gniliac1/COSIMA-Laserstar/README.md

COSIMA-Laserstar
================

Laserharfe

Hier entsteht das Repository für den COSIMA-Wettbewerb.

Weitere Infos folgen in Kürze ...
