gniliac1/COSIMA-Laserstar/Dokumentation/Abschlussbericht/Abschlussbericht.tex

\documentclass[a4paper,titlepage,12pt]{scrreprt}

\usepackage{ucs}
\usepackage[utf8x]{inputenc}
\usepackage[T1]{fontenc}
\usepackage[ngerman]{babel}
\usepackage{datetime}
\usepackage{amssymb}
\usepackage[hidelinks]{hyperref}
\usepackage{amsmath}
\usepackage{graphicx}
\usepackage{color}
\usepackage{titling}
\usepackage[figure]{hypcap}
\usepackage{subcaption}
\usepackage[official]{eurosym} % for €
\usepackage{units} % for correct spacing when using units
\usepackage{siunitx} % for tabular option S
\sisetup{unit-mode = text} % for using euro symbol
\usepackage{float}

% --------------Dokumenteinstellungen------------- %

% Schriftart ----------------------------------------------------------------
% - https://en.wikibooks.org/wiki/LaTeX/Fonts#Font_styles
% - https://de.overleaf.com/learn/latex/Font_typefaces#Reference_guide
\usepackage{tgadventor}

% Zeilenabstand ----------------------------------------------------------------
\usepackage{setspace}
\onehalfspacing  % 1,5 Zeilen (entspricht ang. dem doppelten Zelenabstand in Word)
\frenchspacing   % Kein doppeltes Leerzeichen nach '.' etc.

% Schusterjungen und Hurenkinder -----------------------------------------------
% Hiermit werden Schusterjungen und Hurenkinder verhindert
% Zur Info:
% http://de.wikipedia.org/wiki/Hurenkind_und_Schusterjunge
\clubpenalty = 10000
\widowpenalty = 10000
\displaywidowpenalty = 10000

% Seitenlayout --------------------------------------------------------------------
\usepackage{geometry}
\usepackage{vmargin}
% \setmarginsrb{leftmargin}{topmargin}{rightmargin}{bottommargin}%
%          {headheight}{headsep}{footheight}{footskip}
\setmarginsrb{35mm}{20mm}{25mm}{20mm} % 
			 {0mm}{10mm}{0mm}{10mm}
			 
% Tabellen --------------------------------------------------------------------
\usepackage{tabularx}
\newcolumntype{L}[1]{>{\raggedright\arraybackslash}p{#1}} % linksbündig mit Breitenangabe
\newcolumntype{C}[1]{>{\centering\arraybackslash}p{#1}} % zentriert mit Breitenangabe
\newcolumntype{R}[1]{>{\raggedleft\arraybackslash}p{#1}} % rechtsbündig mit Breitenangabe
			 
% Datum ------------------------------------------------------------------------
%	Diese Definition wird benötigt um auf der Titelseite nur Monat und Jahr aus-
%	zugeben.
\usepackage{datetime}
\newdateformat{titledate}{\monthname[\THEMONTH] \THEYEAR}
			 
\allowdisplaybreaks

% ------------Definitionsbereich------------ %

% zum Referenzieren
\newcommand{\refchapter}[1]{Kapitel~\ref{#1}}
\newcommand{\refsec}[1]{Abschnitt~\ref{#1}}
\newcommand{\reffig}[1]{Abbildung~\ref{#1}}
\newcommand{\reftab}[1]{Tabelle~\ref{#1}}

% für Quellen bei Bildern etc.
\newcommand{\source}[1]{{\scriptsize Quelle:~#1}}

% --------------Dokumentanfang------------- %

\begin{document}

% Titel
\include{raw/0_Titelblatt}

% Inhaltsverzeichnis
\tableofcontents
\newpage

% Einführung
\include{raw/1_Einleitung}
\include{raw/2_StandDerTechnik}
\include{raw/3_Aufbau}
\include{raw/4_Kosten}

\appendix

\include{raw/5_Ausblick}

\end{document}
