gniliac1/COSIMA-Laserstar/Dokumentation/Abschlussbericht/raw/5_Ausblick.tex

\chapter{Ausblick}
\label{ch:Ausblick}

An dieser Stelle möchten wir einen Ausblick geben, wie der von uns entwickelte Gestikulaser  weiterentwickelt wird. \\
Hier wäre zunächst einmal eine Verfeinerung der aktuell durchführbaren Gestenerkennung denkbar, die nicht nur die Stellung der Hand, sondern auch die Krümmung der einzelnen Finger berücksichtigt. Zu diesem Zweck wurde bereits ein Prototyp für einen Sensorhandschuh entwickelt, der in \reffig{fig:Sensorhandschuh} dargestellt ist.
\begin{figure}[H]
	\centering
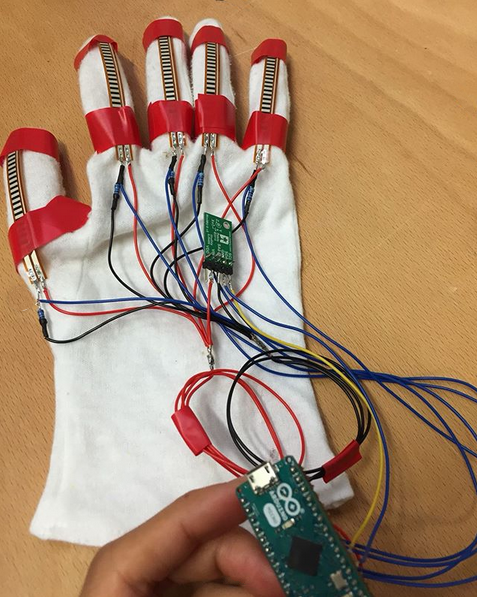
[picture p14: Dokumentation/figures/Sensorhandschuh.png]
	
	\caption{Aktueller Prototyp des Sensorhandschuhs. Es sind Biegesensoren für alle Finger, ein Gyroskop und ein Beschleunigungssensor im Einsatz. Bei der  
	Verarbeitung der Sensordaten kommt ein Arduino Micro zum Einsatz.}
	\label{fig:Sensorhandschuh}
\end{figure}
\noindent
Dieser könnte während der Trainingsphase vom Nutzer dazu verwendet werden, feinere Gesten aufzunehmen, wobei neben den von den Detektormodulen detektierten Photoströmen zusätzlich die Daten der auf dem Sensorhandschuh befindlichen Module gespeichert werden. Aktuell kommen hier Biegesensoren für jeden Finger, sowie ein Gyroskop und ein Beschleunigungssensor zum Einsatz. Diese verfeinerten Gestendaten stellen nun natürlich neue Herausforderungen an das Modell, das zur Auswertung der Photoströme im Live-Betrieb eingesetzt wird: Statt wie vorher den eingehenden Photoströmen nur das Klassenlabel einer Geste zuzuordnen, muss es nun in der Lage sein, auf Basis der gemessenen Photoströme die wahrscheinliche Lage der Hand, sowie die Krümmung der Finger vorauszusagen. Dieses Problem ist mathematisch deutlich schwieriger zu lösen, was nicht zuletzt an der deutlich höheren Anzahl an Parametern liegt, die bestimmt werden müssen, um eine ausreichende Aussagekraft des Modells zu gewährleisten. Aufgrund der höheren Anzahl an Parametern werden zudem auch mehr Daten benötigt, um das Modell zu trainieren. \\
Ebenfalls denkbar wäre eine Erweiterung auf dynamische Gesten, bei denen der Nutzer die Hand bewegt. In diesem Fall müssen die Daten der Photodioden im Live-Betrieb in Form einer Zeitreihe aufgenommen werden und das neuronale Netzmodell muss diese Zeitreihe mit einer Geste verknüpfen. Auch hier ergibt sich ein mathematisch deutlich komplexeres Problem, das ein aufwändigeres Training und viele Trainingsdaten erfordert. Die Erweiterung um dynamische Gesten könnte ebenfalls mit der Verwendung des Sensorhandschuhs kombiniert werden. \\
Auch die Wahl der Lichtquellen lässt noch Spielraum für künftige Änderungen. So könnte man z.B. statt den aktuell verbauten IR-LEDs Lichtquellen mit gepulsten Lichtstrahlen verwenden, um den Gestikulaser robuster gegenüber äußeren Einflüssen zu gestalten, da sich in diesem Fall die zu detektierenden Lichtsignale von möglichen Störsignalen durch eine deutlich höhere Intensität unterscheiden würden. Ebenfalls denkbar wäre der Einsatz einer Laserquelle, wodurch ein größerer Abstand zwischen der Hand des Nutzers und dem Gestikulaser realisiert werden könnte.
