gniliac1/COSIMA-Laserstar/Dokumentation/Abschlussbericht/raw/0_Titelblatt.tex

\newdateformat{mydate}{\monthname[\THEMONTH] \THEYEAR} 

\begin{titlepage}

	\newgeometry{left=30mm,right=-25mm,top=32mm,bottom=25mm}  
    
    % Kopfzeile
	\begin{table}[h!]
		\begin{tabular}{rp{5cm}l}
 		 & &  \\
		\end{tabular}
	\end{table}
    
    \small
	\parindent0pt
	
	\begin{center}
		\bfseries Projektmappe für den COSIMA-Wettbewerb 2018
	\end{center}
	
	\vspace*{15mm}
	\normalsize	
	
	\begin{center}
		%\huge
		%{\bfseries\sffamily Der Gestikulaser}
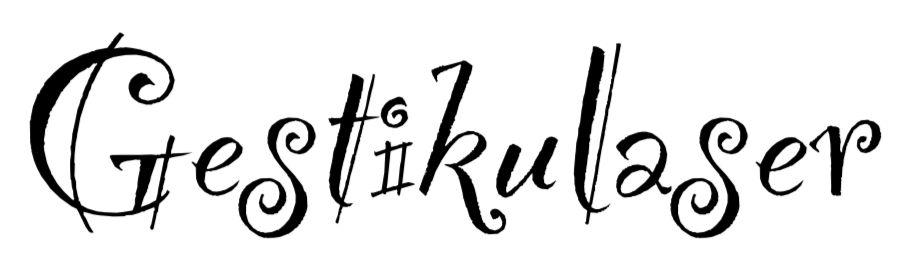
[picture p17: Dokumentation/Logos/GestikulaserSchriftzugOhneHut.PNG]
		
		\\ \vspace*{4mm}
		\large
		Die neue Möglichkeit der Gestenerkennung
	\end{center}
	
	\vfill
	
	\begin{center}
	\large \mydate{\today}
	\end{center}
	
	\centering
	
	\vfill
	
	\begin{center}
		Verfasst von \\[3ex]
		Christoph Behr \\
		Cailing Fu \\
		Nicole Grubert \\
		Anna Pryadun \\
		Daniel Wolff \\
	\end{center}
	
	\restoregeometry
	
\end{titlepage}
