gniliac1/COSIMA-Laserstar/Dokumentation/Abschlussbericht/alsWordFürChristoph.docx

\documentclass[fontsize=12pt]{scrreprt}

\usepackage{ucs}

\usepackage[utf8x]{inputenc}

\usepackage[T1]{fontenc}

\usepackage[ngerman]{babel}

\usepackage{datetime}

\usepackage{amsthm}

\usepackage{amssymb}

\usepackage[hidelinks]{hyperref}

\usepackage{enumitem}

\usepackage{amsmath}

\usepackage{graphicx}

\usepackage{color}

\usepackage{mdframed}

\usepackage{titling}

\usepackage[figure]{hypcap}

\usepackage{subcaption}

\usepackage{tabularx}

\usepackage{eso-pic} % for aligning the title page figures

\allowdisplaybreaks

% ------------Definitionsbereich------------ %

% zum Referenzieren

\newcommand{\refchapter}[1]{Kapitel~\ref{#1}}

\newcommand{\refsec}[1]{Abschnitt~\ref{#1}}

\newcommand{\reffig}[1]{Abbildung~\ref{#1}}

\newcommand{\reftab}[1]{Tabelle~\ref{#1}}

% --------------Dokumenteinstellungen------------- %

% Schriftart:

% - https://en.wikibooks.org/wiki/LaTeX/Fonts#Font_styles

% - https://de.overleaf.com/learn/latex/Font_typefaces#Reference_guide

\usepackage{helvet}

% --------------Dokumentanfang------------- %

\begin{document}

% Titel

\include{raw/0_Titelblatt}

% Inhaltsverzeichnis

\tableofcontents

\newpage

% Einführung

\include{raw/1_Einleitung}

\include{raw/2_StandDerTechnik}

\include{raw/3_Aufbau}

\include{raw/4_Kosten}

\appendix

\include{raw/5_Ausblick}

\end{document}

\chapter{Einleitung}

\label{ch:Einleitung}

\textcolor{red}{Was wurde gemacht? Was war die Motivation? Inwiefern besitzt das Projekt eine Alltagsrelevanz?}

Ziel unseres Projektes ist es, ein System zu entwickeln, welche Handgesten erkennt. Dabei sollen die Gesten individuell auf den Nutzer abgestimmt werden können, so dass eine möglichst genaue Gestenerkennung realisiert werden kann.

Bislang werden Gestenerkennungen meist mit Hilfe einer Kamera realisiert. Dabei wird ein Bild der Hand analysiert und dadurch eine Geste erkannt. Probleme: Bei Dunkelheit kann das System nicht eingesetzt werden. Gleiche Hintergrundfarbe wie die Hand ist nicht zu erkennen.

Modulares Stecksystem mit mehreren Komponenten, die sich für jede Anwendung in einem individuellen Muster bzw. einer individuellen Größe zusammenstecken lassen.

Praxisrelevanz:

1.) Berührungslose bedienung verschiedener Dinge wie ein ferngesteuertes Auto, Smart Home oder einer Drohne.

2.) Nutzung im Cave zur ganzkörper Gestensteuerung

Bisher basieren die meisten Gestenerkennungen auf der Bilderkennung einer Kamera.

\chapter{Stand der Technik}

\label{ch:StandDerTechnik}

\textcolor{red}{Wird vielleicht gelöscht. Außer irgendjemand hat Lust zu recherchieren.}

\chapter{Aufbau}

\label{ch:Funktionsweise und Aufbau}

Die Funktionsweise des Gestikulasers besteht aus der Detektion und Weiterverarbeitung von Lichtsignalen, welche mit einer Geste erzeugt werden. Dabei wird infrarotes Licht von einer LED Quelle durch die Hand reflektiert und mit Hilfe von verschiedenen Photodioden detektiert. Die durch die Photodioden erhaltenen Daten werden dann in einer Software weiterverarbeitet, welche mit Hilfe von Machine Learning die tatsächliche Handgeste erkennt. Von dort aus kann dann jedes beliebige Endgerät angesteuert werden.

\section{Transimpedanzverstärker}

\lable{Transimpedanzverstärker}

Die Verstärkerschaltung besteht aus zwei sogen. Transimpedanz Verstärkern.

Die Photodiode fungiert in ihm als Konstantstromquelle die einen kleinen Strom an das System abgibt mit Hilfe des Widerstandes R1 und des Kondensators C1 kann der Operationsverstärker (LM358) eine vom Microcontroller verarbeitbare hohe Spannung ausgeben.

Wichtig ist hier die möglichst genaue Wahl der Kapazität C1 ohne sie das System anfangen würde zu Schwingen

\math{C_1 = sqrt{{CI}over{R_1 * GBP}}}

Hierbei bedeutet GBP „Gain Bandwidth Product“ für den Operationsverstärker LM358 ist das GBP mit 1MHz im Datenblatt angegeben.

CI ist die Summe der beiden Sperrschichtkapazitäten der Photodiode und des Operationsverstärkers.

Typische Anwendungsgrößen für R1 liegen bei etwa 1MOhm

Daraus lässt sich die Bandbreite des Systems berechnen:

\math {f_3dB = sqrt{{GBP}over{2\pi * R1 * CI}}}

Für unser System liegt die Bandbreite bei etwa 73kHz.

\begin{figure}[h]

\centering

\includegraphics[scale=0.8]{figures/Transimpedanz.png}

\caption{\textcolor{black}{Schematische Darstellung des Transimpedanzverstärkersystems}}

\label{fig:Transimpedanz}

\end{figure}

\begin{figure}[h]

\centering

\includegraphics[scale=0.8]{figures/AblaufGestikulaser.png}

\caption{\textcolor{red}{Erklärung!}}

\label{fig:AblaufGestikulaser}

\end{figure}

Der Gestikulaser selbst besteht aus einer Platte, der Photoplatte, welche aus verschiedenen Steckmodulen zusammen gesteckt werden kann. Die Steckmodule bestehen aus einzelnen kleinen Boxen, in welche die Elektronik integriert ist. In der Mitte befindet sich der Oktokommander, welcher durch weitere Detektormodule erweitert werden kann. Auf jedes der Module befinden sich vier Photodioden um das reflektierte Licht zu messen.

\begin{figure}[h]

\centering

\includegraphics[scale=0.5]{figures/Photoplatte.png}

\caption{\textcolor{red}{Erklärung!}}

\label{fig:Fotoplatte}

\end{figure}

% ----------------------------------------------------------------------- %

\section{Oktokommander}

\label{sec:Oktokommander}

Der Oktokommander ist das Steuersystem der gesamten Photoplatte. In ihr befinden sich ein Arduino Micro, welcher die Signale aller Photodioden bearbeitet sowie einen i2c Expander. Durch den i2c Expander ist es möglich, jedes der Photodioden eine eigene Adresse zu zu weisen. Dies ist nötig, um die voneinander unabhängigen Signale der Photodioden richtig zuordnen zu können. Zusätzlich dazu befinden sich auf dem Oktokommander vier Infrarot LEDs sowie vier infrarot Photodioden. Um die vier infrarot Photodioden an zu steuern wird zusätzlich zum i2c Expander noch ein i2c Multiplexer sowie die dazu gehörende Verstärkerschaltung benötigt.

\textcolor{red}{Erklärung der Komponenten an Hand des Bildes}

\begin{figure}[h]

\centering

\includegraphics[scale=0.8]{figures/OktokommanderOffen.png}

\caption{\textcolor{red}{Erklärung!}}

\label{fig:OktokommanderOffen}

\end{figure}

Um den Oktokommander mit den Detektormodulen erweitern zu können wurden USB-2A Schnittstellen verwendet. Durch diese Schnittstellen können bis zu 7 Detektormodule, jeweils eines pro Seite eingekoppelt werden. Um eine größere Platte zu konstruieren können noch weitere Detektormodule an den bereits vorhandenen Detektormodule angeschlossen werden.

\textcolor{red}{Erklärung der Komponenten an Hand des Bildes}

\begin{figure}[h]

\centering

\includegraphics[scale=0.8]{figures/PrinzipskizzeOktokommander.png}

\caption{\textcolor{red}{Erklärung!}}

\label{fig:PrinzipskizzeOktokommander}

\end{figure}

% ----------------------------------------------------------------------- %

\section{Detektormodul}

\label{sec:Detektormodul}

Das Detektormodul besteht lediglich aus vier Photodioden und einem USB-2A Eingang. Dadurch kann das Detektormodul an den Oktokommander angeschlossen werden. Zur Ansteuerung der Photodioden wurde auch hier ein i2c Expander verwendet.

\textcolor{red}{Erklärung der Komponenten der Bilder}

\begin{figure}[h]

\centering

\includegraphics[scale=0.7]{figures/DetektormodulOffen.png}

\caption{\textcolor{red}{Erklärung!}}

\label{fig:DetektormodulOffen}

\end{figure}

\begin{figure}[h]

\centering

\includegraphics[scale=0.5]{figures/PrinzipskizzeDetektormodul.png}

\caption{\textcolor{red}{Erklärung!}}

\label{fig:PrinzipskizzeDetektormodul}

\end{figure}

% ----------------------------------------------------------------------- %

\section{Software}

\label{sec:Software}

Bei der für den Gestikulaser benötigten Software wurde komplett auf open-source verfügbare Programme und Bibliotheken gesetzt. Der Code auf den Microcontrollern wurde mit Hilfe der \href{https://www.arduino.cc/en/Main/Software}{Arduino IDE} entwickelt. Das Aufzeichnen der Daten, sowie das Aufstellen und Auswerten der Modelle erfolgt mit Hilfe von Python Skripten. Für die Erstellung der mathematischen Modelle, die bei der Erkennung der Gesten zum Einsatz kommen, wurde die \href{https://www.tensorflow.org/}{TensorFlow\texttrademark} Bibliothek verwendet.

\chapter{Marketing und Kosten}

\label{ch:Kosten}

Neben der Entwicklung unseres Produktes wurde im Laufe der Entwicklungszeit zusätzliche Öffentlichkeitsarbeiten geleistet. So wurde die Website \url{https://www.gestikulaser.de/} ins Leben gerufen sowie der Instagram Account \href{https://www.instagram.com/laserharptos/}{\texttt{laserharptos}} mit über 100 Abonnenten betreut.

Im Zuge dessen wurde auch Sponsoren angeworben, welche Interesse an der Unterstützung unseres Projektes hatten. \\

Folgende Sponsoren haben uns bei diesem Projekt unterstützt: \\

\begin{tabularx}{\textwidth}{r c}

Aconity GmbH & \noindent\parbox[c]{\hsize}{\includegraphics[scale=0.5]{figures/AconityLogo.png}} \\

& \\

Fraunhofer ILT & \noindent\parbox[c]{\hsize}{\includegraphics[scale=0.8]{figures/ILTLogo.png}} \\

& \\

TOS RWTH Aachen University & \noindent\parbox[c]{\hsize}{\includegraphics[scale=0.5]{figures/TOSLogo.png}} \\

& \\

Würth Electronik GmbH \& Co. KG & \noindent\parbox[c]{\hsize}{\includegraphics[scale=0.05]{figures/WuerthLogo.png}}

\end{tabularx} \\

%Durch diese Sponsoren war es uns möglich, die Kosten unserer

\chapter{Ausblick}

\label{ch:Ausblick}

\textcolor{red}{Erweiterung um Sensorhandschuh zur verbesserten Erkennung der Daten. Überarbeitung des Designs um die Module besser bzw. anders zusammen zu stecken.}

An dieser Stelle möchten wir einen Ausblick geben, wie der von uns entwickelte Gestikulaser weiterentwickelt werden könnte.

Hier wäre zunächst einmal eine Verfeinerung der aktuell durchführbaren Gestenerkennung denkbar, die nicht nur die Stellung der Hand, sondern auch die Krümmung der einzelnen Finger berücksichtigt. Zu diesem Zweck wurde bereits ein Prototyp für einen Sensorhandschuh entwickelt.

\begin{figure}[h]

\centering

\includegraphics[scale=0.75]{figures/Sensorhandschuh}

\caption{Aktueller Prototyp des Sensorhandschuhs. Es sind Biegesensoren für alle Finger, ein Gyroskop und ein Beschleunigungssensor im Einsatz. Bei der

Verarbeitung der Sensordaten kommt ein Arduino Micro zum Einsatz.}

\label{fig:Sensorhandschuh}

\end{figure}

Dieser könnte während der Trainingsphase vom Nutzer dazu verwendet werden, feinere Gesten aufzunehmen, wobei neben den von den Detektormodulen detektierten Photoströmen zusätzlich die Daten der auf dem Sensorhandschuh befindlichen Module gespeichert werden. Aktuell kommen hier Biegesensoren für jeden Finger, sowie ein Gyroskop und ein Beschleunigungssensor zum Einsatz. Diese verfeinerten Gestendaten stellen nun natürlich eine neue Herausforderung an das Modell, das zur Auswertung der Photoströme im Live-Betrieb eingesetzt wird: Statt wie vorher den eingehenden Photoströmen nur das Klassenlabel einer Geste zuzuordnen, muss es nun in der Lage sein, auf Basis der gemessenen Photoströme die wahrscheinliche Lage der Hand, sowie die Krümmung der Finger vorauszusagen. Dieses Problem ist mathematisch deutlich schwieriger zu lösen, was nicht zuletzt an der deutlich höheren Anzahl an Parametern liegt, die bestimmt werden müssen, um eine ausreichende Aussagekraft zu gewährleisten. Aufgrund der höheren Anzahl an Parametern werden zudem auch mehr Daten benötigt, um das Modell zu trainieren.

Ebenfalls denkbar wäre eine Erweiterung auf dynamische Gesten, bei denen der Nutzer die Hand bewegt. In diesem Fall müssen die Daten der Photodioden im Live-Betrieb in Form Zeitreihe aufgenommen werden und das neuronale Netzmodell muss diese Zeitreihe mit einer Geste verknüpfen. Auch hier ergibt sich ein mathematisch deutlich komplexeres Problem, das ein aufwändigeres Training und viele Trainingsdaten erfordert. Die Erweiterung um dynamische Gesten könnte ebenfalls mit der Verwendung des Sensorhandschuhs kombiniert werden.
