gniliac1/COSIMA-Laserstar/Dokumentation/Poster/Poster.pdf

# Gestikulaser

# Christoph Behr, Cailing Fu, Nicole Grubert, Anna Pryadun, Daniel Wolff

### 1. Unsere Vision

Da die Interaktion zwischen Mensch und Computer immer mehr in unseren Alltag integriert wird, wird zunehmend ver-
sucht, diese Kommunikation moglichst nat ¨ | urlich zu gestal- ¨
ten. Hierbei spielen Gestenerkennungssysteme eine wichtige Rolle.
Mit dem Gestikulaser haben wir ein neues Gestenerkennungssystem entwickelt, um statische Handgesten eines Menschen zu erkennen und diese zur Interaktion mit einem Endgerat zu nutzen. Dabei soll der Gestikulaser nicht mit ¨ einer Kamera arbeiten, wie die meisten heute verfugbaren ¨ Systeme, sondern stattdessen soll die Hand des Nutzers mit Infrarot-LEDs beleuchtet und die Gesten durch die erzeugten Reflektionsmuster erkannt werden. Eine auf diese Weise realisierte Gestenerkennung ist nicht nur robust gegenuber sichtbaren Licht, sondern kann auch in vollkom- ¨ mener Dunkelheit betrieben werden.

### 2. Der Gestikulaser

Hardware
- Photoplatte mit Photodioden und LEDs zur Beleuchtung der Hand und Detektion der reflektierten Strahlung
- Mikrocontroller zum Auslesen der Sensordaten Software
- Auslesen der Sensordaten uber den Mikrocontroller und ¨ Kommunikation mit dem externen Computer
- Aufbau und Training eines neuronalen Netzmodells zur Erkennung der Gesten

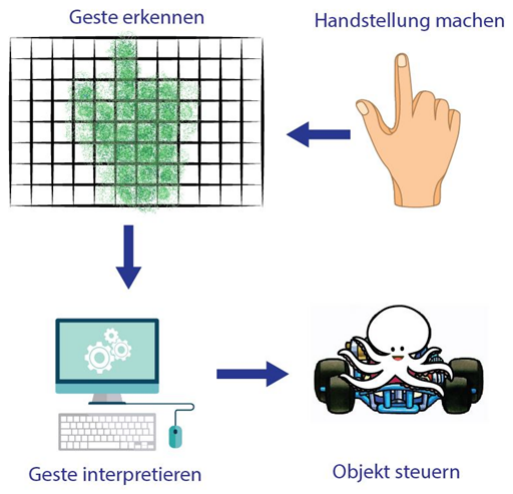
[picture p57: figure]

Abbildung 1: Schematischer Darstellung der Funktionsweise des Gestikulasers.

### 3. Die Beta-Version

- Anordnung der Photodioden in einem festgelegten Muster
- Arduino Uno zur Auswertung der Sensordaten
- Maximal 16 Photodioden anschließbar

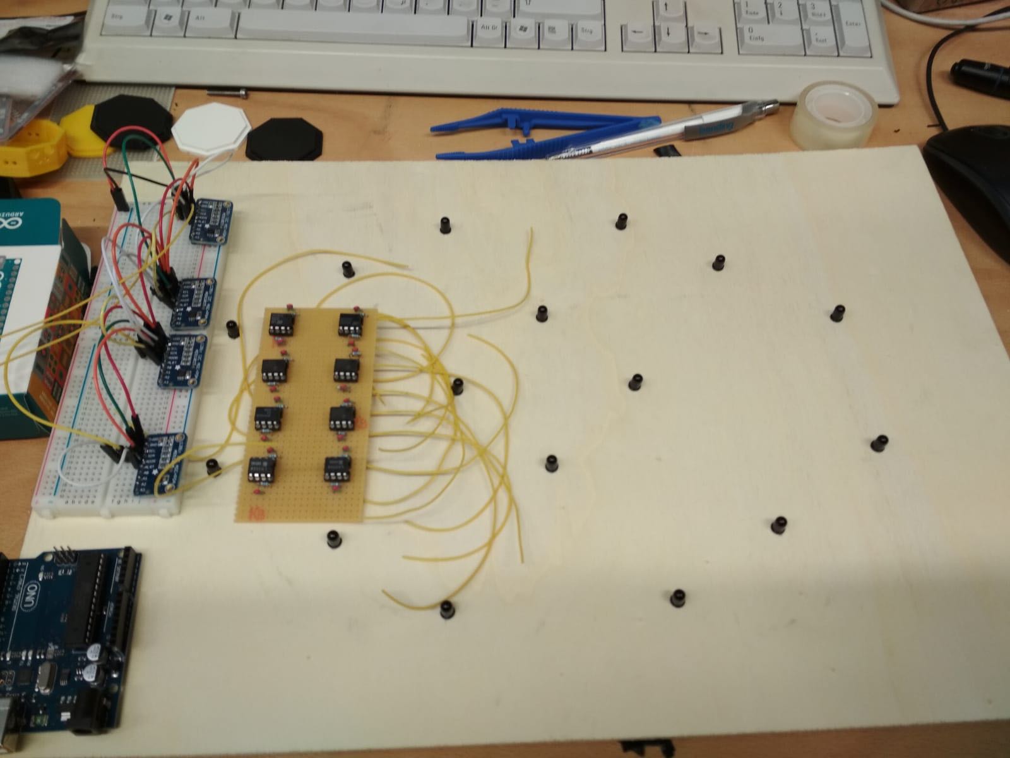
[picture p58: figure]

Abbildung 2: Die Beta-Version der Photoplatte: Die Elektronik ist auf einer Steckplatine untergebracht, die Photodioden sind fest in der Platte verbaut.

Nachdem unsere Idee funktionierte, wollten wir nun unseren Gestikulaser modularer zu gestalten. Eine aus verschiedenen Steckmodulen zusammensetzbare Photoplatte sollte nun helfen, dieses Ziel zu erreichen.

### 4. Photoplatte

- Modulares Stecksystem aus insgesamt acht Komponenten
- Zentral gelegene, fest verbaute Lichtquelle
- Variable Anordnung der Photodioden
- Erweiterbar auf bis zu 128 Photodioden

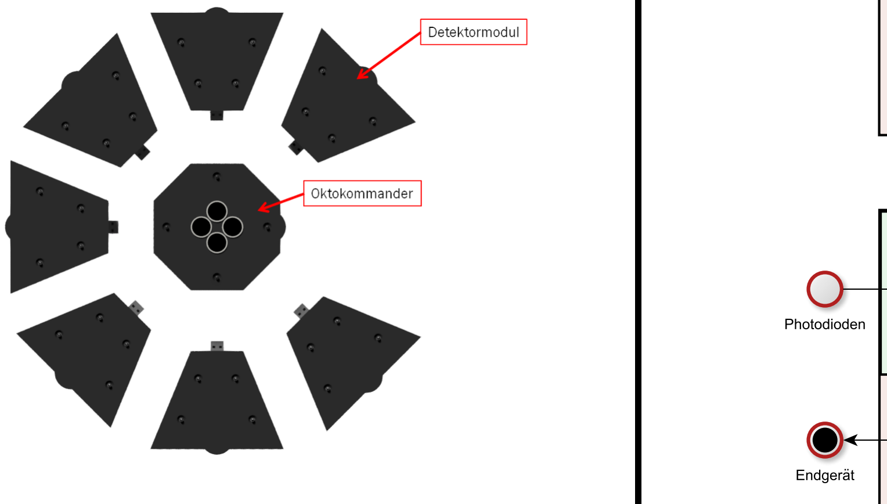
[picture p59: figure]

Abbildung 3: Die neue modulare Photoplatte setzt sich aus einem Oktokommander und bis zu sieben Detektormodulen zusammen.

### 5. Oktokommander

Der Oktokommander ist das Steuersystem der gesamten Photoplatte. Er enthalt: ¨
- Einen Arduino Micro
- Einen I2C Multiplexer
- Einen I2C AD-Wandler inklusive Verstarkerschaltung ¨
- Vier Photodioden
- Vier infrarot LED Quellen
- Sieben USB-Anschlusse f ¨ ur die Detektormodule ¨

Abbildung 4: Explosionsdarstellung des Oktokommanders.

### 6. Detektormodul

Die Detektormodule sollen die Lichtreflexionen der Hand detektieren. Sie enthalten jeweils:
- Vier Photodioden
- Einen I2C AD-Wandler inklusive Verstarkerschaltung ¨
- Einen USB-Stecker zum Anschluss an den Oktokommander

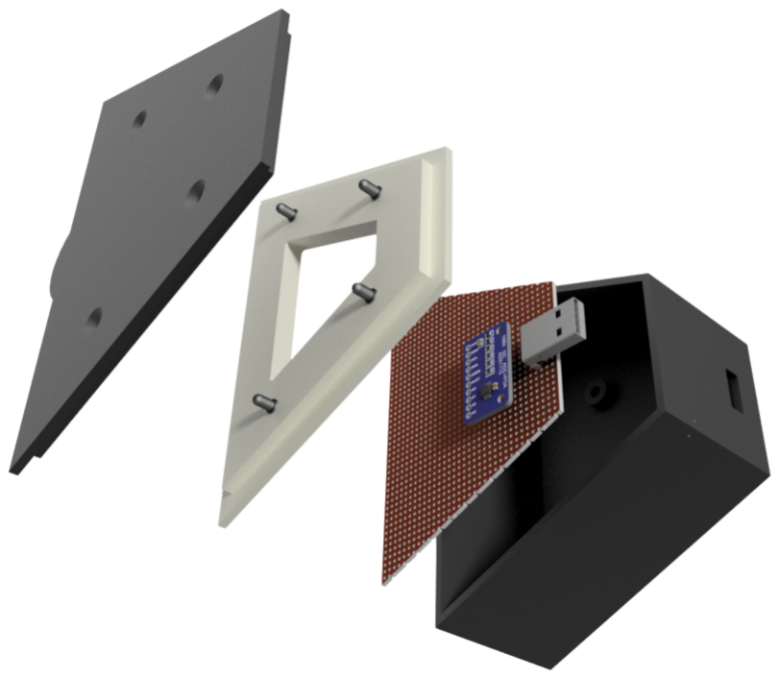
[picture p60: figure]

Abbildung 5: Explosionsdarstellung eines Detektormoduls.

### 7. Software

Die Kommunikation zwischen dem Mikrocontroller und dem Computer erfolgt uber ¨ Python Skripte, fur die Erstellung ¨ des neuronalen Netzes wurde TensorFlow

TMverwendet.
| Trainingsphase

Live-Betrieb

### 8. Ausblick

- Erkennung feinerer Gesten durch Berucksichtigung der ¨ Krummung der einzelnen Finger ¨
- Erweiterung auf dynamische Gesten
- Erhohung des Abstands durch mehr Lichtleistung ¨

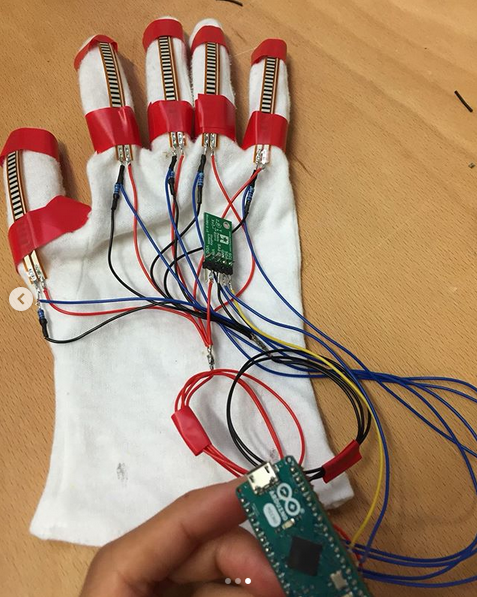
[picture p61: figure]

Abbildung 6: Aktueller Prototyp eines Sensorhandschuhs. Es sind Biegesensoren fur alle Finger, ein Gyroskop und ein ¨ Beschleunigungssensor im Einsatz. Die Sensordaten werden von einem Arduino Micro verarbeitet.

### 9. Sponsoren

Ein besonderen Dank gilt unseren Sponsoren:

Aconity3D GmbH

Fraunhofer ILT

Wurth Electronik ¨
GmbH Co. KG
