gniliac1/COSIMA-Laserstar/Dokumentation/Abschlusspräsi.pdf

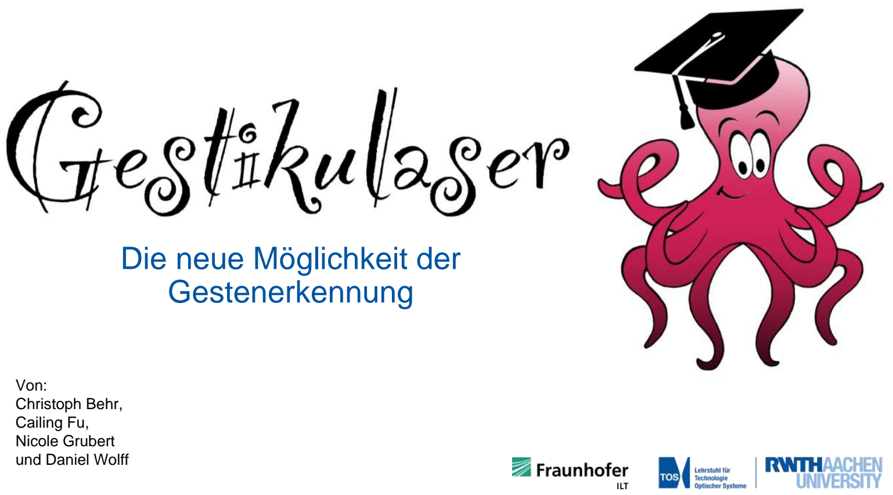
[picture p69: page 1]

# Die neue Möglichkeit der Gestenerkennung

# Von:

Christoph Behr,
Cailing Fu,

# Nicole Grubert und Daniel Wolff

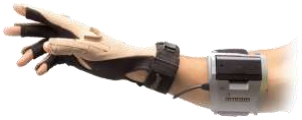
[picture p70: figure]
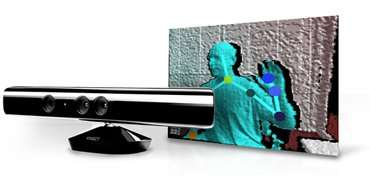
[picture p71: figure]

Gestikulaser – Die neue Möglichkeit der Gestenerkennung | Christoph Behr, Cailing Fu, Nicole Grubert, Daniel
Wolff | Institut für Technologie Optischer Systeme | 16.11.2018

# Motivation

# Stand der Technik:

## - Gerätebasierte Gestensteuerung - Sensorhandschuh

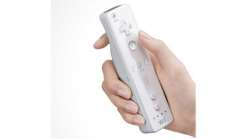
[picture p72: figure]

## - Wii Controller - Kamerabasierte Gestensteuerung - Kinect Erweiterung für die XBox

# Unser Ziel:

## - Eine neue Art der Gestenerkennung einführen!

# Der Gestikulaser

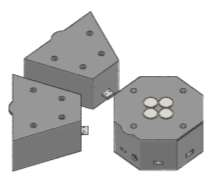
[picture p73: figure]
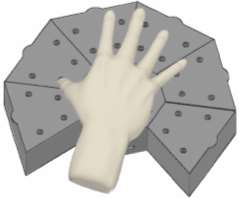
[picture p74: figure]

## Steckmodule für leichten Transport und Aufbau

## Erkennen von Mustern durch Lichtreflexionen der Hand

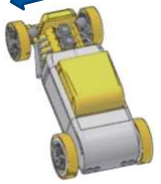
[picture p75: figure]
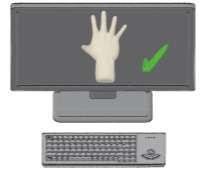
[picture p76: figure]

## Interpretation der Reflexionsmuster anhand eines Machine Learning Algorithmus

## Steuern eines beliebigen Endgerätes

# Photoplatte

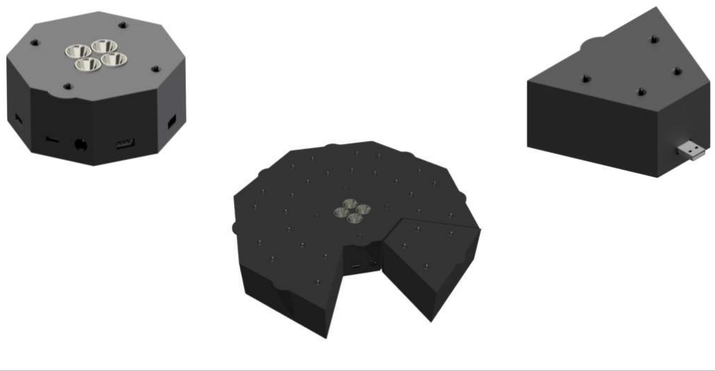
[picture p77: figure]

# Oktokommander

## IR-LEDs

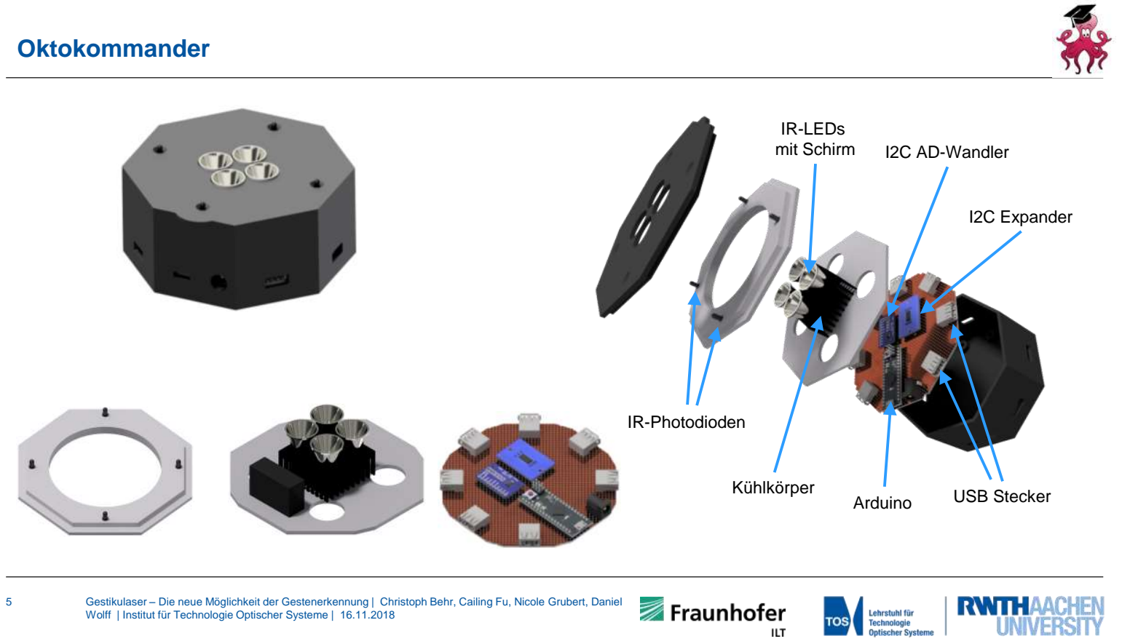
[picture p78: page 5]

## IR-Photodioden

## Kühlkörper

## mit Schirm

## Arduino

## I2C Expander

## I2C AD-Wandler

## USB Stecker

# Detektormodul

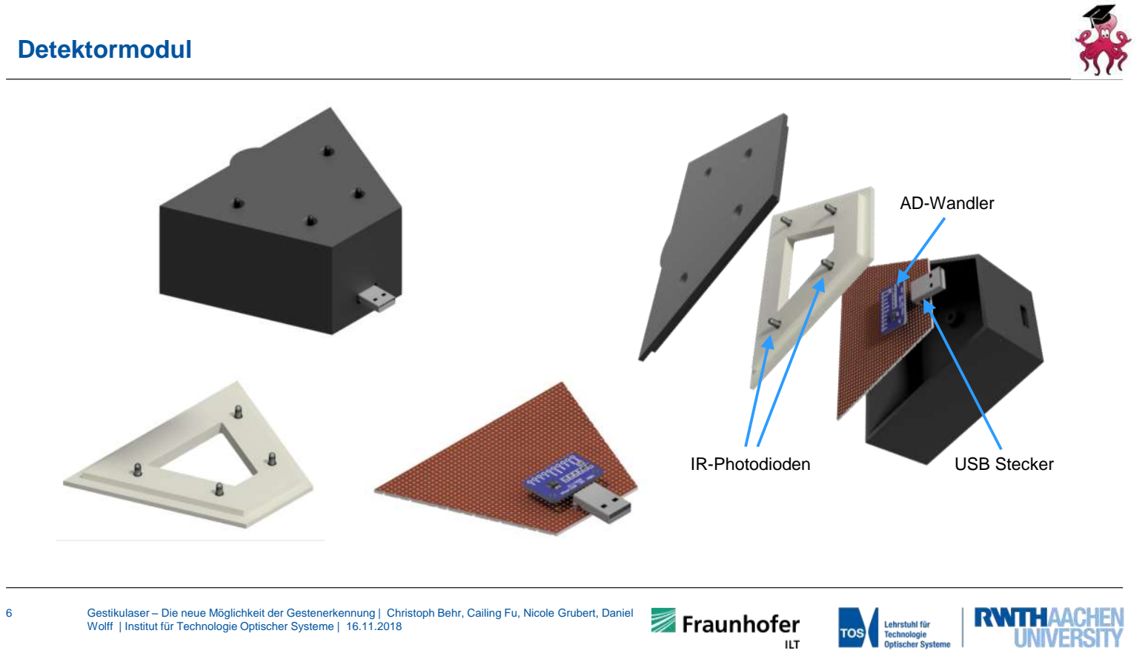
[picture p79: page 6]

## AD-Wandler

IR-Photodioden | USB Stecker

# Anlernphase

## Sensorhandschuh

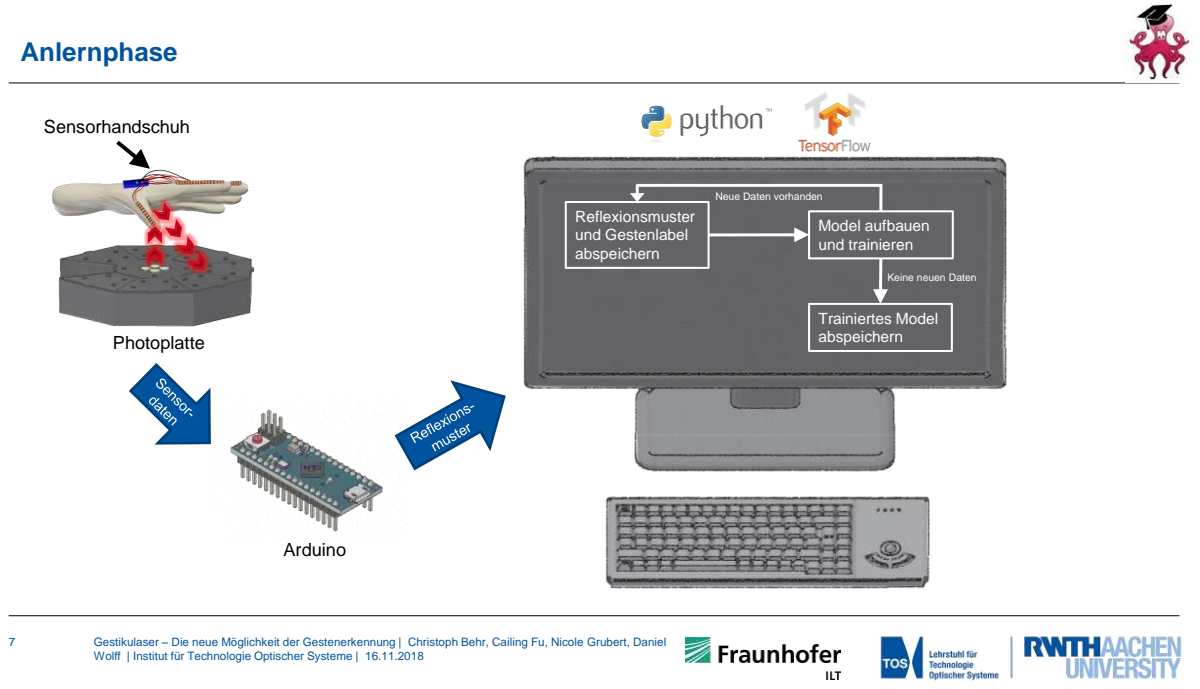
[picture p80: page 7]
Photoplatte; Reflexionsmuster und Gestenlabel abspeichern; Model aufbauen und trainieren; Trainiertes Model abspeichern; Arduino

Neue Daten vorhanden

Keine neuen Daten

# Live Betrieb

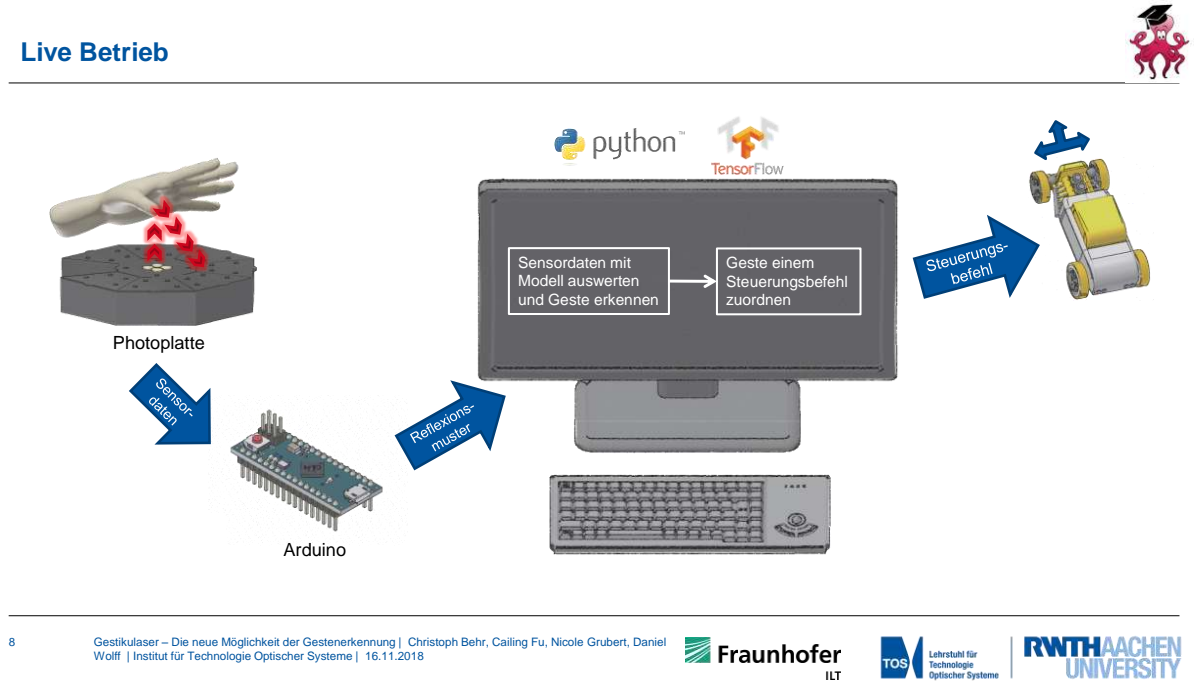
[picture p81: page 8]
Geste einem Steuerungsbefehl zuordnen; Photoplatte; Arduino

Sensordaten mit
Modell auswerten
und Geste erkennen

# Vorteile des Gestikulasers

# Bekannte

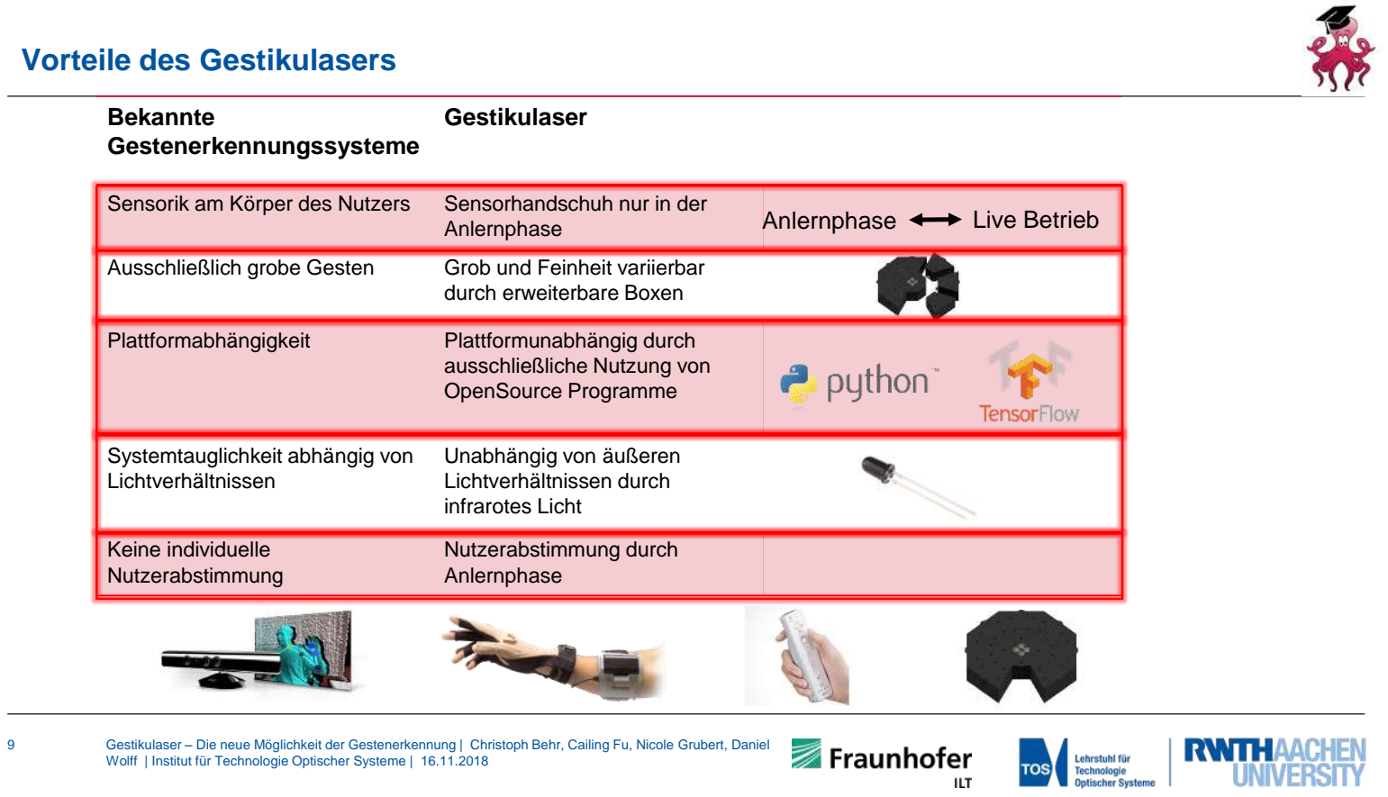
[picture p82: page 9]

# Gestenerkennungssysteme

# Gestikulaser

Sensorik am Körper des Nutzers | Sensorhandschuh nur in der Anlernphase
Ausschließlich grobe Gesten | Grob und Feinheit variierbar durch erweiterbare Boxen
Plattformabhängigkeit | Plattformunabhängig durch ausschließliche Nutzung von OpenSource Programme
Systemtauglichkeit abhängig von Lichtverhältnissen | Unabhängig von äußeren Lichtverhältnissen durch infrarotes Licht
Keine individuelle Nutzerabstimmung | Nutzerabstimmung durch Anlernphase
Anlernphase | Live Betrieb

# Anwendungsmöglichkeiten

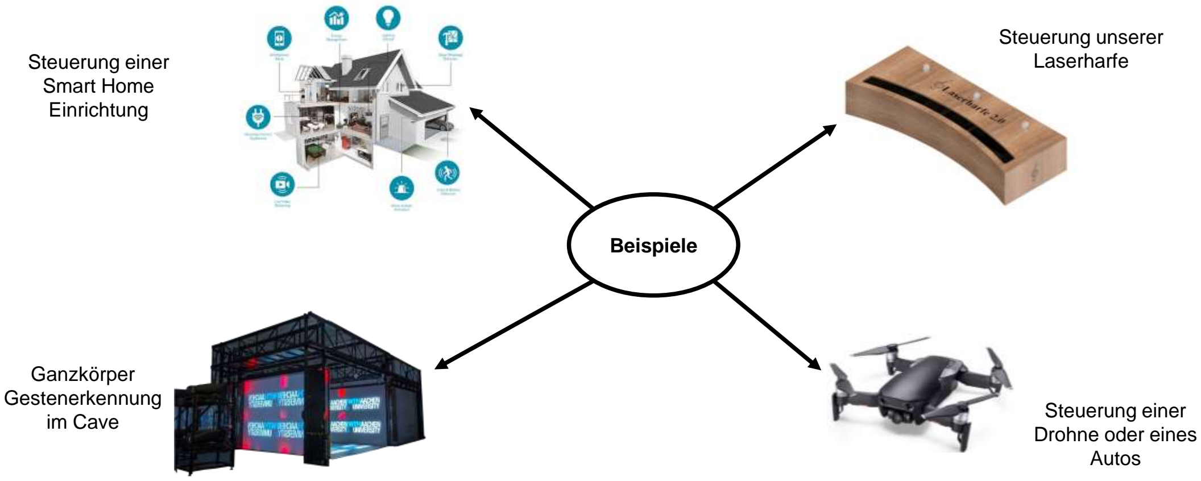
[picture p83: figure]
Beispiele; Steuerung einer Drohne oder eines Autos; Steuerung unserer; Steuerung einer; Laserharfe; Smart Home Einrichtung; Ganzkörper Gestenerkennung im Cave

# Sponsoren

# Wir danken unseren Sponsoren für die Unterstützung:

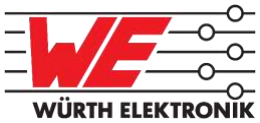
[picture p84: figure]

# Würth Elektronik

# Aconity 3D

# Fraunhofer ILT

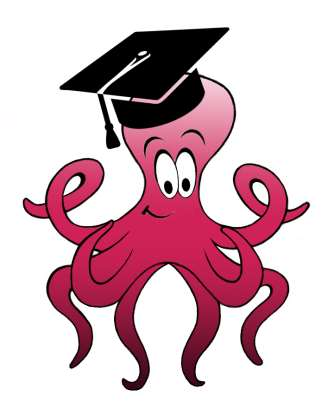
[picture p85: figure]

# Vielen Dank für Ihre Aufmerksamkeit
