gniliac1/COSIMA-Laserstar/Marketing/Gestikulaser.pdf

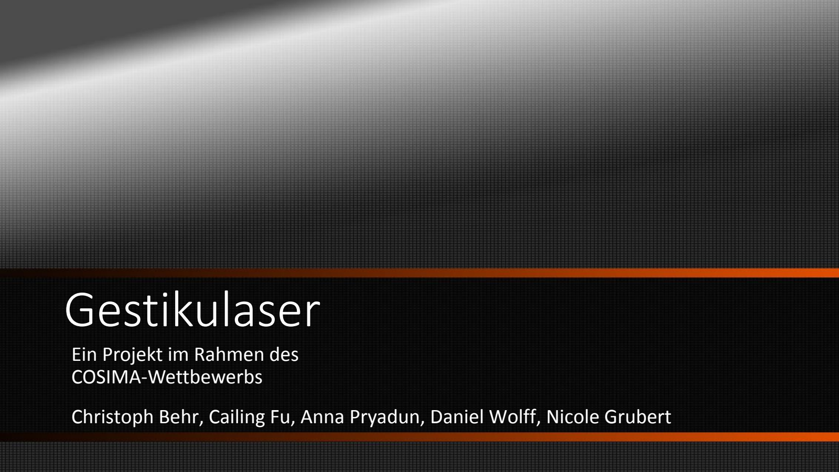
[picture p86: page 1]

# Gestikulaser

## Ein Projekt im Rahmen des COSIMA-Wettbewerbs

## Christoph Behr, Cailing Fu, Anna Pryadun, Daniel Wolff, Nicole Grubert

Wir sind..

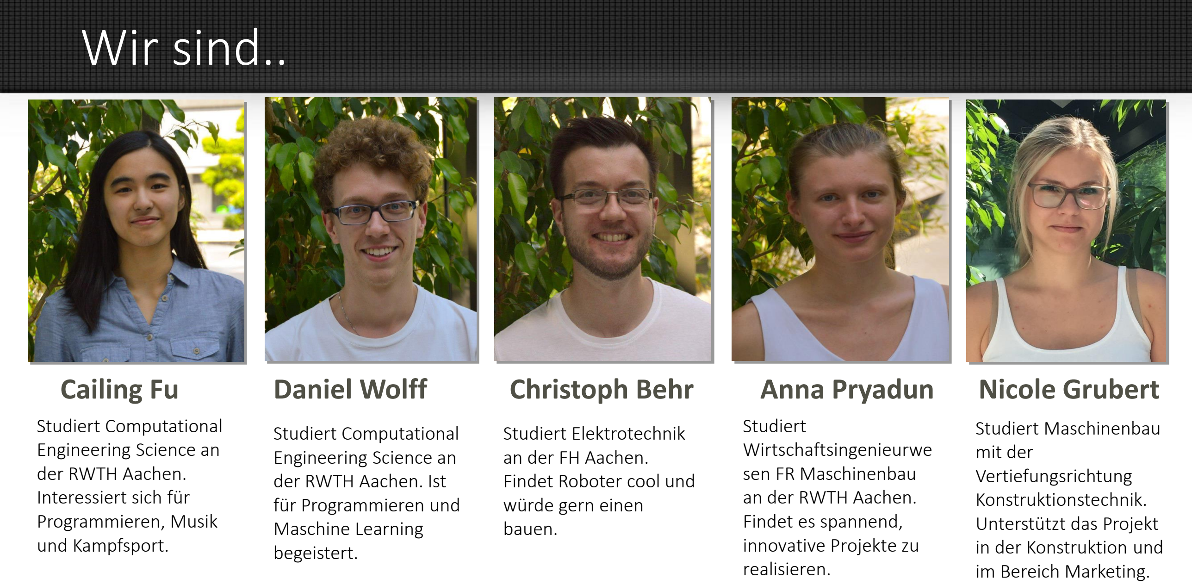
[picture p87: page 2]

## Cailing Fu

Studiert Computational
Engineering Science an
der RWTH Aachen.
Interessiert sich für
Programmieren, Musik
und Kampfsport.

## Daniel Wolff

Studiert Computational
Engineering Science an
der RWTH Aachen. Ist
für Programmieren und
Maschine Learning
begeistert.

## Christoph Behr

Studiert Elektrotechnik
an der FH Aachen.
Findet Roboter cool und
würde gern einen
bauen.

## Anna Pryadun

Studiert
Wirtschaftsingenieurwe
sen FR Maschinenbau
an der RWTH Aachen.
Findet es spannend,
innovative Projekte zu
realisieren.

## Nicole Grubert

Studiert Maschinenbau
mit der
Vertiefungsrichtung
Konstruktionstechnik.
Unterstützt das Projekt
in der Konstruktion und
im Bereich Marketing.

# Der COSIMA-Wettbewerb

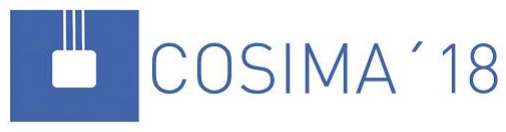
[picture p88: figure]

Competition of Students in Microsystems Applications Studentenwettbewerb im Bereich Mikrosystemtechnik

Was ist COSIMA?

13. - 16. November 2018, electronica Messe München

Wann & Wo:

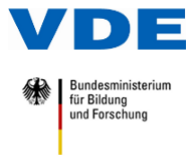
[picture p89: figure]

Veranstalter:

Verband der Elektrotechnik Elektronik und Informationstechnik (VDE)
Bundesministerium für Bildung und Forschung.

# Der COSIMA-Wettbewerb

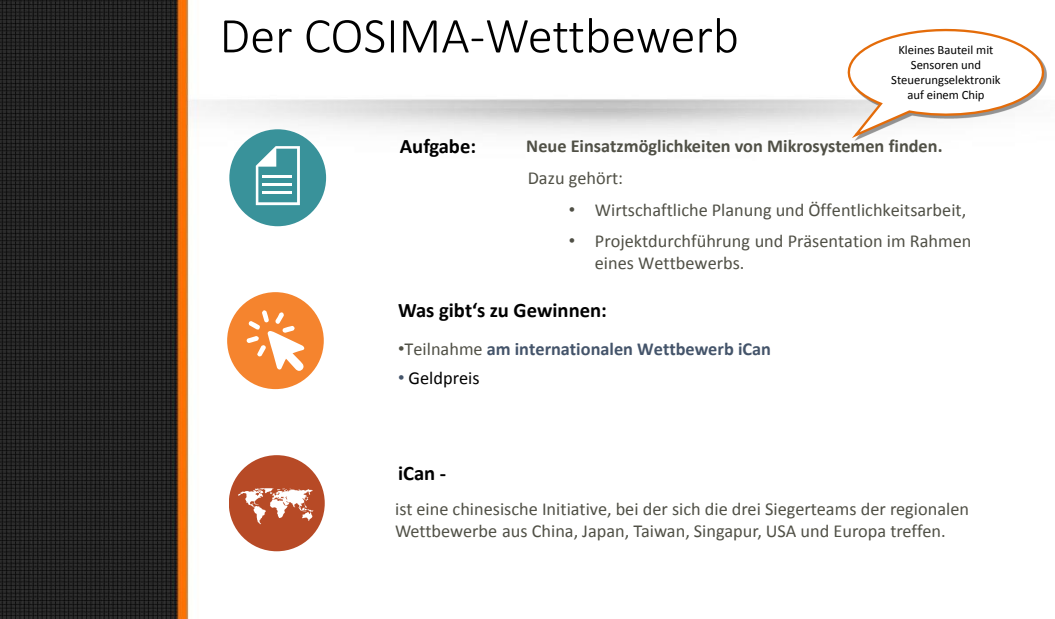
[picture p90: page 4]
Aufgabe:; Neue Einsatzmöglichkeiten von Mikrosystemen finden.; iCan -

Kleines Bauteil mit
Sensoren und
Steuerungselektronik
auf einem Chip

Dazu gehört:
• Wirtschaftliche Planung und Öffentlichkeitsarbeit,
• Projektdurchführung und Präsentation im Rahmen
eines Wettbewerbs.

Was gibt‘s zu Gewinnen:

•Teilnahme am internationalen Wettbewerb iCan
• Geldpreis

ist eine chinesische Initiative, bei der sich die drei Siegerteams der regionalen
Wettbewerbe aus China, Japan, Taiwan, Singapur, USA und Europa treffen.

# Unser Ziel – Der Gestikulaser

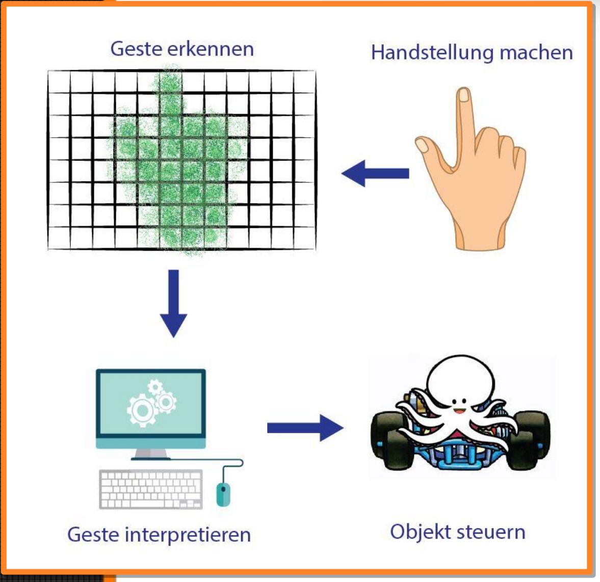
[picture p91: figure]

## Wir wollen eine portable und vielfältig einsetzbare intelligente

Gestensteuerung entwerfen.

## Hierbei sollen verschiedene Gesten einer Hand durch das Auswerten von Reflexionsmustern erkannt und basierend auf der Geste bestimmte Aktionen an einem

Endgerät gesteuert werden.

## Durch die Verwendung eines Sensorhandschuhs zu Beginn der Inbetriebnahme, kann die Gestenerkennung individuell auf

den Benutzer angepasst werden.

# Anlernphase

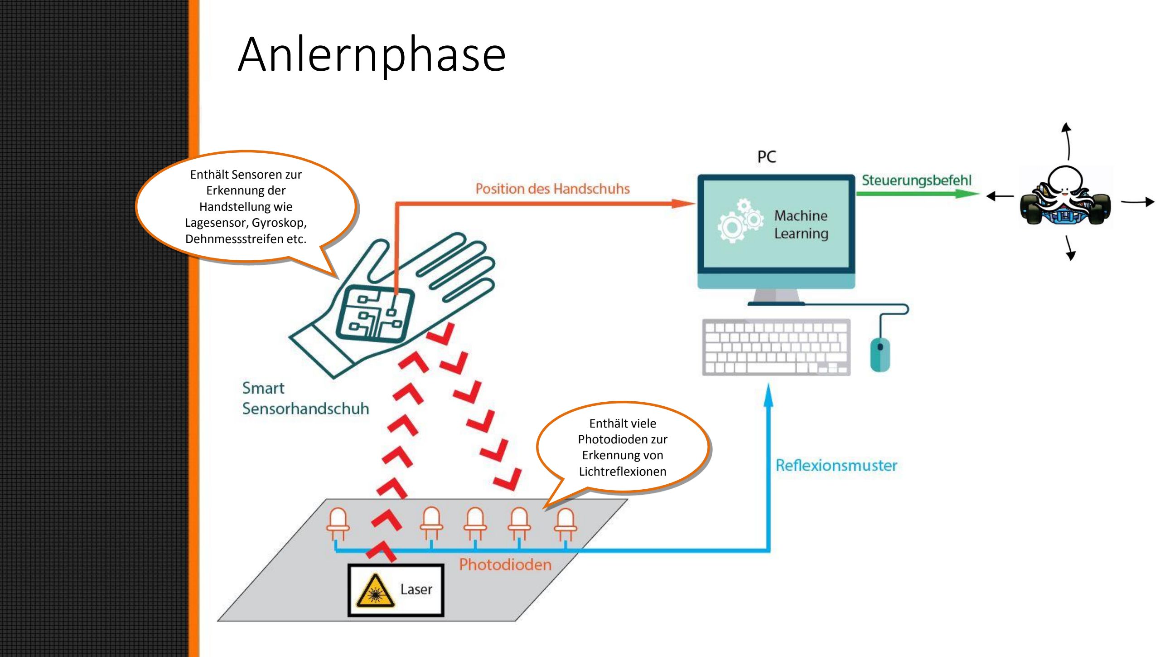
[picture p92: page 6]

Enthält Sensoren zur
Erkennung der
Handstellung wie
Lagesensor, Gyroskop,
Dehnmessstreifen etc.

Enthält viele
Photodioden zur
Erkennung von
Lichtreflexionen

# Betrieb

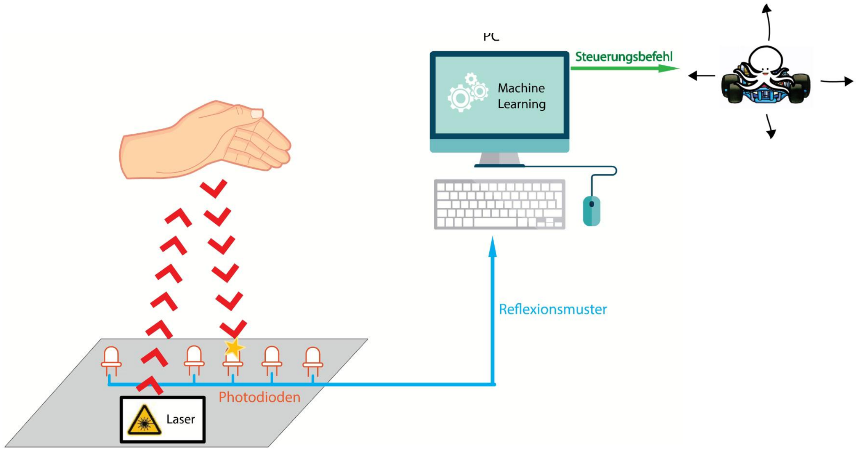
[picture p93: figure]

# Projektübersicht

# Die Realisierung der Gestenerkennung erfolgt in 5 Schritten:

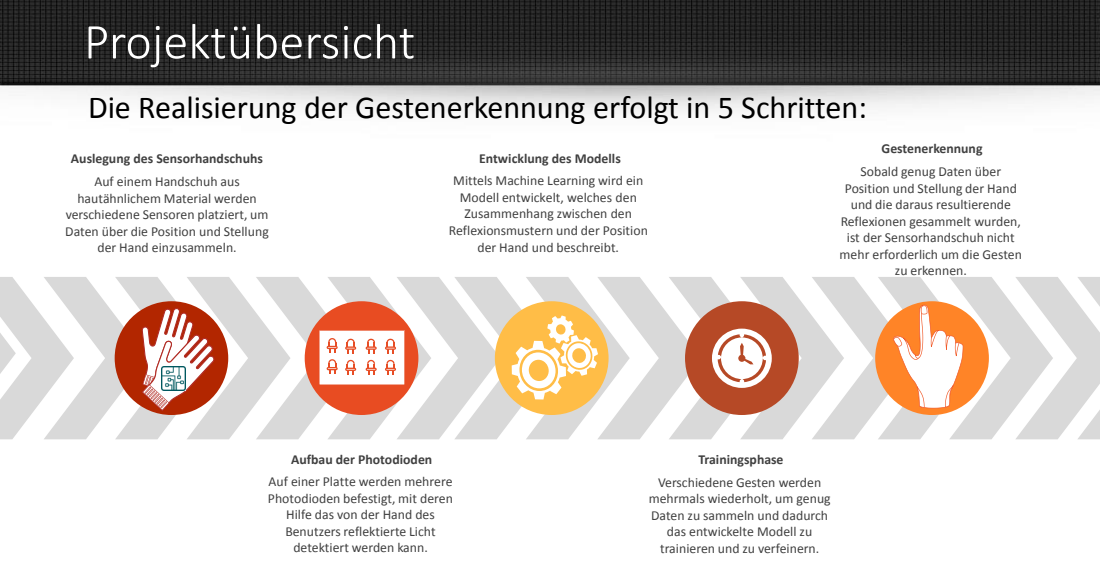
[picture p94: page 8]
zu erkennen.

Gestenerkennung
Sobald genug Daten über
Position und Stellung der Hand
und die daraus resultierende
Reflexionen gesammelt wurden,
ist der Sensorhandschuh nicht
mehr erforderlich um die Gesten

Auslegung des Sensorhandschuhs
Auf einem Handschuh aus
hautähnlichem Material werden
verschiedene Sensoren platziert, um
Daten über die Position und Stellung
der Hand einzusammeln.

Entwicklung des Modells
Mittels Machine Learning wird ein
Modell entwickelt, welches den
Zusammenhang zwischen den
Reflexionsmustern und der Position
der Hand und beschreibt.

Aufbau der Photodioden
Auf einer Platte werden mehrere
Photodioden befestigt, mit deren
Hilfe das von der Hand des
Benutzers reflektierte Licht
detektiert werden kann.

Trainingsphase
Verschiedene Gesten werden
mehrmals wiederholt, um genug
Daten zu sammeln und dadurch
das entwickelte Modell zu
trainieren und zu verfeinern.

# Photomatrix

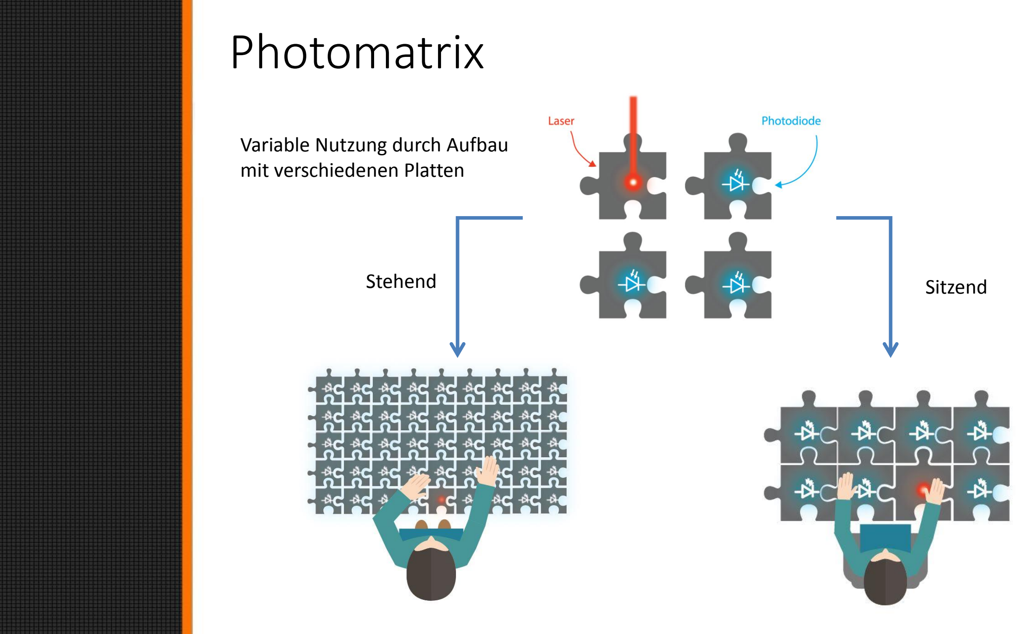
[picture p95: page 9]

Stehend | Sitzend

Variable Nutzung durch Aufbau mit verschiedenen Platten

# Photoplatte

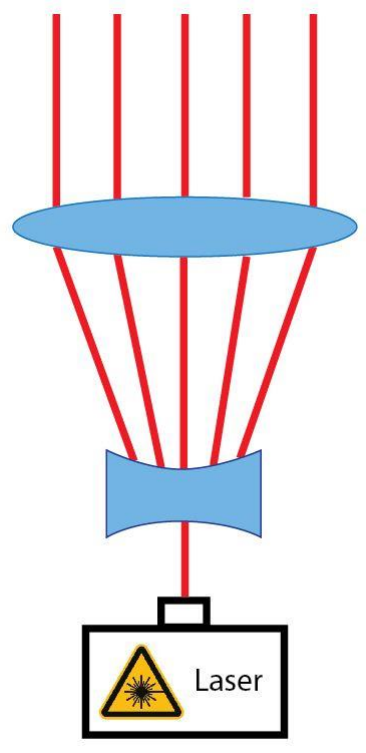
[picture p96: figure]

Aufweitung des Lasers
durch ein optisches System

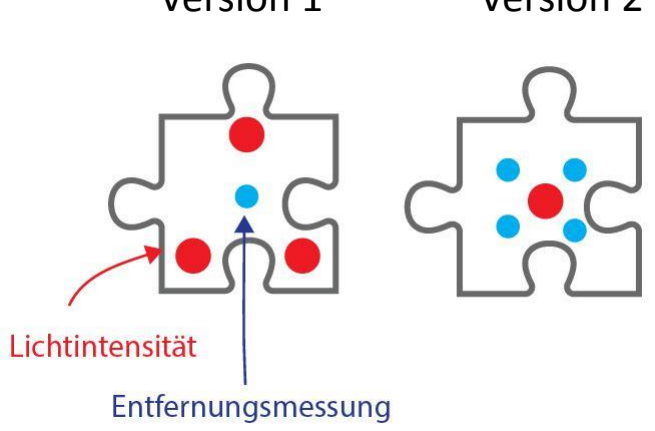
[picture p97: figure]

Platzierung des Lasers auf eine Platte mit Entfernungsmessung zur Erkennung der Hand

Version 1 | Version 2

# Unser Produkt

## Der Gestikulaser

- Portable, intelligente Gestensteuerung - Modular aufgebaute Photoplatten zur flexiblen Positionierung der Photodioden und der Strahlquelle - Vielfältig einsetzbar aufgrund der freien Kombinationsmöglichkeit der Photoplatten - Gewährleistung der Strahlensicherheit dank einer integrierten Leistungsregulierung der Strahlquelle - Individuelle Anpassung an die Gesten des Benutzers durch die Verwendung von Machine Learning Strategien

# Anwendungsmöglichkeiten

## Anwendungen

## - Steuern eines ferngesteuerten Autos ohne Fernsteuerung - Vereinfachte Bedienung einer Laserharfe - Steuerung einer Smart Home Einrichtung - Nutzung des gesamten Körpers zur Erzeugung von Reflexionen (z.B. als Anwendung in einer Cave)

# Kostenplanung

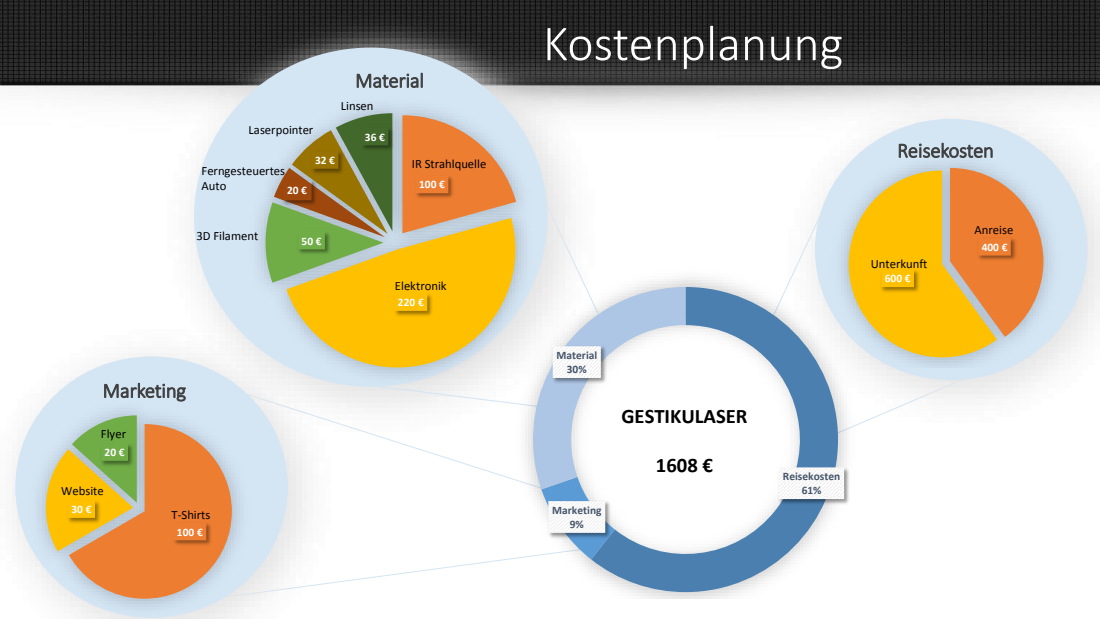
[picture p98: page 13]
Reisekosten 61%; Marketing 9%; Material 30%; GESTIKULASER; Marketing; T-Shirts; Website; Flyer; Material; Elektronik; IR Strahlquelle; 3D Filament; Laserpointer; Reisekosten; Anreise; Unterkunft; Ferngesteuertes Auto; Linsen

# Gegenleistungen für Sponsoren

# Wir können unsere

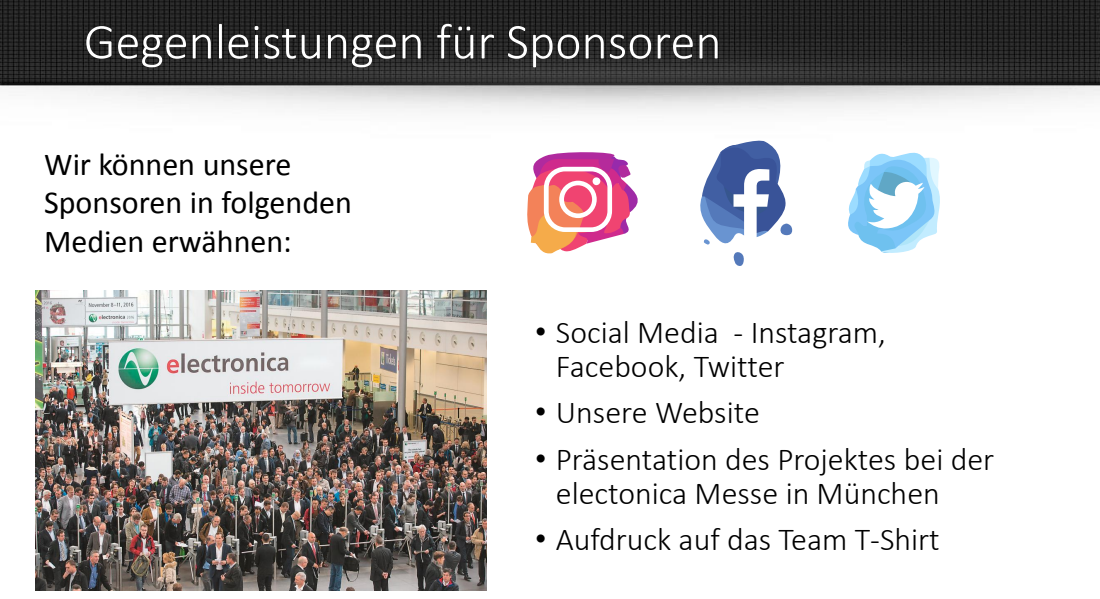
[picture p99: page 14]

Sponsoren in folgenden
Medien erwähnen:

• Social Media - Instagram,
Facebook, Twitter
• Unsere Website
• Präsentation des Projektes bei der
electonica Messe in München
• Aufdruck auf das Team T-Shirt

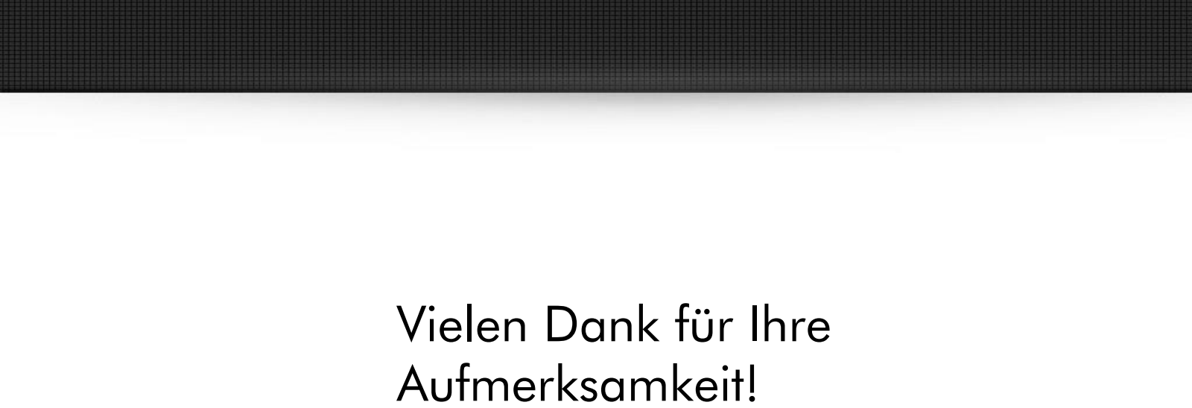
[picture p100: page 15]

# Vielen Dank für Ihre Aufmerksamkeit!
