gniliac1/COSIMA-Laserstar/Dokumentation/Flyer.tex

\documentclass[a4paper,12pt,notumble]{leaflet}

\usepackage[utf8]{inputenc}
\usepackage[T1]{fontenc}
\usepackage{Alegreya}

\usepackage{wasysym}
\usepackage{xcolor}
\usepackage{graphicx}

\renewcommand*{\sectfont}{\scshape}
\renewcommand*{\descfont}{\bfseries\scshape}

%\AddToBackground*{1}{%
% \put (0,0) 
%  {\rotatebox{33}{\resizebox{30cm}{!}{\color{lightgray}CLASSIFIED}}}%
%}

\AddToBackground{1}{%
 \put
 (\LenToUnit{0.5\paperwidth},\LenToUnit{0.5\paperheight}) 
 {\oval(\LenToUnit{0.95\paperwidth},\LenToUnit{0.95\paperheight})}%
}

\CutLine{6}

\begin{document}
\begin{center}\bfseries\Huge
Gestikulaser

\vfill

\normalsize
\begin{tabular}{c}
Secret Lab of Experimental Stuff\\
University of Somewhere
\end{tabular}

\vfill

\begin{tabular}{c}
Department of Stripy Confectioners\\
College of Somewhere Else
\end{tabular}

\vfill


\end{center}

\newpage
\raggedright

\section{Secret Lab of Experimental Stuff}

The Secret Lab of Experimental Stuff is a top-secret laboratory
whose existence is highly classified so don't tell anyone about it
or we'll get really cross with you.

The University of Somewhere denies all knowledge of the Secret Lab
of Experimental Stuff, except on Open Days where members of the
public may visit the facility and ask questions as long as they
consent to a memory wipe when they leave. The memory wipe is
harmless (well, we haven't really tested it properly, but no one's
complained so far) and your memory of the visit will be replaced by
a pleasant recollection of spending the day feeding the ducks in the
nearby pond.

\begin{flushright}
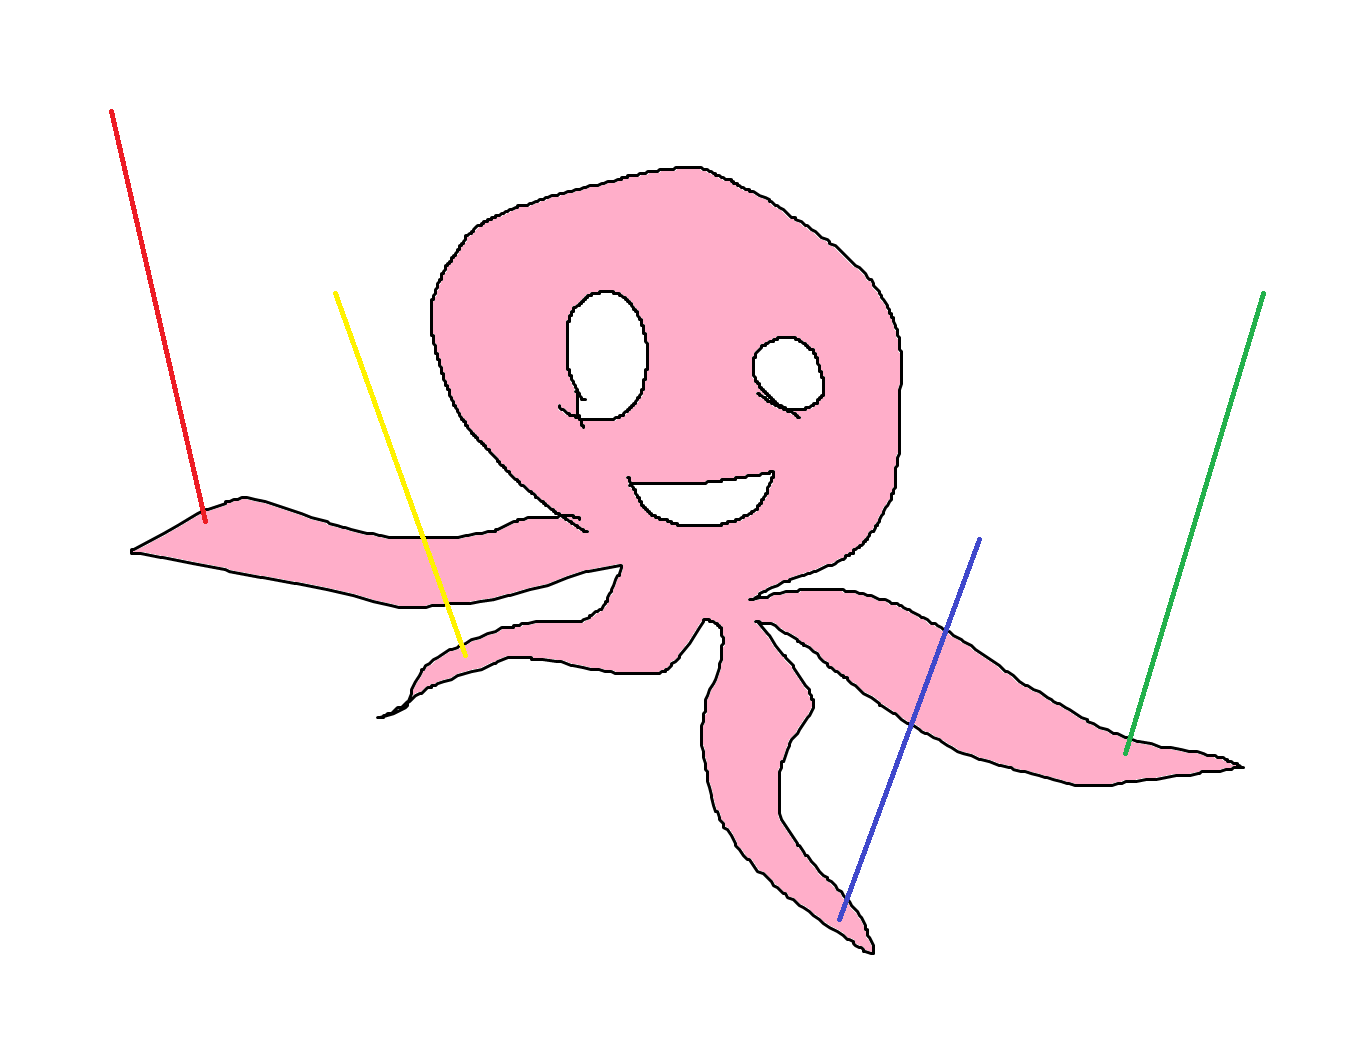
[picture p103: Dokumentation/Logos/gestikulaser.png]

\end{flushright}

\section{Department of Stripy Confectioners}

% lots of text omitted

\newpage
\section{Query Form}

If you'd like to know more about the exciting collaboration between
the Secret Lab of Experimental Stuff and the Department of Stripy
Confectioners please fill in your details below and post this slip to:

\bigskip

\begin{tabular}{@{}l}
Miss Ingperson\\
Secret Lab of Experimental Stuff\\
University of Somewhere\\
Some City\\
AB3 4YZ
\end{tabular} 

%\bigskip

%\Square\␣I would like to receive quarterly newsletters.

%\Square\␣I agree to having my memory wiped.

%\Square\␣Yes, I'd really like to feed the ducks.

%\bigskip

\begin{tabular}{@{}lp{4cm}}
Name: & \dotfill \\
Address: & \dotfill\\
 & \dotfill \\
 & \dotfill \\
 & \dotfill \\
Postcode: & \dotfill\\
Country: & \dotfill\\
Telephone: & \dotfill\\
Mobile: & \dotfill\\
Email: & \dotfill
\end{tabular}

\newpage

\section{Research Team}

\begin{description}
\item[Administrator] Mr Big Head

\item[Assistant Administrator] Dr Bor Ing

\item[Project Co-ordinator] Mabel Canary

\item[Senior Scientists] Dickie Duck, Polly Parrot

\item[Research Assistants] Zöe Zebra, José Arara, Fred Canary

\end{description}

\section{Acknowledgements}

The Culinary Experimental Research team would like to thank the
following:

\begin{description}

\item[University of Somewhere] For something or other

\item[College of Somewhere Else] For providing bread crumbs

\item[The Ministry of Top Secret Stuff] For supporting the 
project somehow.

\end{description}

\end{document}
