gniliac1/COSIMA-Laserstar/Marketing/Präsentation_T-Shirts.pptx

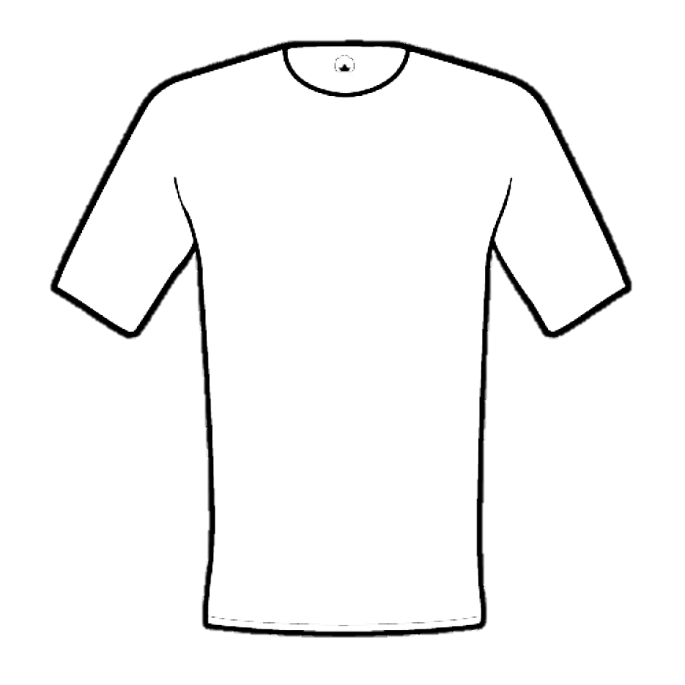
[picture p105: figure]
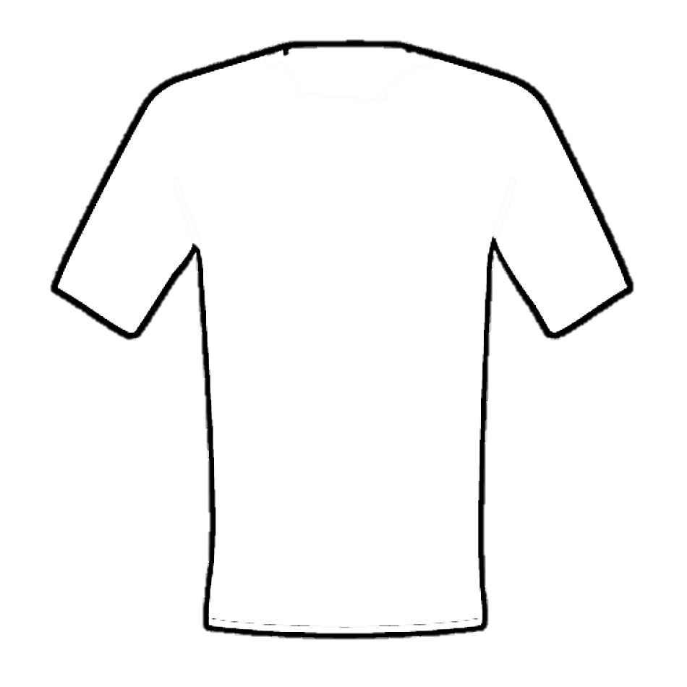
[picture p106: figure]
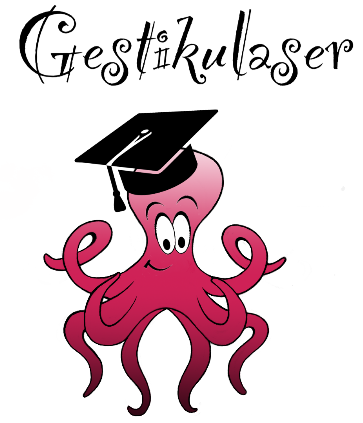
[picture p107: figure]

## Slide 2

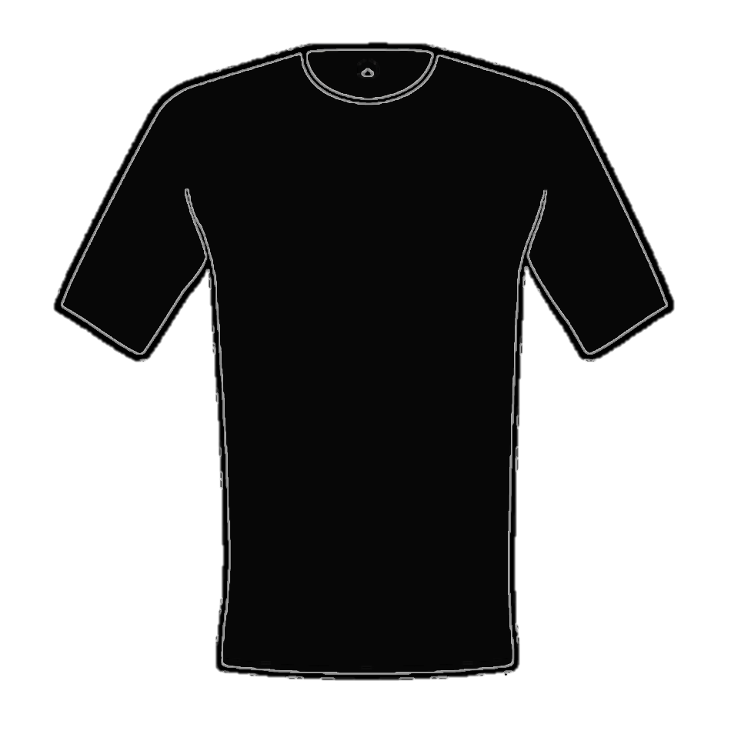
[picture p108: figure]
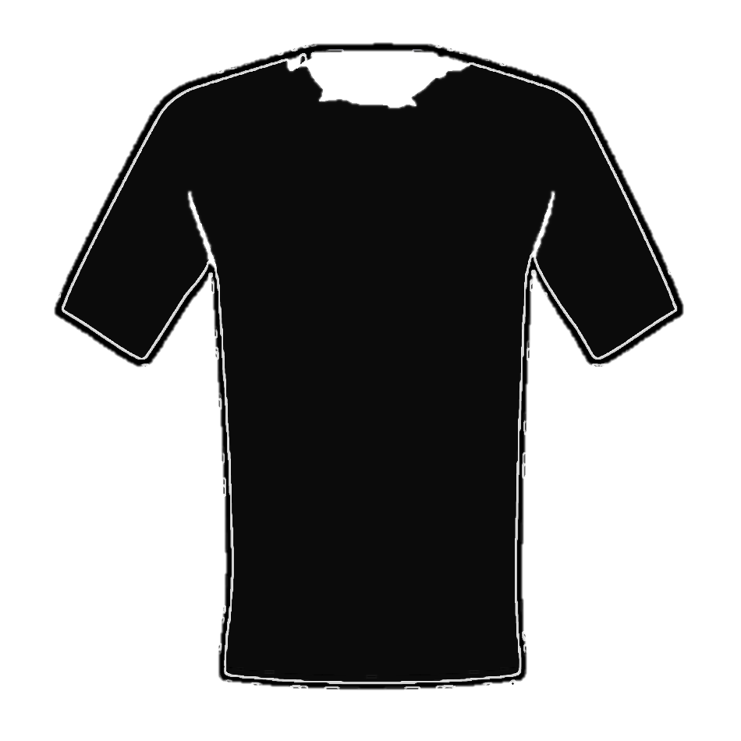
[picture p109: figure]
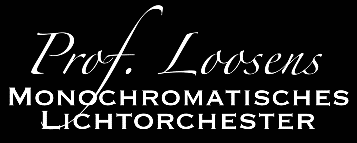
[picture p110: figure]
