gniliac1/COSIMA-Laserstar/Dokumentation/figures/tikz/GestikulaserAblauf.pdf

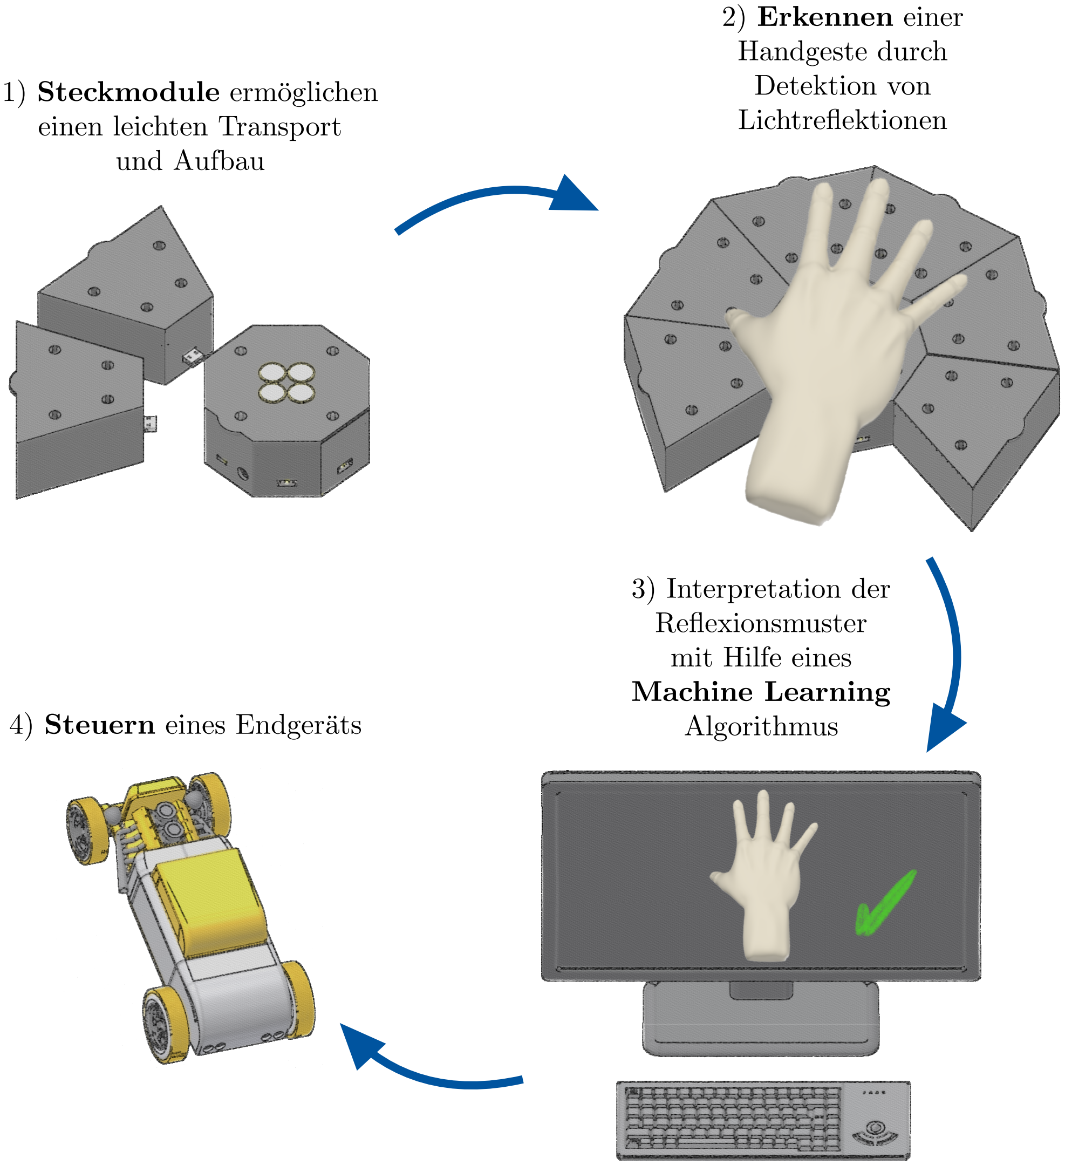
[picture p111: page 1]

1) Steckmodule erm¨oglichen einen leichten Transport
und Aufbau
2) Erkennen einer
Handgeste durch
Detektion von
Lichtreflektionen
3) Interpretation der
Reflexionsmuster
mit Hilfe eines
Machine Learning
4) Steuern eines Endger¨ats | Algorithmus
