gniliac1/COSIMA-Laserstar/report/raw/0_Titelblatt.tex

\newdateformat{mydate}{\monthname[\THEMONTH] \THEYEAR}

\begin{titlepage}

    \AddToShipoutPictureBG*{\AtPageUpperLeft{\makebox[\paperwidth][l]{\raisebox{-\height}{}}}}
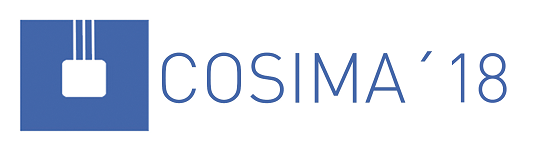
[picture p112: report/figures/COSIMALogo.png]
    \AddToShipoutPictureBG*{\AtPageUpperLeft{\makebox[\paperwidth][r]{\raisebox{-\height}{}}}}
    
    \small
	\parindent0pt
	
	\begin{center}
		\bfseries Projektmappe für den COSIMA-Wettbewerb 2018
	\end{center}
	\vspace*{15mm}
	\normalsize	
	\begin{center}
		\huge
		{\bfseries\sffamily Der Gestikulaser}
		\\ \vspace*{4mm}
		\large
		Die neue Technologie der Gestenerkennung
	\end{center}
	\vfill
	\begin{center}
	\large \mydate{\today}
	\end{center}
	
	\vfill
	\begin{center}
		Verfasst von \\[3ex]
		Christoph Behr \\
		Cailing Fu \\
		Nicole Grubert \\
		Daniel Wolff \\
	\end{center}
\end{titlepage}
