gniliac1/COSIMA-Laserstar/CAD/files/Articulated_Cuttlefish__Ball-joint_articulated_octopus_Remix__/images/9cae091ad994fa08f59c8fc6ae6d0eee_preview_featured.jpg

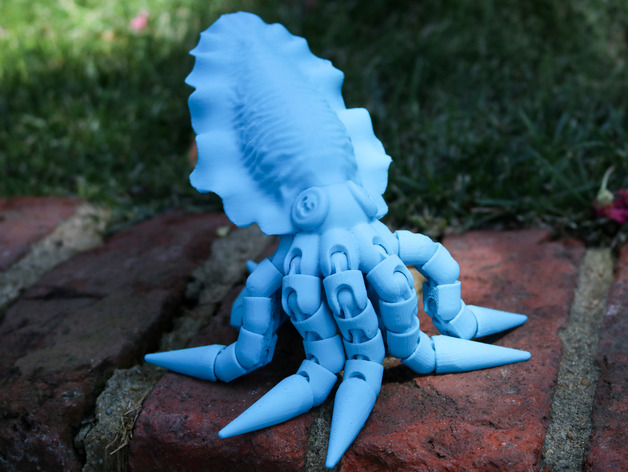
CAD/files/Articulated_Cuttlefish__Ball-joint_articulated_octopus_Remix__/images/9cae091ad994fa08f59c8fc6ae6d0eee_preview_featured.jpg
