gniliac1/COSIMA-Laserstar/CAD/files/Articulated_Cuttlefish__Ball-joint_articulated_octopus_Remix__/images/32c1713a0dfb0d248321aefadb1edbff_preview_featured.jpg

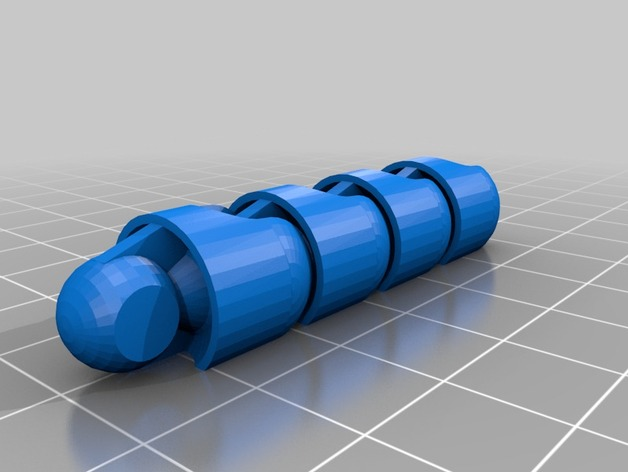
CAD/files/Articulated_Cuttlefish__Ball-joint_articulated_octopus_Remix__/images/32c1713a0dfb0d248321aefadb1edbff_preview_featured.jpg
