gniliac1/COSIMA-Laserstar/CAD/files/Articulated_Cuttlefish__Ball-joint_articulated_octopus_Remix__/images/37e8afa265f9b2cfbe80c81208130b44_preview_featured.jpg

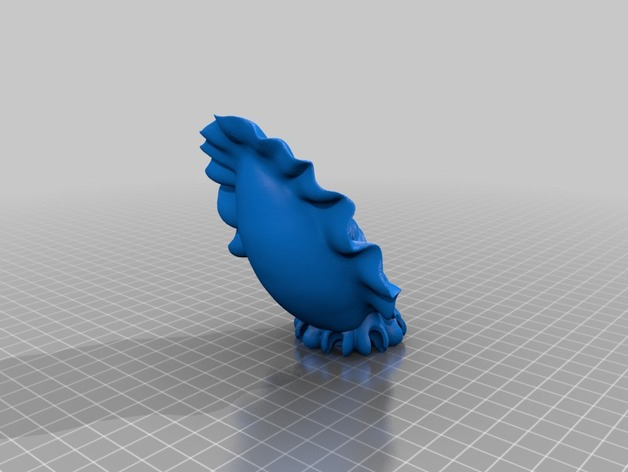
CAD/files/Articulated_Cuttlefish__Ball-joint_articulated_octopus_Remix__/images/37e8afa265f9b2cfbe80c81208130b44_preview_featured.jpg
