gniliac1/COSIMA-Laserstar/CAD/files/Articulated_Cuttlefish__Ball-joint_articulated_octopus_Remix__/images/40a7c6ec997776882b106428377c9dea_preview_featured.jpg

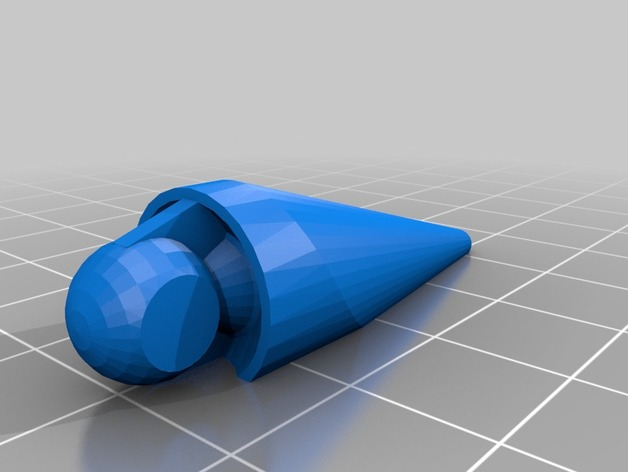
CAD/files/Articulated_Cuttlefish__Ball-joint_articulated_octopus_Remix__/images/40a7c6ec997776882b106428377c9dea_preview_featured.jpg
