gniliac1/COSIMA-Laserstar/CAD/files/Articulated_Cuttlefish__Ball-joint_articulated_octopus_Remix__/images/071a0dae9bd9d81d8e895c5ba6543c84_preview_featured.jpg

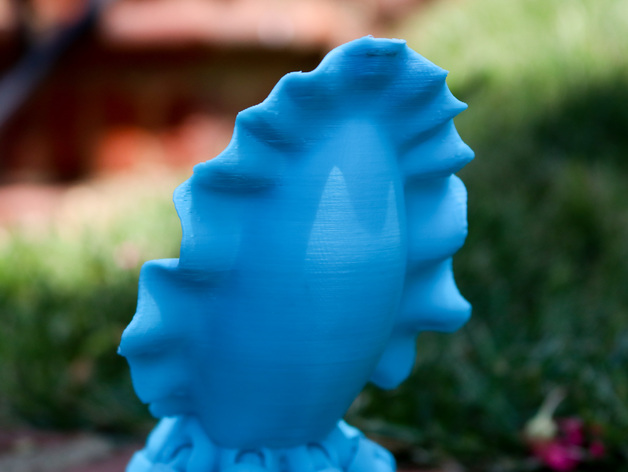
CAD/files/Articulated_Cuttlefish__Ball-joint_articulated_octopus_Remix__/images/071a0dae9bd9d81d8e895c5ba6543c84_preview_featured.jpg
