gniliac1/COSIMA-Laserstar/CAD/files/Articulated_Cuttlefish__Ball-joint_articulated_octopus_Remix__/images/72b15cbbd88de11e3c397a7ea7cc06bd_preview_featured.jpg

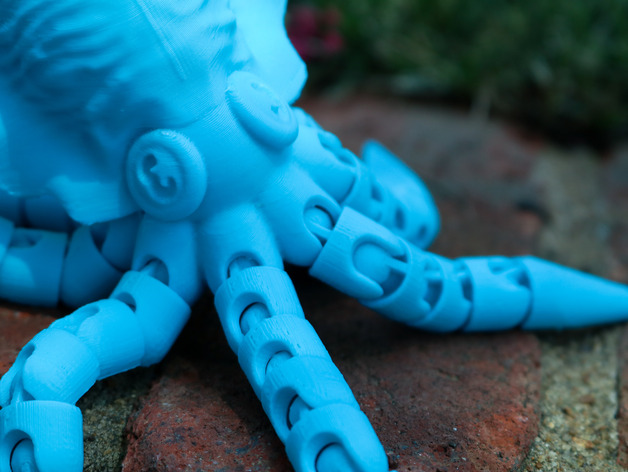
CAD/files/Articulated_Cuttlefish__Ball-joint_articulated_octopus_Remix__/images/72b15cbbd88de11e3c397a7ea7cc06bd_preview_featured.jpg
