gniliac1/COSIMA-Laserstar/CAD/files/Cute_Octo_Graduate/images/ed6ebf36607182eb76853342bf0f1979_preview_featured.jpg

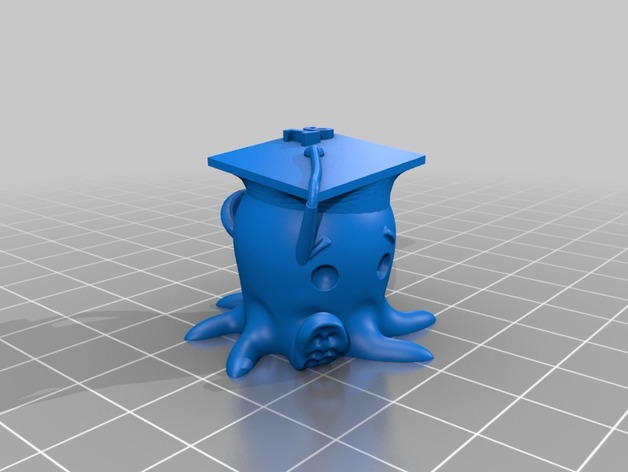
CAD/files/Cute_Octo_Graduate/images/ed6ebf36607182eb76853342bf0f1979_preview_featured.jpg
