gniliac1/COSIMA-Laserstar/CAD/files/Cute_Octo_Graduate/images/Hat_only_preview_featured.jpg

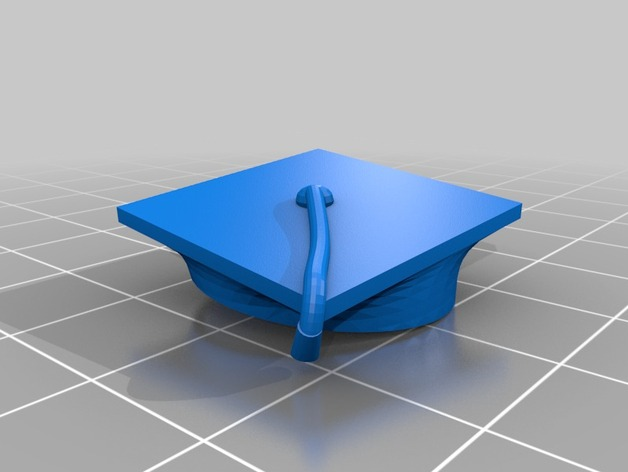
CAD/files/Cute_Octo_Graduate/images/Hat_only_preview_featured.jpg
