gniliac1/COSIMA-Laserstar/CAD/files/Cute_Octo_Graduate/images/octopi_preview_featured.jpg

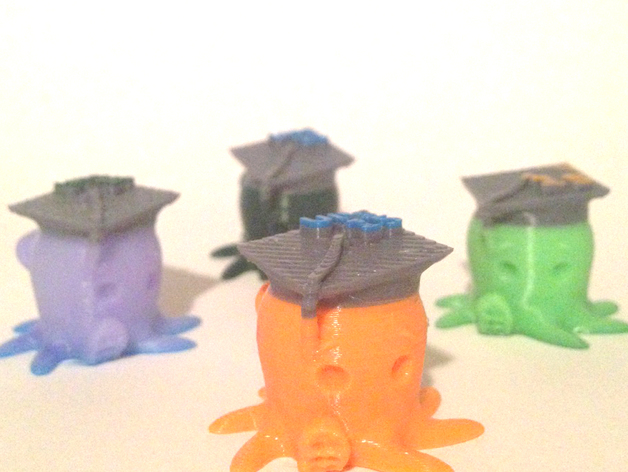
CAD/files/Cute_Octo_Graduate/images/octopi_preview_featured.jpg
