gniliac1/COSIMA-Laserstar/CAD/files/Cute_Octo_Graduate/images/untitled.82_preview_featured.jpg

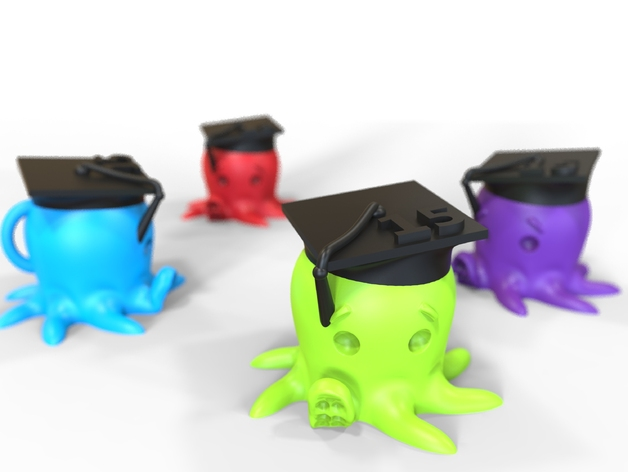
CAD/files/Cute_Octo_Graduate/images/untitled.82_preview_featured.jpg
