gniliac1/COSIMA-Laserstar/CAD/nicht CAD Nicole/autoHinten.jpg

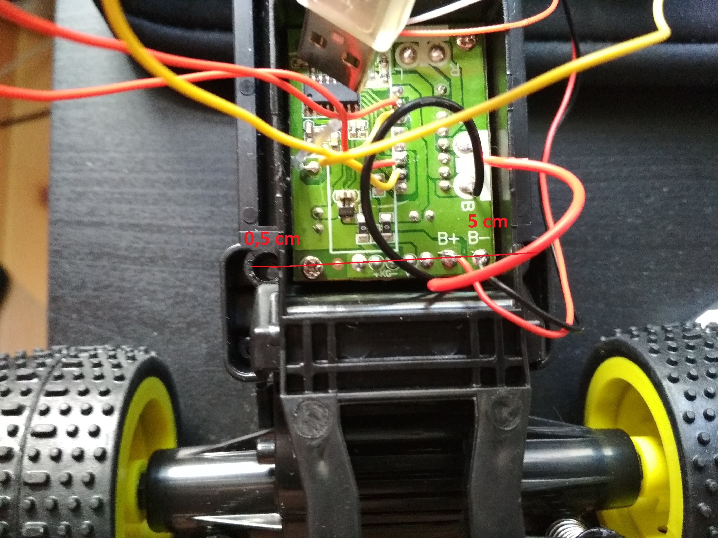
CAD/nicht CAD Nicole/autoHinten.jpg
