gniliac1/COSIMA-Laserstar/CAD/nicht CAD Nicole/autoVorne.jpg

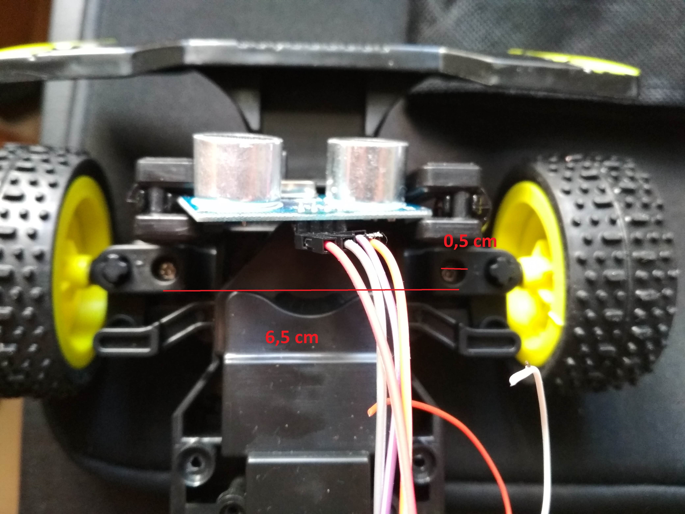
CAD/nicht CAD Nicole/autoVorne.jpg
