gniliac1/COSIMA-Laserstar/CAD/usb-connector-5.snapshot.13/USB_surinkimas_2018-Jul-16_08-24-56PM-000_CustomizedView43704415657_png.png

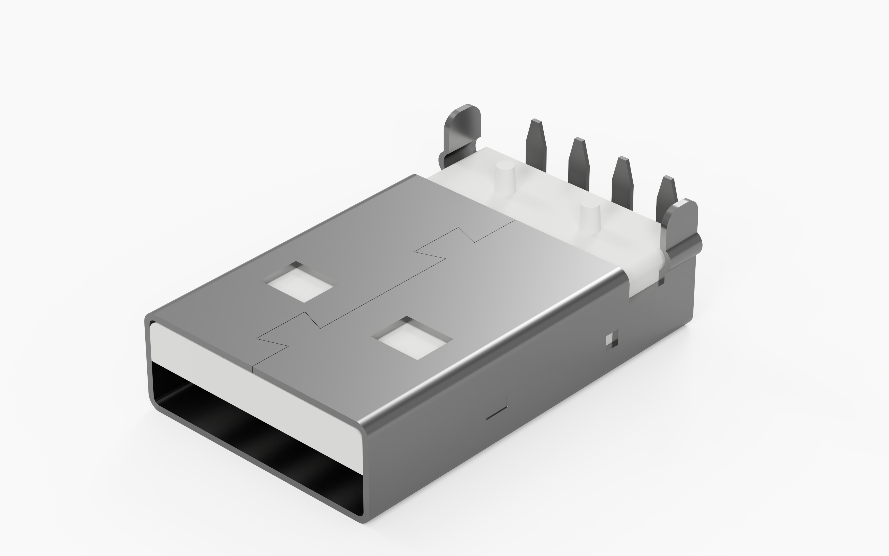
CAD/usb-connector-5.snapshot.13/USB_surinkimas_2018-Jul-16_08-24-56PM-000_CustomizedView43704415657_png.png
