gniliac1/COSIMA-Laserstar/CAD/usb-connector-5.snapshot.13/USB_surinkimas_2018-Jul-16_08-26-06PM-000_CustomizedView25904665240_png.png

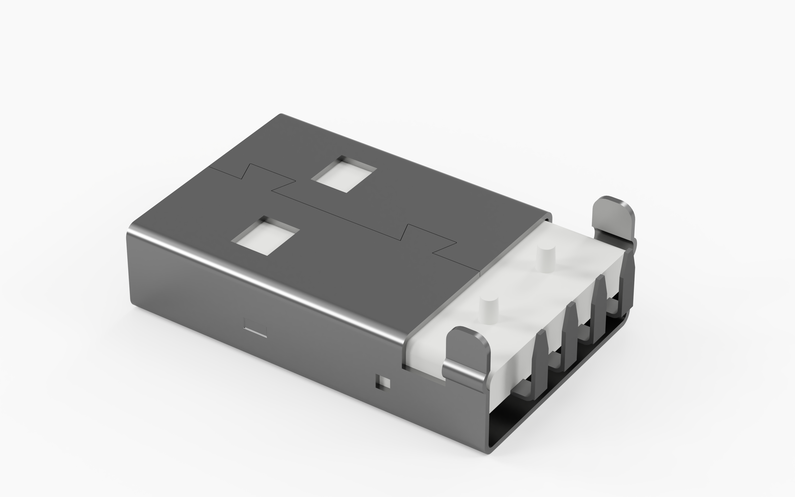
CAD/usb-connector-5.snapshot.13/USB_surinkimas_2018-Jul-16_08-26-06PM-000_CustomizedView25904665240_png.png
