gniliac1/COSIMA-Laserstar/CAD/usb-connector-5.snapshot.13/USB_surinkimas_2018-Jul-16_08-27-26PM-000_CustomizedView5662056332_png.png

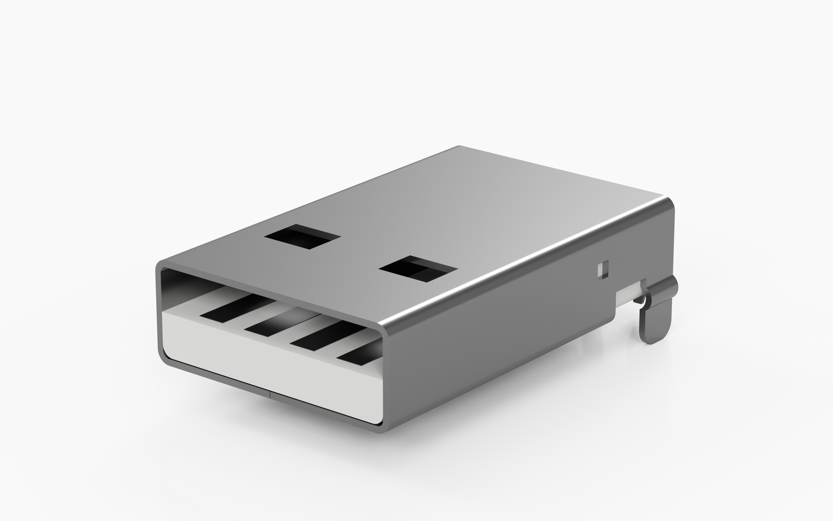
CAD/usb-connector-5.snapshot.13/USB_surinkimas_2018-Jul-16_08-27-26PM-000_CustomizedView5662056332_png.png
