gniliac1/COSIMA-Laserstar/CAD/usb-connector-5.snapshot.13/USB_surinkimas_2018-Jul-16_08-28-13PM-000_CustomizedView39029749971_png.png

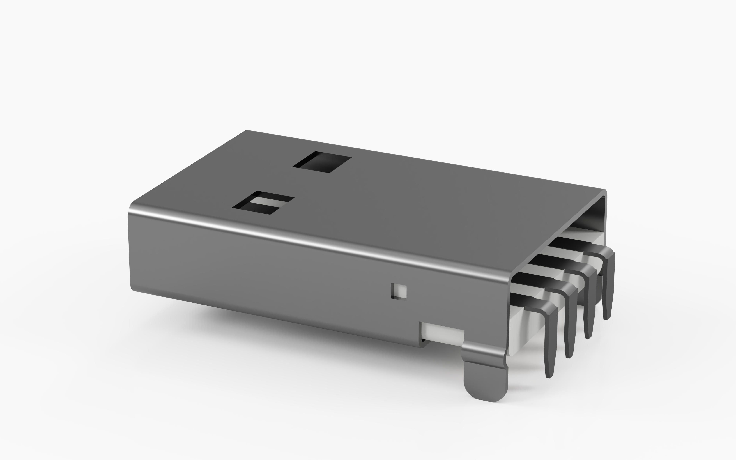
CAD/usb-connector-5.snapshot.13/USB_surinkimas_2018-Jul-16_08-28-13PM-000_CustomizedView39029749971_png.png
