gniliac1/COSIMA-Laserstar/Dokumentation/CAD_Bilder/ARDUINO MICRO.png

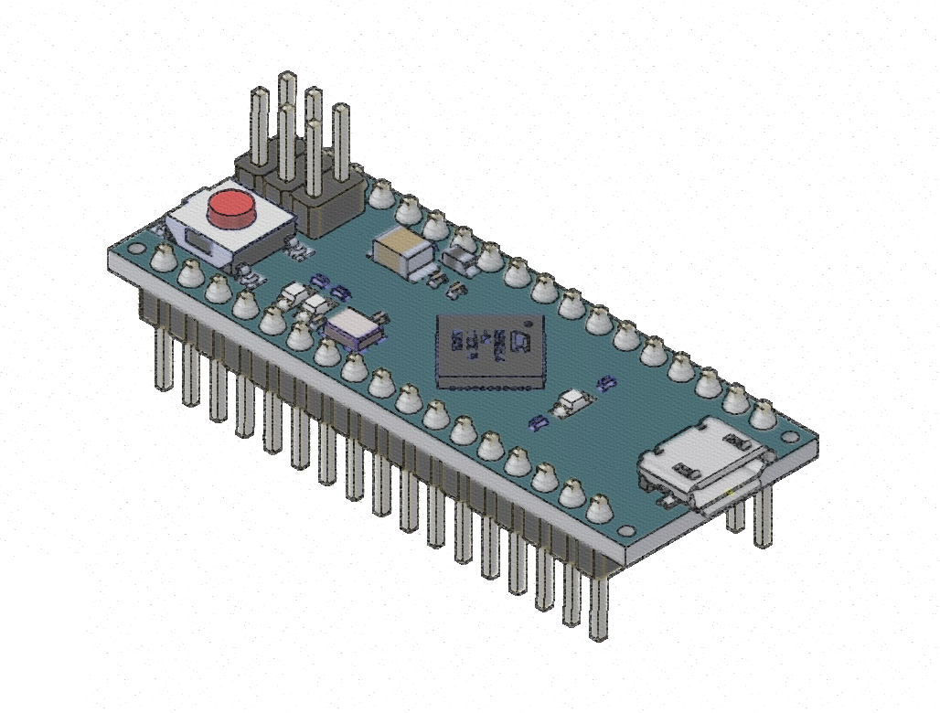
Dokumentation/CAD_Bilder/ARDUINO MICRO.png
