gniliac1/COSIMA-Laserstar/Dokumentation/CAD_Bilder/Detektormodul/Detektormodul_raytraced2.png

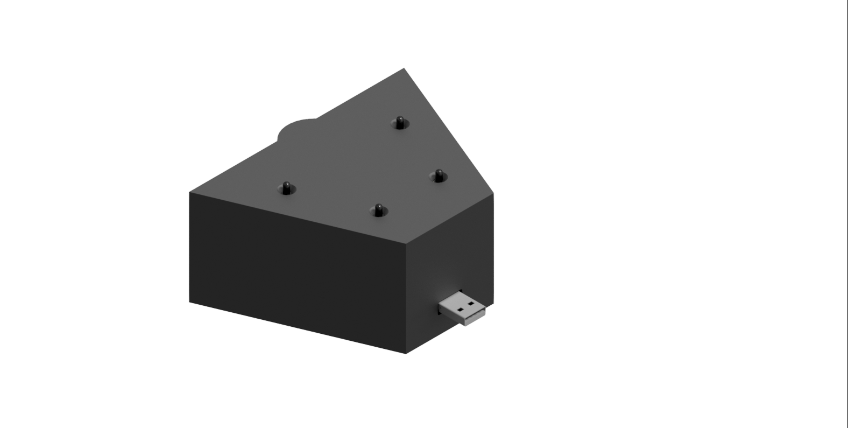
Dokumentation/CAD_Bilder/Detektormodul/Detektormodul_raytraced2.png
