gniliac1/COSIMA-Laserstar/Dokumentation/CAD_Bilder/Detektormodul/Detektormodul_raytraced.png

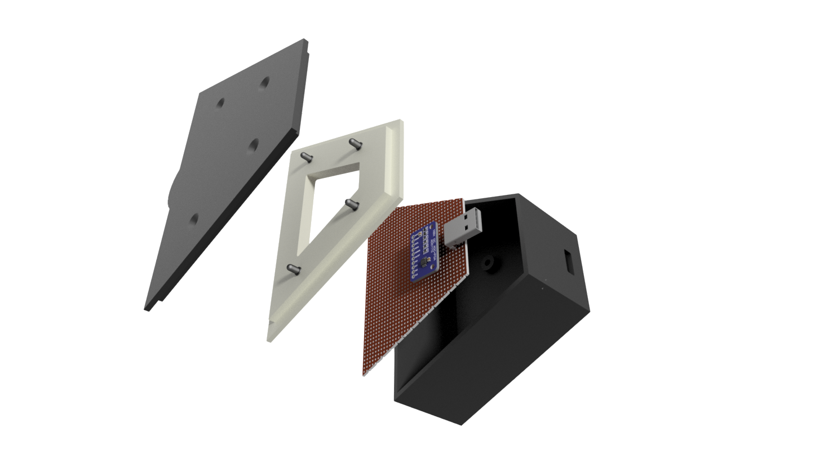
Dokumentation/CAD_Bilder/Detektormodul/Detektormodul_raytraced.png
