gniliac1/COSIMA-Laserstar/Dokumentation/CAD_Bilder/Detektormodul/Detektormodul_raytraced_oben.png

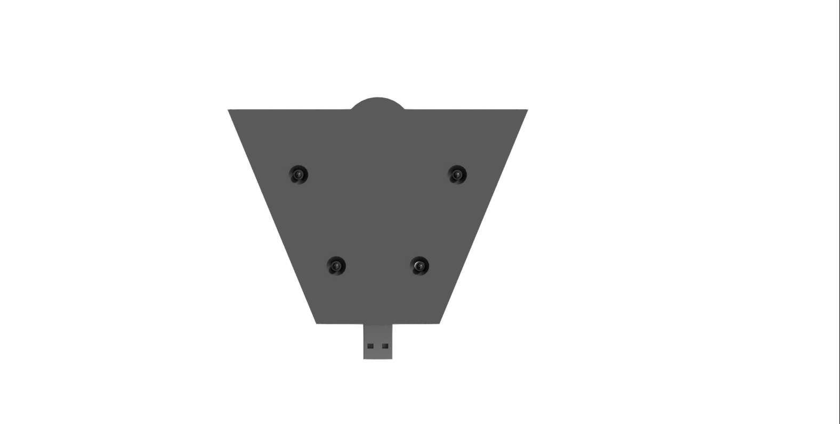
Dokumentation/CAD_Bilder/Detektormodul/Detektormodul_raytraced_oben.png
