gniliac1/COSIMA-Laserstar/Dokumentation/CAD_Bilder/Detektormodul/IMG_1350.PNG

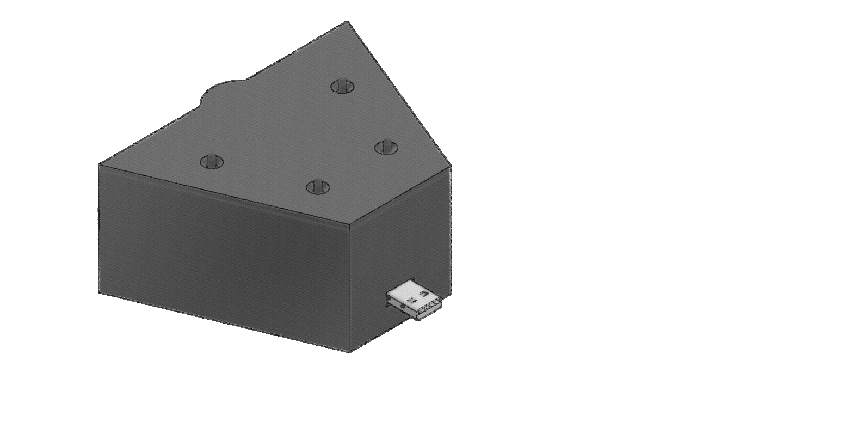
Dokumentation/CAD_Bilder/Detektormodul/IMG_1350.PNG
