gniliac1/COSIMA-Laserstar/Dokumentation/CAD_Bilder/Flyer_Bilder/original/IMG_1342.PNG

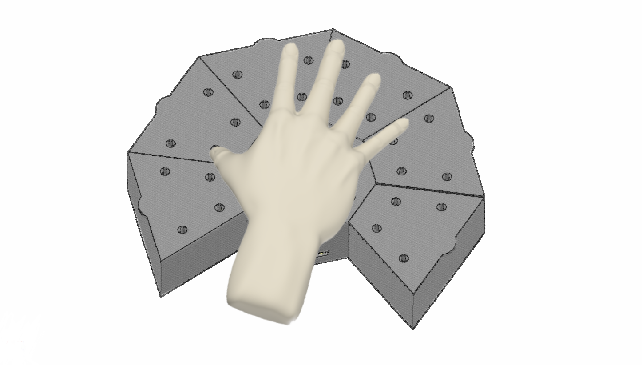
Dokumentation/CAD_Bilder/Flyer_Bilder/original/IMG_1342.PNG
