gniliac1/COSIMA-Laserstar/Dokumentation/CAD_Bilder/Flyer_Bilder/PC-Leer.PNG

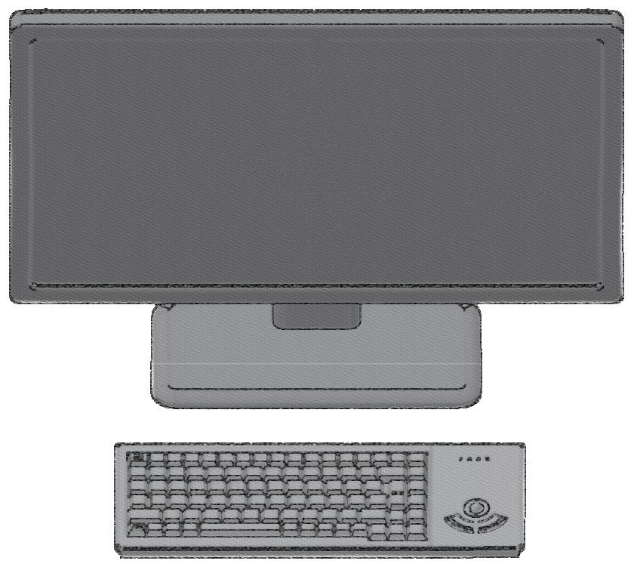
Dokumentation/CAD_Bilder/Flyer_Bilder/PC-Leer.PNG
