gniliac1/COSIMA-Laserstar/Dokumentation/CAD_Bilder/Gestikulaser/Gestikulaser_raytraced_2_beschriftet.png

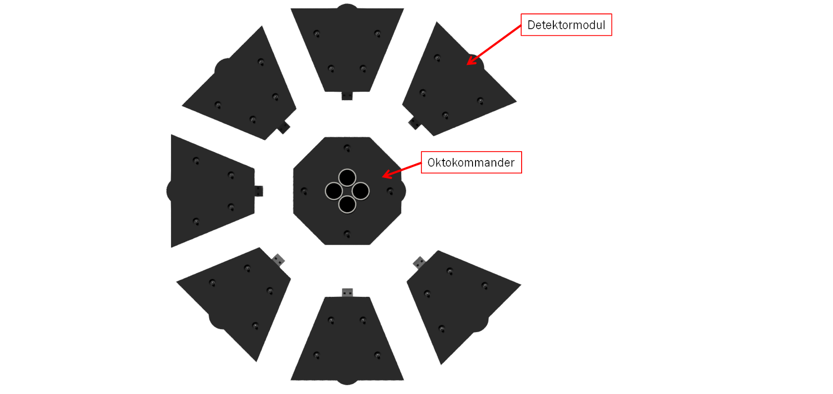
Dokumentation/CAD_Bilder/Gestikulaser/Gestikulaser_raytraced_2_beschriftet.png
