gniliac1/COSIMA-Laserstar/Dokumentation/CAD_Bilder/Gestikulaser/Gestikulaser_raytraced_3.png

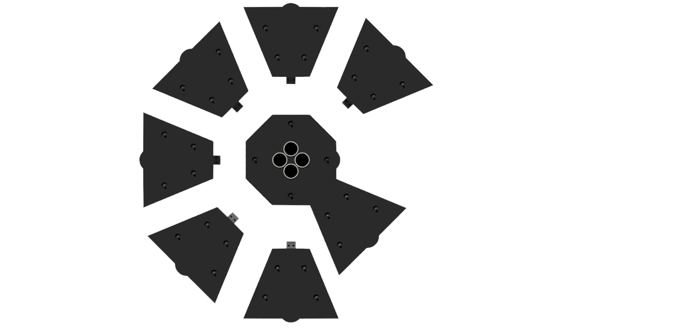
Dokumentation/CAD_Bilder/Gestikulaser/Gestikulaser_raytraced_3.png
