gniliac1/COSIMA-Laserstar/Dokumentation/CAD_Bilder/Gestikulaser/Gestikulaser_raytraced_5.png

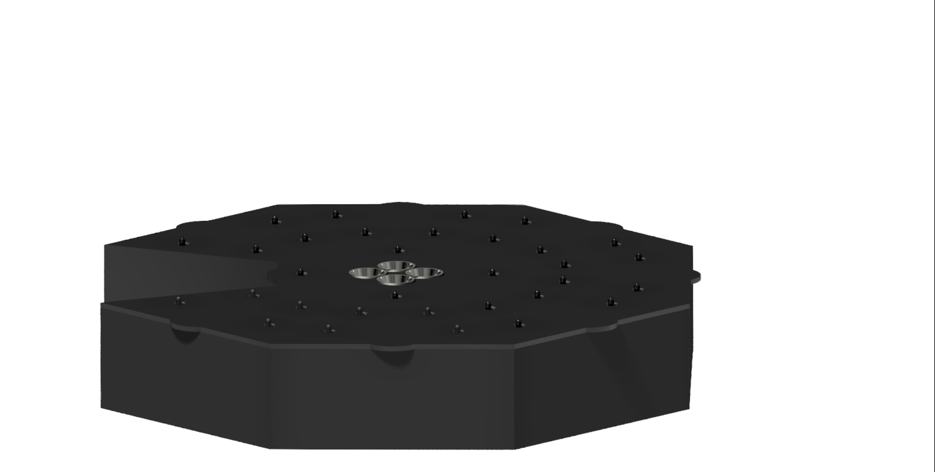
Dokumentation/CAD_Bilder/Gestikulaser/Gestikulaser_raytraced_5.png
