gniliac1/COSIMA-Laserstar/Dokumentation/CAD_Bilder/Gestikulaser/IMG_1355.PNG

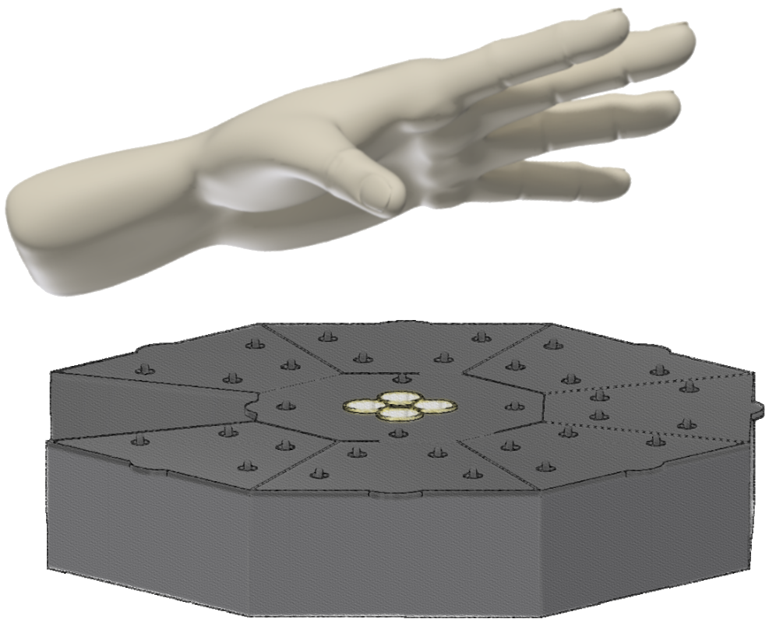
Dokumentation/CAD_Bilder/Gestikulaser/IMG_1355.PNG
