gniliac1/COSIMA-Laserstar/Dokumentation/CAD_Bilder/Hände_Handschuhe/hand3.png

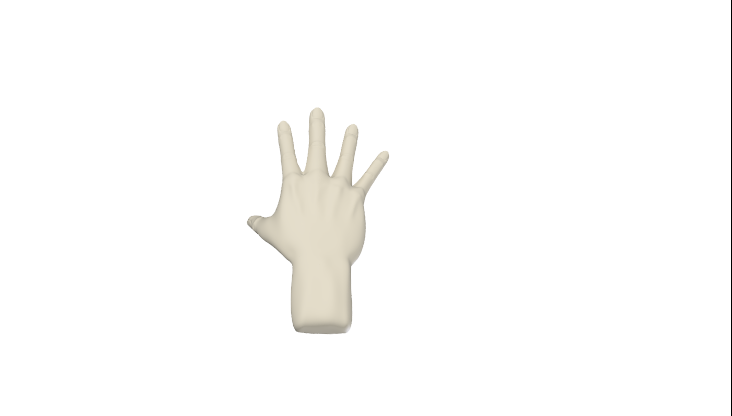
Dokumentation/CAD_Bilder/Hände_Handschuhe/hand3.png
