gniliac1/COSIMA-Laserstar/Dokumentation/CAD_Bilder/Hände_Handschuhe/hand4.png

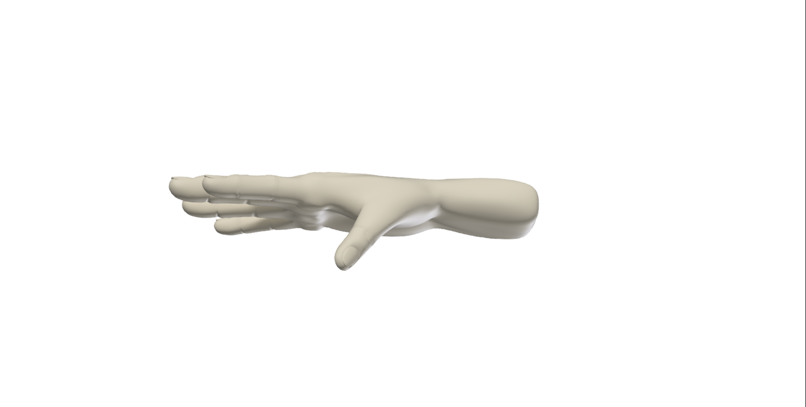
Dokumentation/CAD_Bilder/Hände_Handschuhe/hand4.png
