gniliac1/COSIMA-Laserstar/Dokumentation/CAD_Bilder/Hände_Handschuhe/Sensorhandschuh 1.png

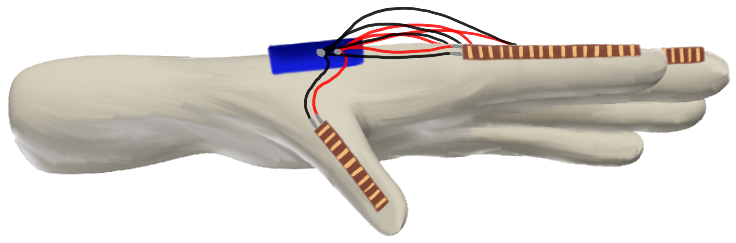
Dokumentation/CAD_Bilder/Hände_Handschuhe/Sensorhandschuh 1.png
