gniliac1/COSIMA-Laserstar/Dokumentation/CAD_Bilder/Oktokommander/IMG_1349.PNG

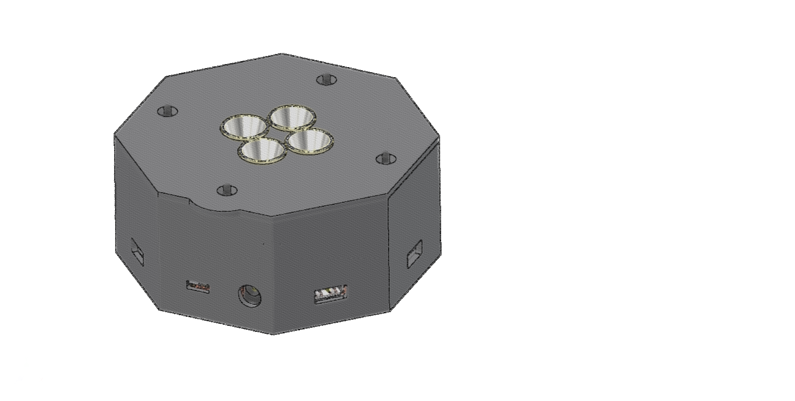
Dokumentation/CAD_Bilder/Oktokommander/IMG_1349.PNG
