gniliac1/COSIMA-Laserstar/Dokumentation/CAD_Bilder/Oktokommander/IMG_1354.PNG

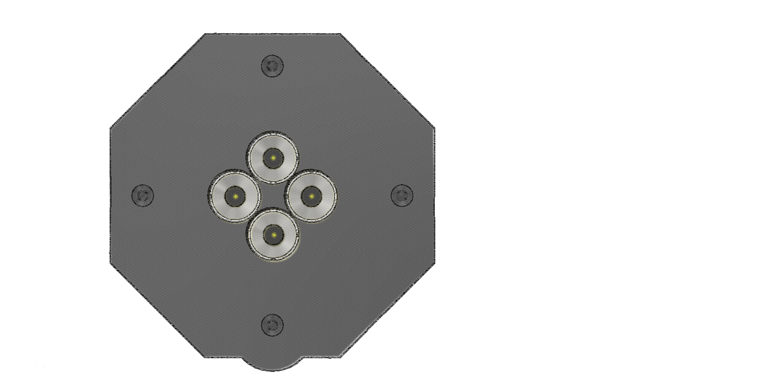
Dokumentation/CAD_Bilder/Oktokommander/IMG_1354.PNG
