gniliac1/COSIMA-Laserstar/Dokumentation/CAD_Bilder/Oktokommander/Oktagon raytraced.png

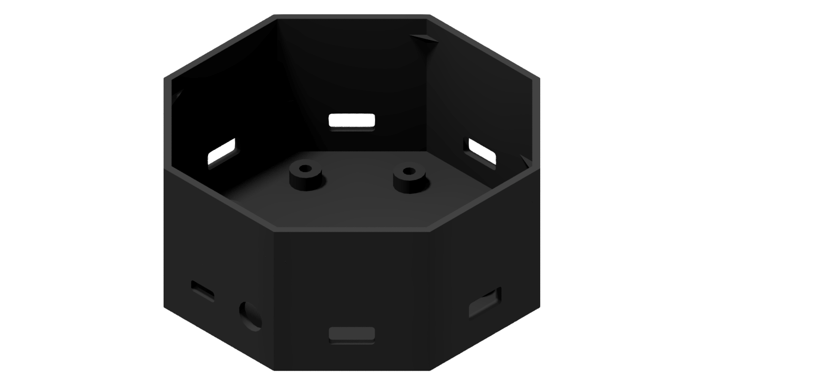
Dokumentation/CAD_Bilder/Oktokommander/Oktagon raytraced.png
