gniliac1/COSIMA-Laserstar/Dokumentation/CAD_Bilder/Oktokommander/Oktagon_Deckel raytraced.png

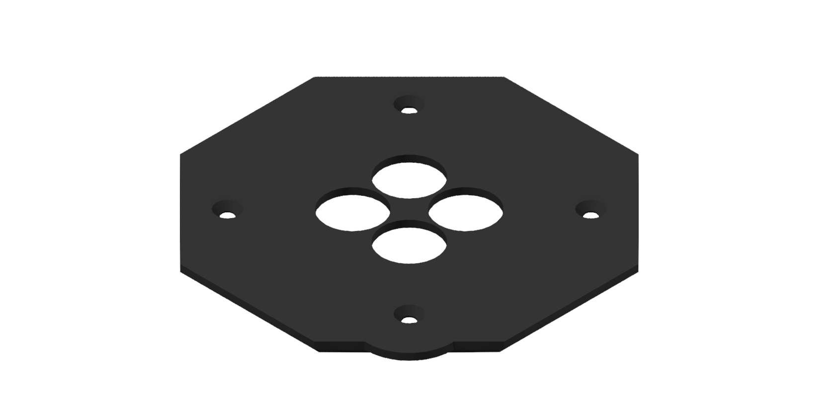
Dokumentation/CAD_Bilder/Oktokommander/Oktagon_Deckel raytraced.png
