gniliac1/COSIMA-Laserstar/Dokumentation/CAD_Bilder/Oktokommander/Oktokommander_raytraced2.png

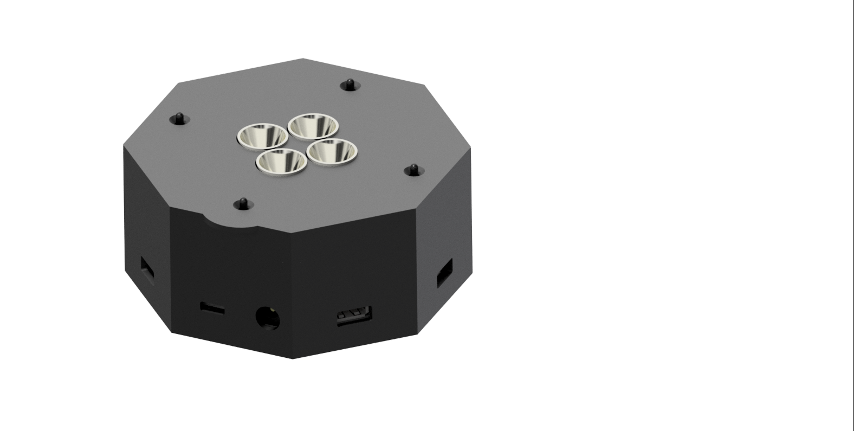
Dokumentation/CAD_Bilder/Oktokommander/Oktokommander_raytraced2.png
