gniliac1/COSIMA-Laserstar/Dokumentation/figures/AblaufGestikulaser3.JPG

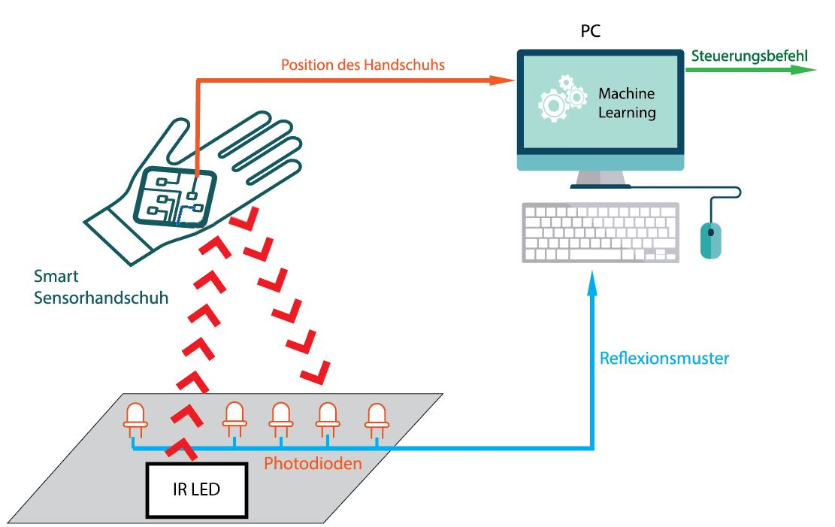
Dokumentation/figures/AblaufGestikulaser3.JPG
