gniliac1/COSIMA-Laserstar/Dokumentation/figures/AblaufGestikulaser.png

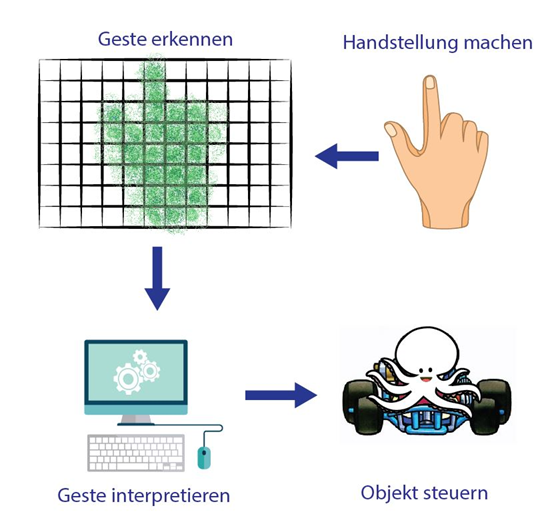
Dokumentation/figures/AblaufGestikulaser.png
