gniliac1/COSIMA-Laserstar/Dokumentation/figures/Cave.png

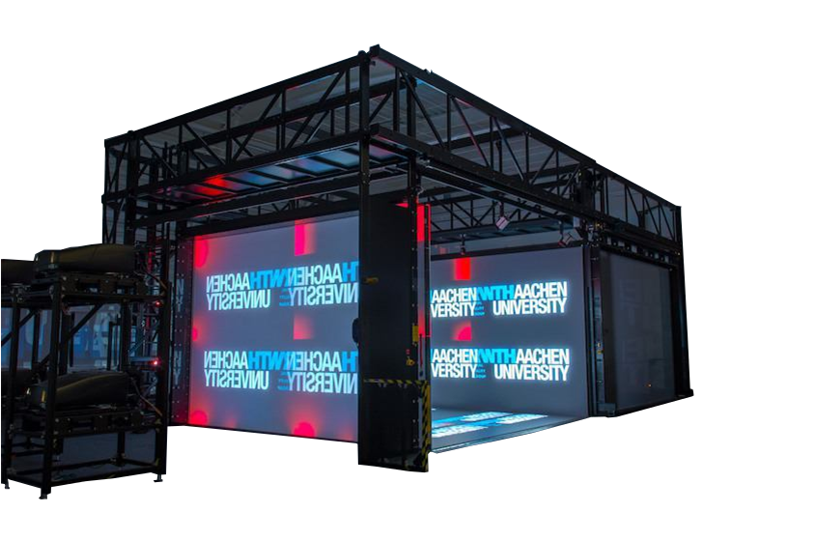
Dokumentation/figures/Cave.png
