gniliac1/COSIMA-Laserstar/Dokumentation/figures/dji-mavic-air-onyx-noir.jpg

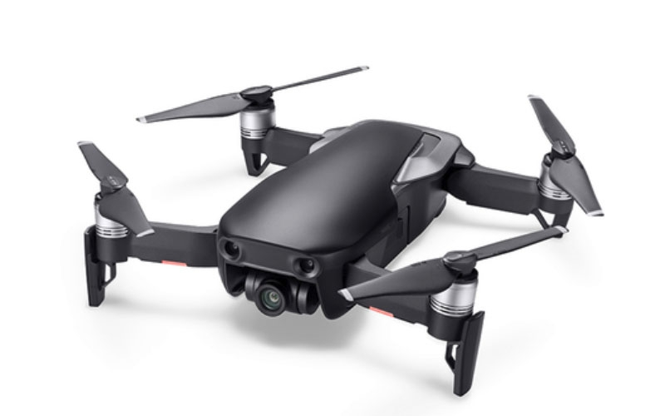
Dokumentation/figures/dji-mavic-air-onyx-noir.jpg
