gniliac1/COSIMA-Laserstar/Dokumentation/figures/Einzelspielerharfe.jpg

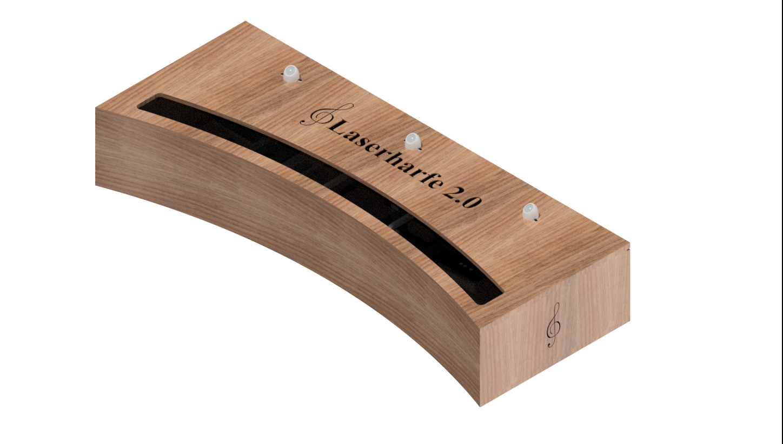
Dokumentation/figures/Einzelspielerharfe.jpg
