gniliac1/COSIMA-Laserstar/Dokumentation/figures/IR Photodioden.jpg

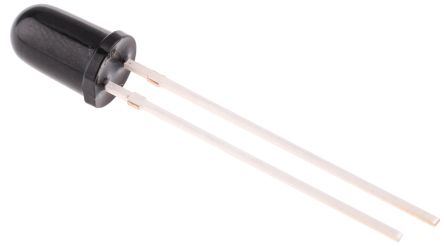
Dokumentation/figures/IR Photodioden.jpg
