gniliac1/COSIMA-Laserstar/Dokumentation/figures/oktokommanderKP.png

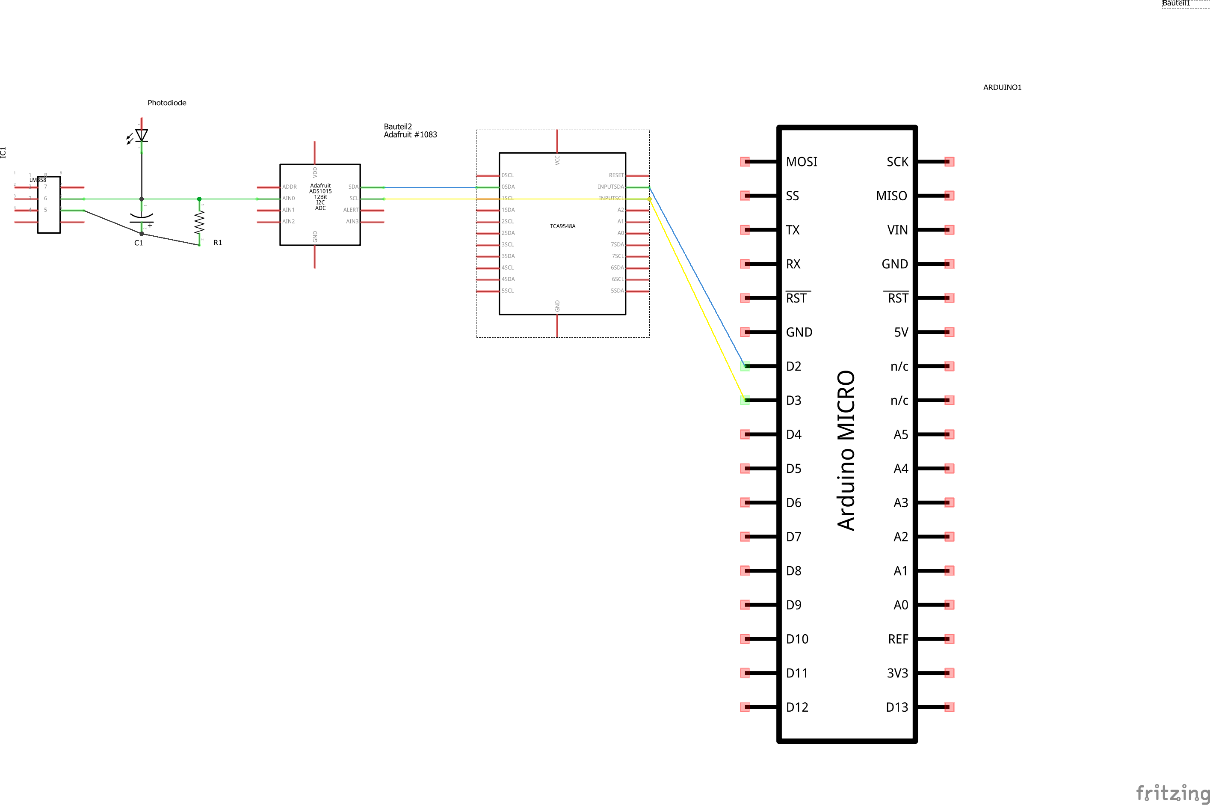
Dokumentation/figures/oktokommanderKP.png
