gniliac1/COSIMA-Laserstar/Dokumentation/figures/Smart-Home-Info-Perumahan-Murah.jpg

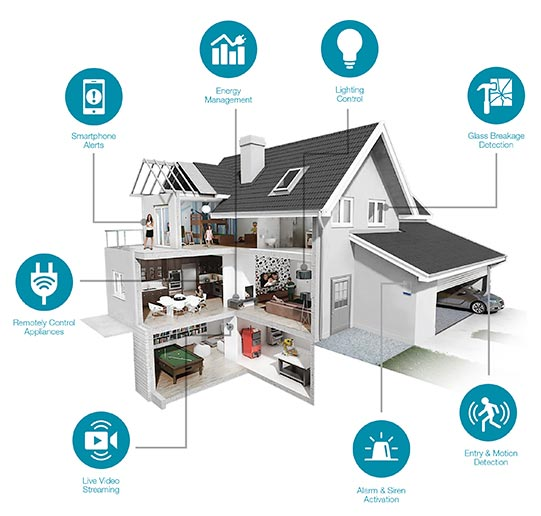
Dokumentation/figures/Smart-Home-Info-Perumahan-Murah.jpg
