gniliac1/COSIMA-Laserstar/Instagram/IMG_20180812_110759.jpg

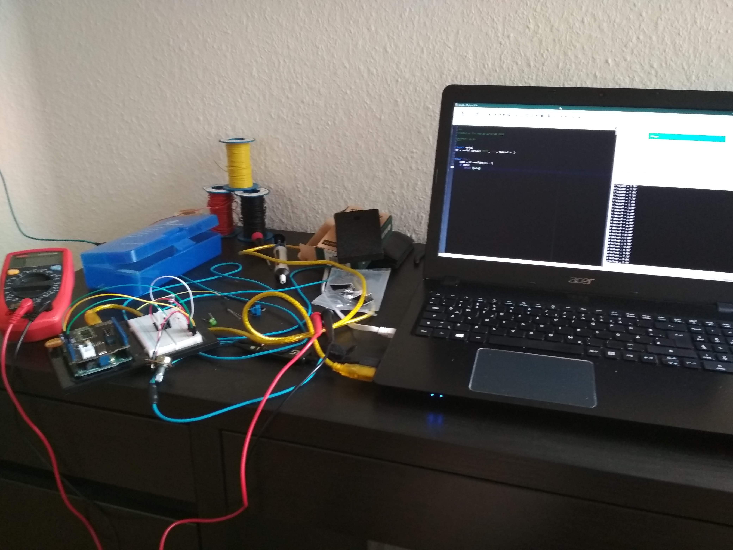
Instagram/IMG_20180812_110759.jpg
