gniliac1/COSIMA-Laserstar/Instagram/Photo View.png

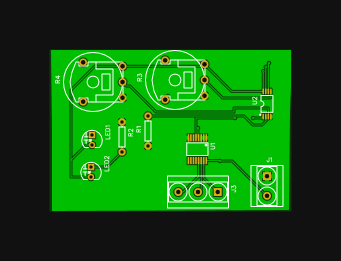
Instagram/Photo View.png
