gniliac1/COSIMA-Laserstar/Instagram/Schematic_I2C-I-O-Expander_Sheet-1_20180726115025.png

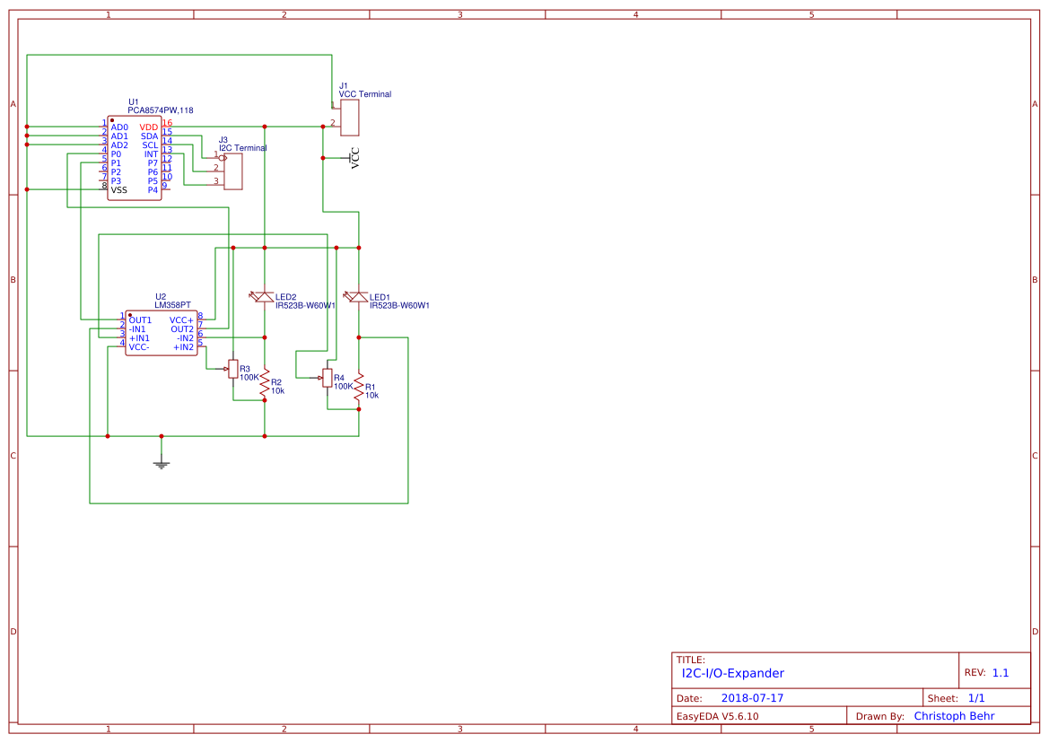
Instagram/Schematic_I2C-I-O-Expander_Sheet-1_20180726115025.png
