gniliac1/COSIMA-Laserstar/Marketing/Bilder/36971431_1932406323445230_1753070947167895552_n.jpg

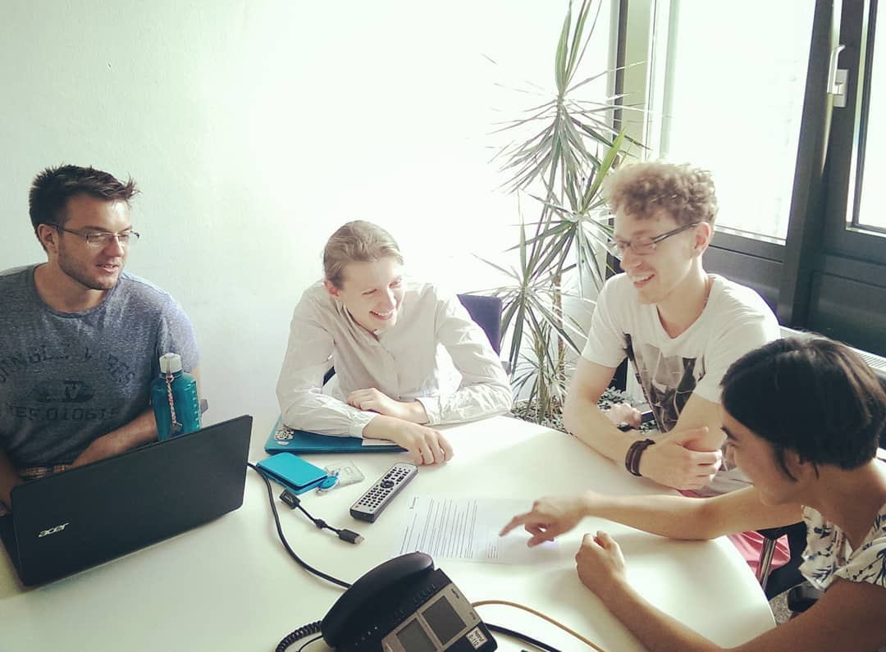
Marketing/Bilder/36971431_1932406323445230_1753070947167895552_n.jpg
