gniliac1/COSIMA-Laserstar/Marketing/Bilder/Ablauf_Geste-Oktopus.png

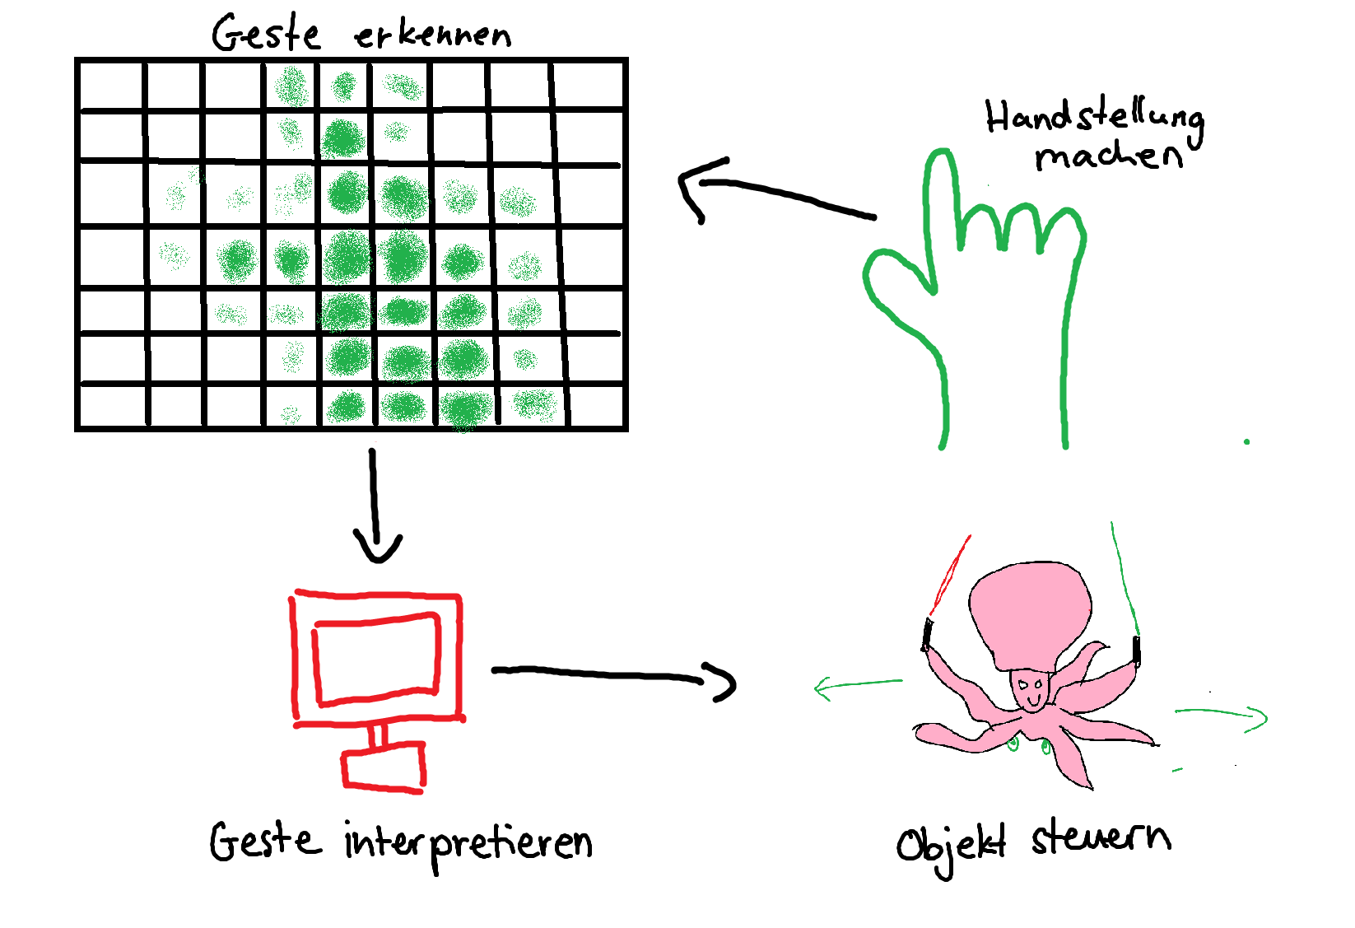
Marketing/Bilder/Ablauf_Geste-Oktopus.png
