gniliac1/COSIMA-Laserstar/Marketing/Bilder/Bild1.jpg

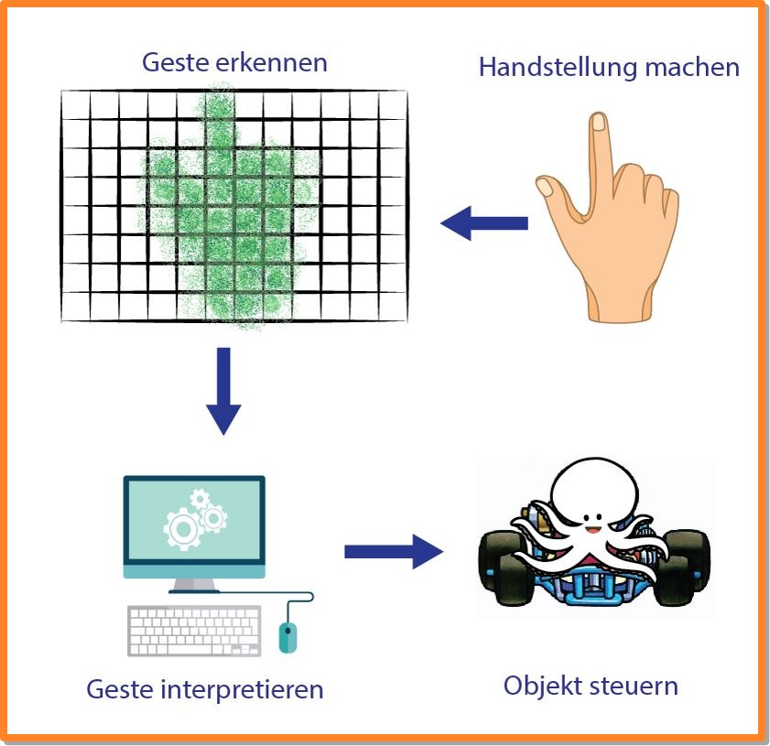
Marketing/Bilder/Bild1.jpg
