gniliac1/COSIMA-Laserstar/Marketing/Bilder/Gestikulaser_fern.png

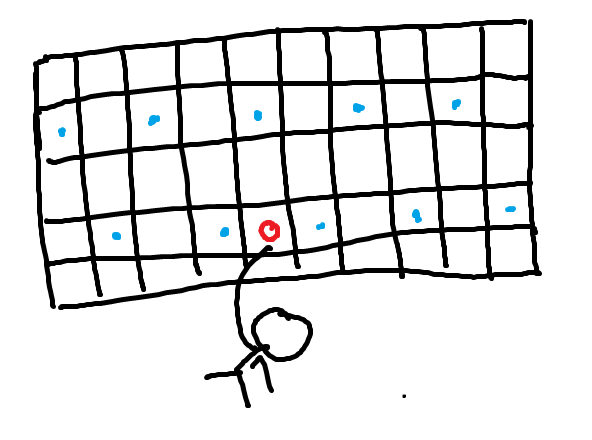
Marketing/Bilder/Gestikulaser_fern.png
