gniliac1/COSIMA-Laserstar/Marketing/Bilder/Gestikulaser_nah.png

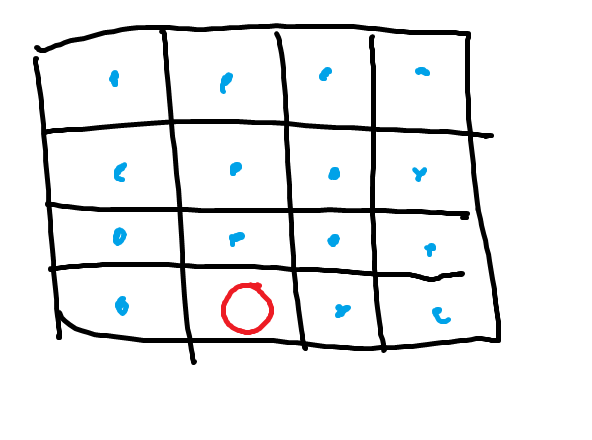
Marketing/Bilder/Gestikulaser_nah.png
