gniliac1/COSIMA-Laserstar/Marketing/Bilder/hugoDasSelbstFahrendeAuto.jpg

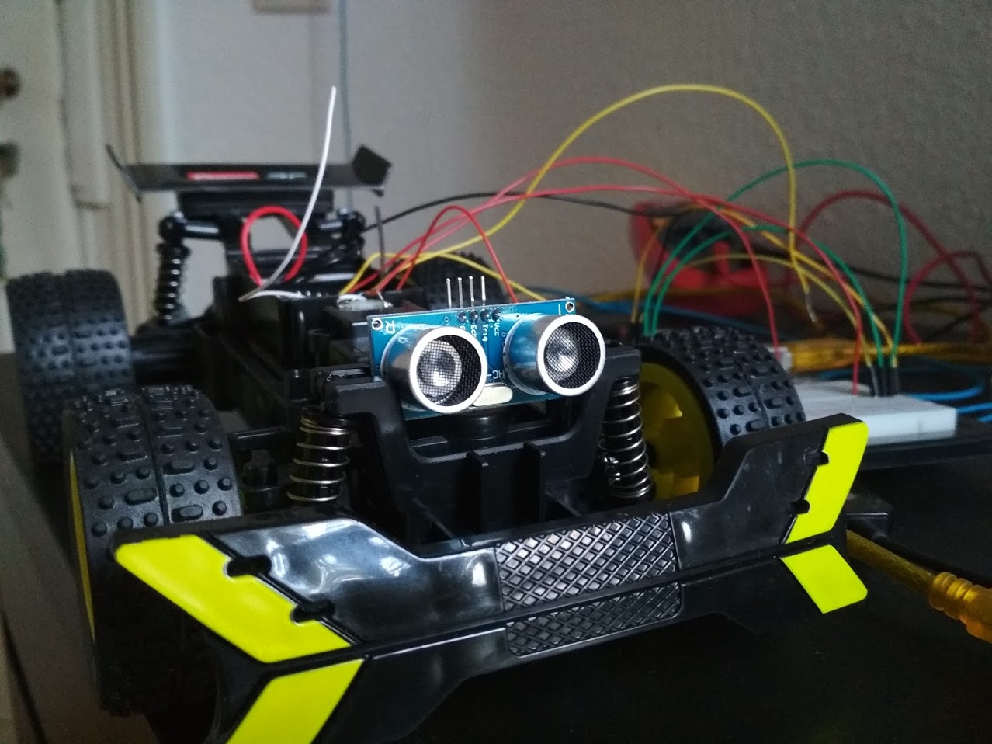
Marketing/Bilder/hugoDasSelbstFahrendeAuto.jpg
