gniliac1/COSIMA-Laserstar/Marketing/Bilder/Im sitzen.JPG

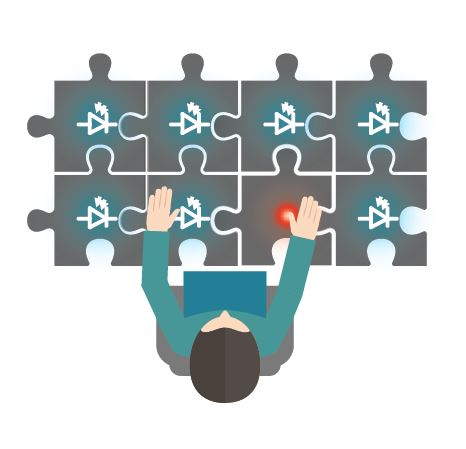
Marketing/Bilder/Im sitzen.JPG
