gniliac1/COSIMA-Laserstar/Marketing/Bilder/Im stehen.JPG

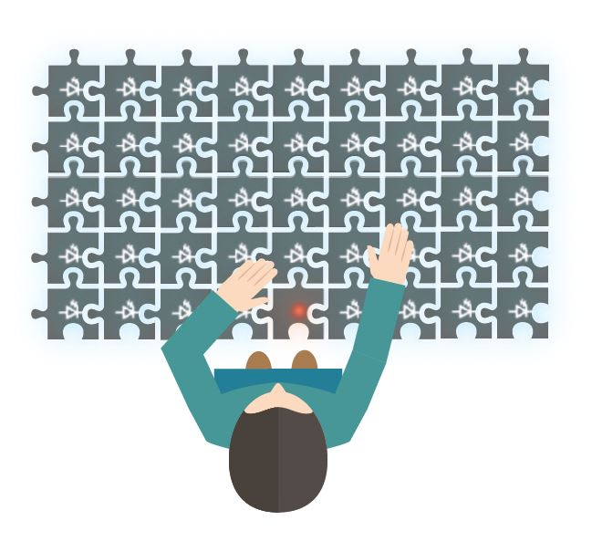
Marketing/Bilder/Im stehen.JPG
