gniliac1/COSIMA-Laserstar/Marketing/Bilder/Laser Aufweiten.JPG

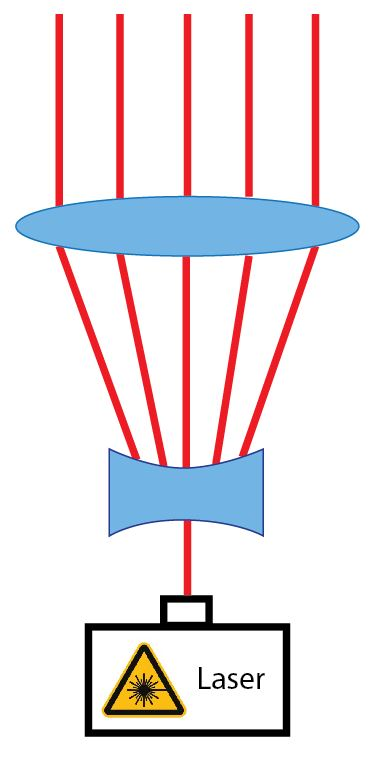
Marketing/Bilder/Laser Aufweiten.JPG
