gniliac1/COSIMA-Laserstar/Marketing/Bilder/Laser+Photodiode Platten.png

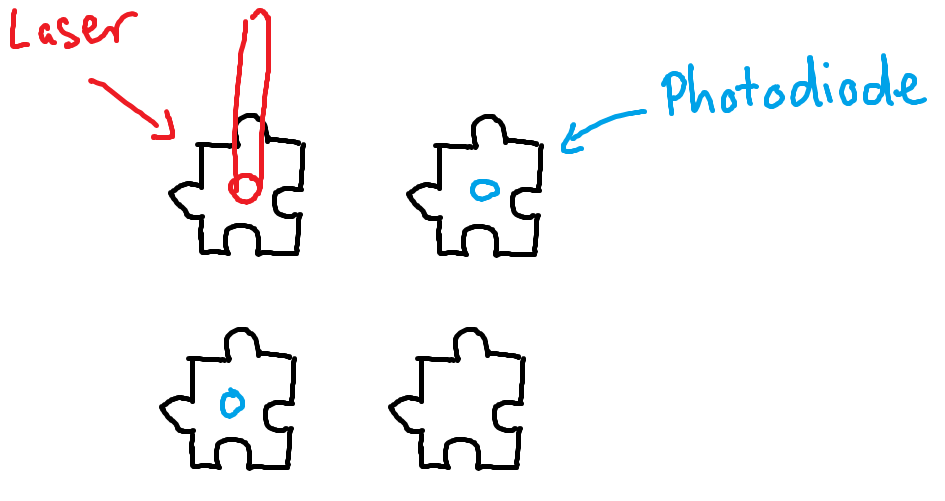
Marketing/Bilder/Laser+Photodiode Platten.png
