gniliac1/COSIMA-Laserstar/Marketing/Bilder/Laseraufweitung.png

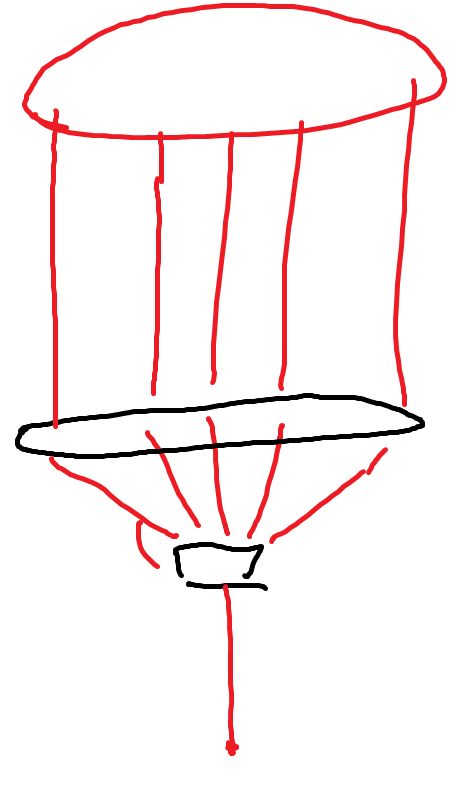
Marketing/Bilder/Laseraufweitung.png
