gniliac1/COSIMA-Laserstar/Marketing/Bilder/Laserharp.JPG

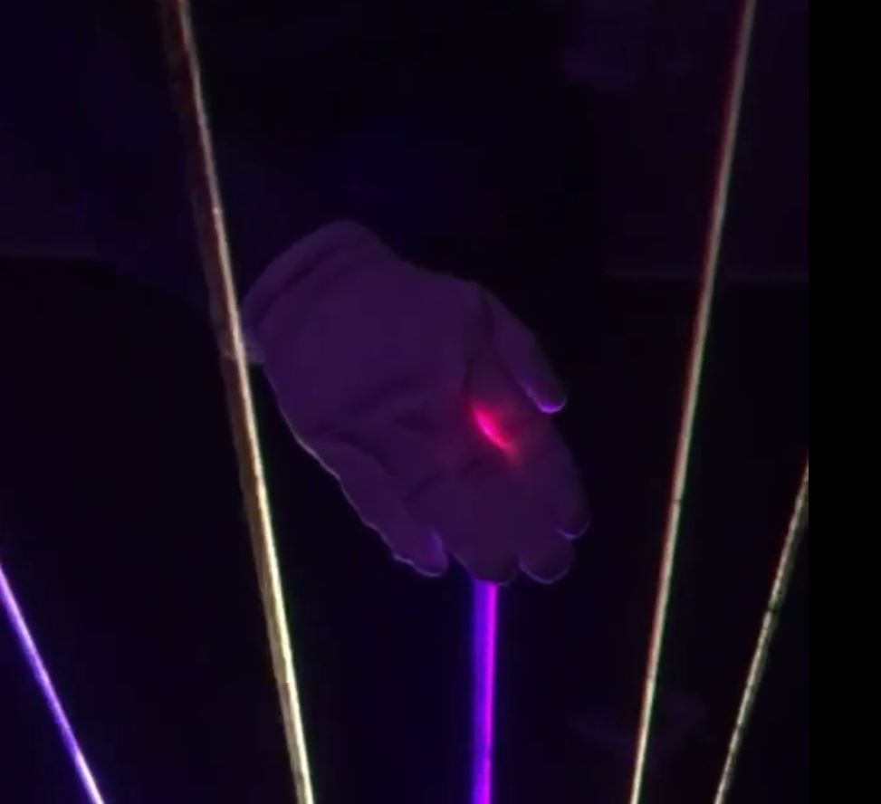
Marketing/Bilder/Laserharp.JPG
