gniliac1/COSIMA-Laserstar/Marketing/Bilder/LaserPlatte.png

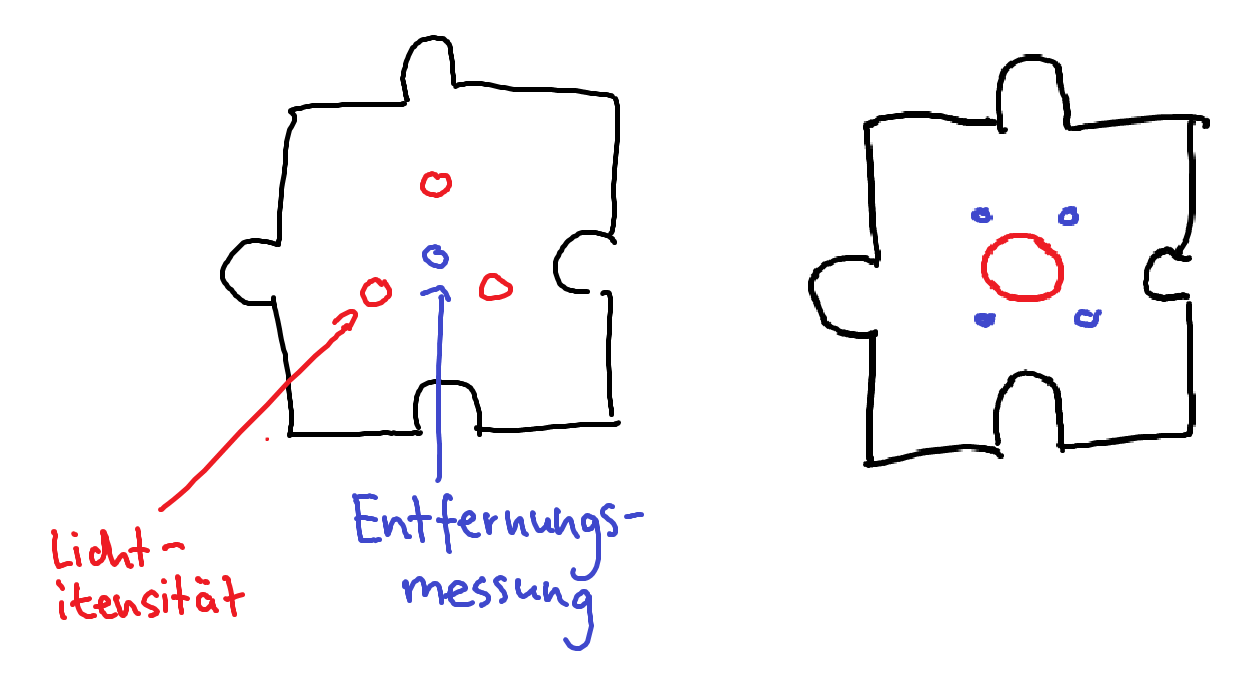
Marketing/Bilder/LaserPlatte.png
