gniliac1/COSIMA-Laserstar/Marketing/Bilder/Lichtintense.JPG

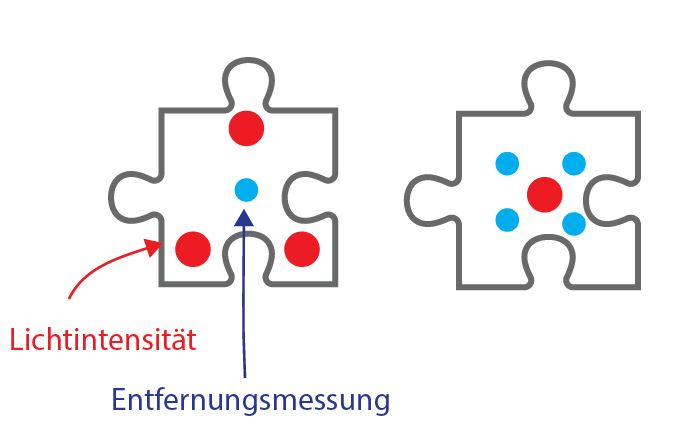
Marketing/Bilder/Lichtintense.JPG
