gniliac1/COSIMA-Laserstar/Marketing/Bilder/minority-report-gestensteuerung.jpg

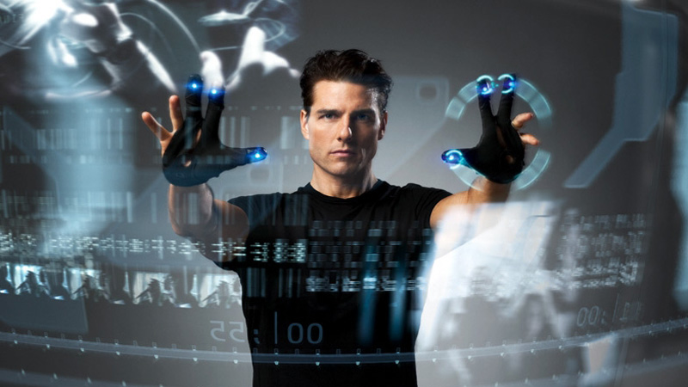
Marketing/Bilder/minority-report-gestensteuerung.jpg
