gniliac1/COSIMA-Laserstar/Marketing/Bilder/Octopus.gif

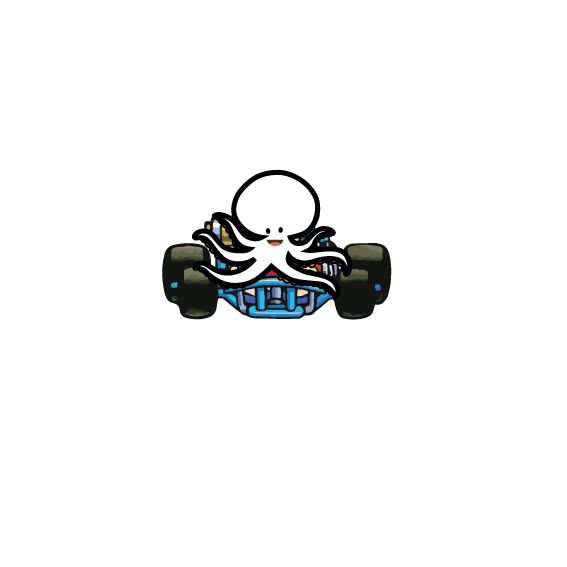
Marketing/Bilder/Octopus.gif
