gniliac1/COSIMA-Laserstar/Marketing/Bilder/Octopus_black.gif

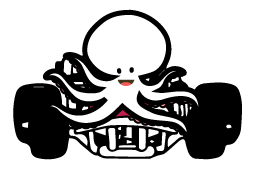
Marketing/Bilder/Octopus_black.gif
