gniliac1/COSIMA-Laserstar/Marketing/Bilder/Oktopus.png

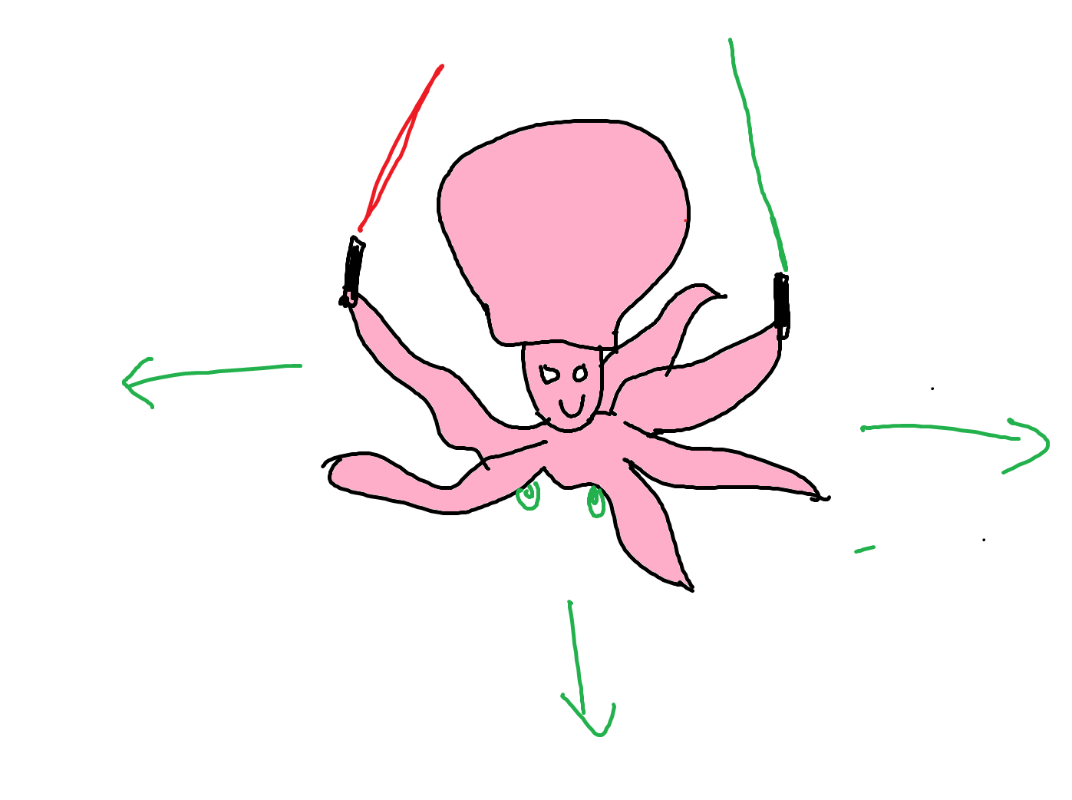
Marketing/Bilder/Oktopus.png
