gniliac1/COSIMA-Laserstar/Marketing/Bilder/Projektübersicht.JPG

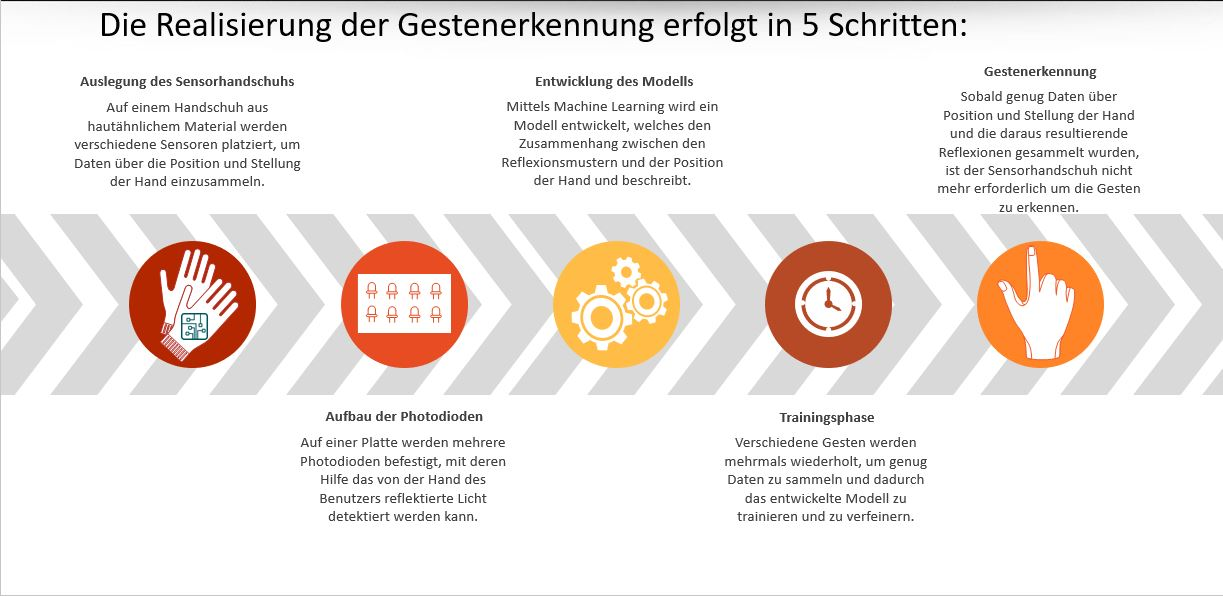
Marketing/Bilder/Projektübersicht.JPG
