gniliac1/COSIMA-Laserstar/Marketing/Bilder/Puzzles.JPG

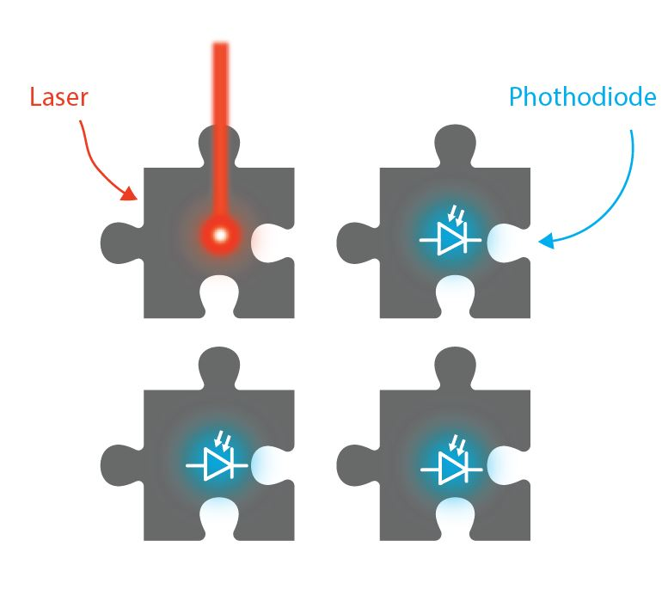
Marketing/Bilder/Puzzles.JPG
