gniliac1/COSIMA-Laserstar/Marketing/Bilder/template_main.jpg

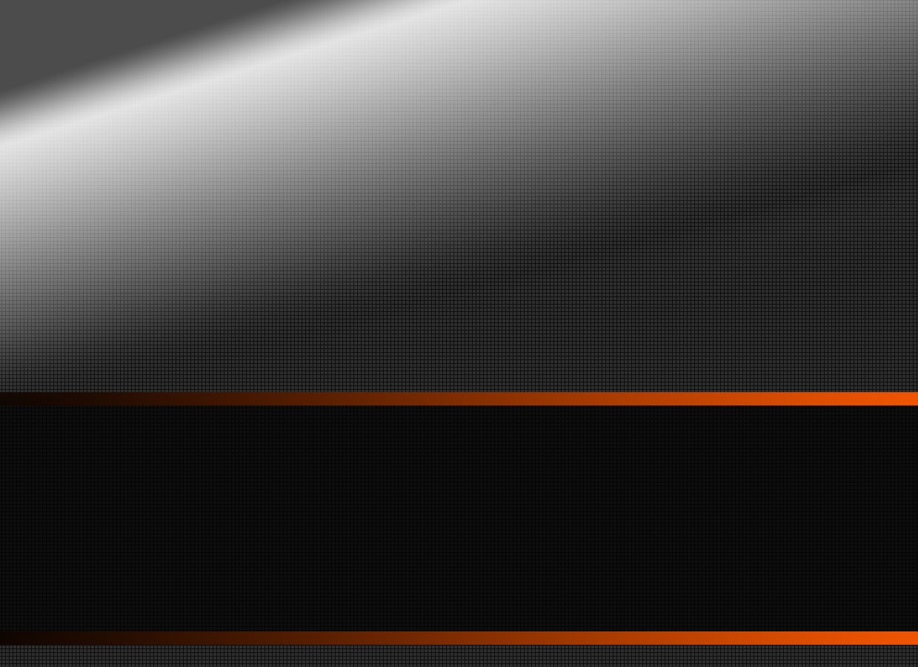
Marketing/Bilder/template_main.jpg
