gniliac1/COSIMA-Laserstar/Marketing/Fotos bei der Arbeit/Nicole Marketing.jpg

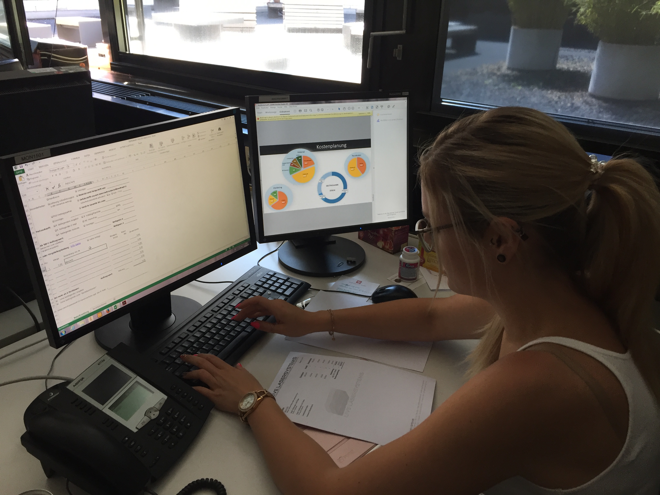
Marketing/Fotos bei der Arbeit/Nicole Marketing.jpg
