gniliac1/COSIMA-Laserstar/Marketing/Team Fotos/Anna.JPG

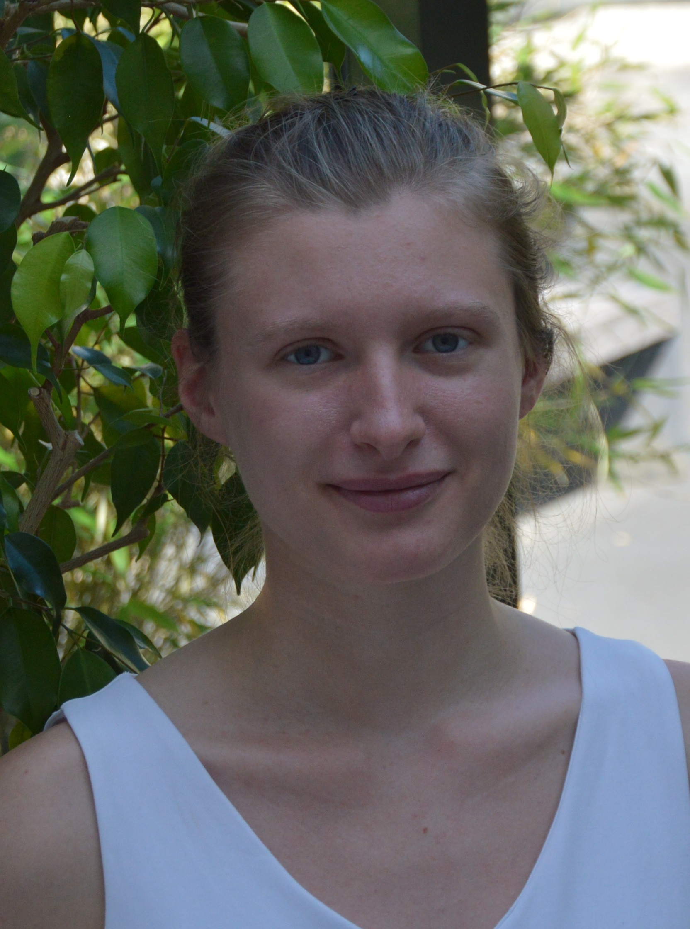
Marketing/Team Fotos/Anna.JPG
