gniliac1/COSIMA-Laserstar/Marketing/Team Fotos/Cailing.JPG

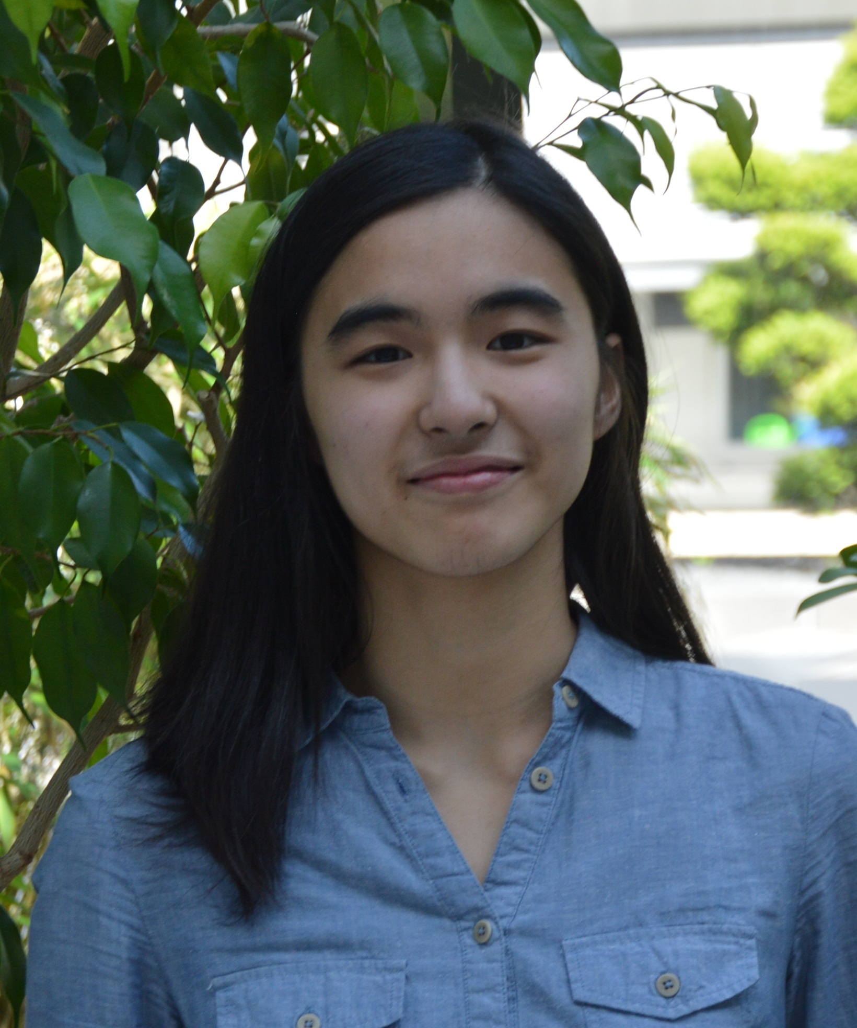
Marketing/Team Fotos/Cailing.JPG
