gniliac1/COSIMA-Laserstar/Marketing/Team Fotos/Christoph.JPG

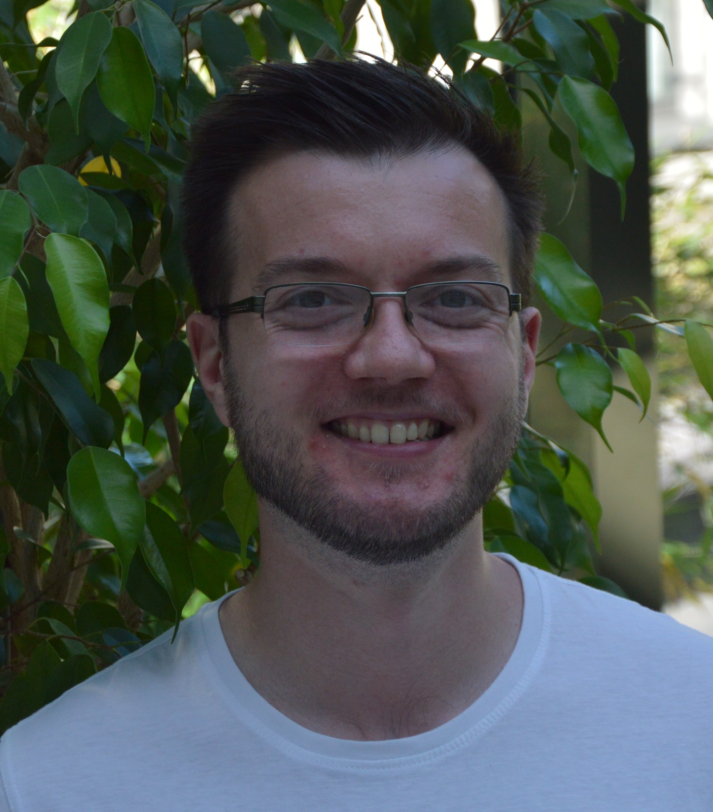
Marketing/Team Fotos/Christoph.JPG
