gniliac1/COSIMA-Laserstar/Marketing/Team Fotos/Daniel2.JPG

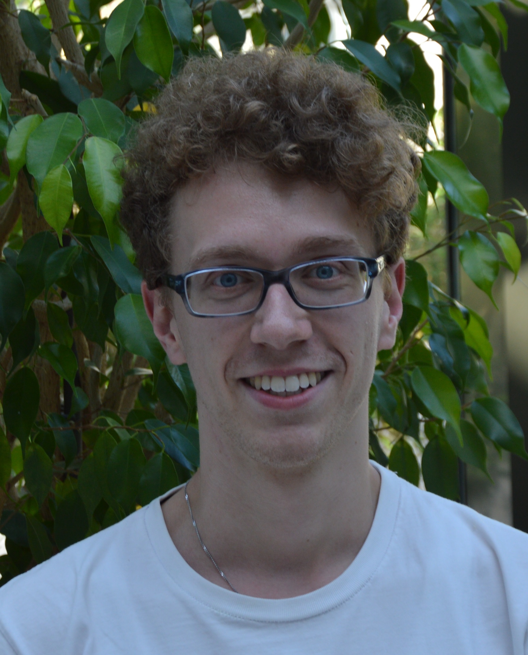
Marketing/Team Fotos/Daniel2.JPG
