gniliac1/COSIMA-Laserstar/Marketing/Team Fotos/Daniel.JPG

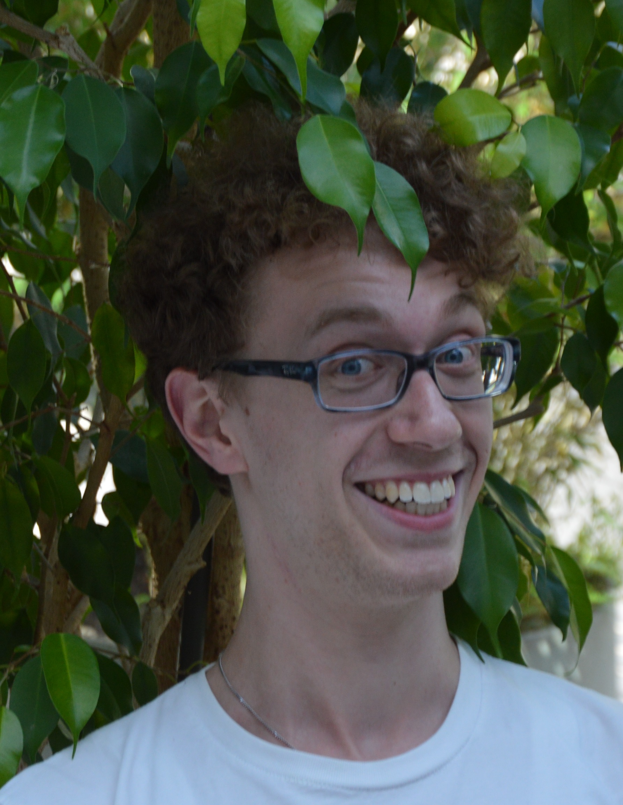
Marketing/Team Fotos/Daniel.JPG
