gniliac1/COSIMA-Laserstar/Marketing/Team Fotos/Nicole.jpg

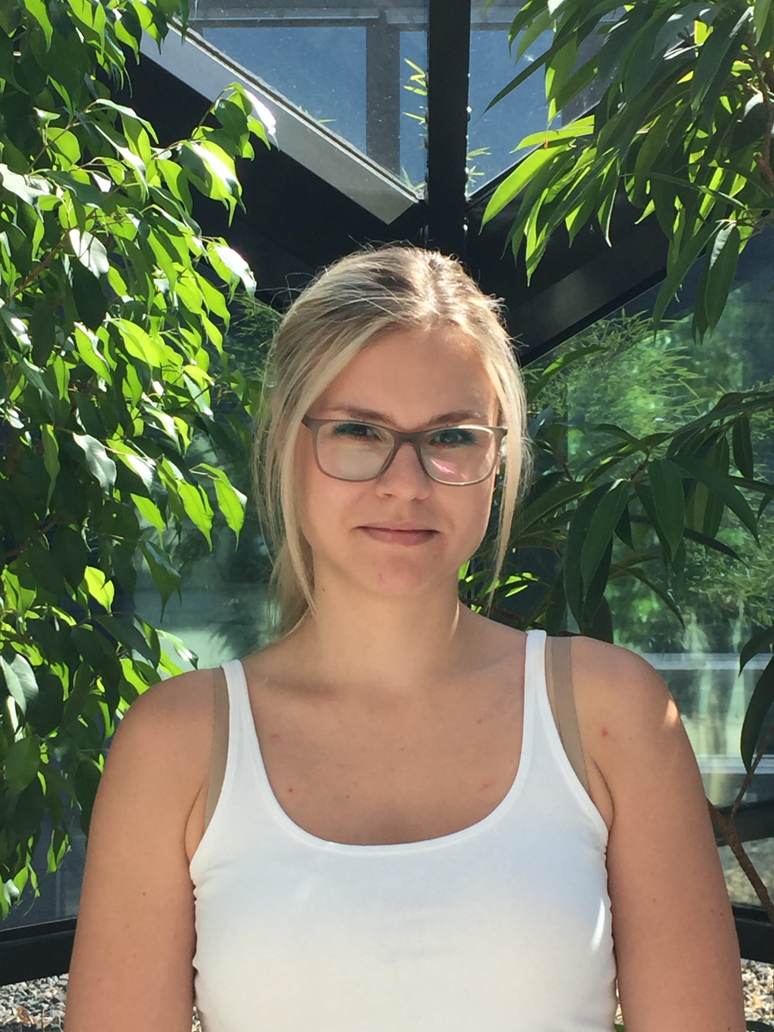
Marketing/Team Fotos/Nicole.jpg
