gniliac1/COSIMA-Laserstar/Marketing/Team Fotos/TeamPhotos_Bearbeitet/Cailing.jpg

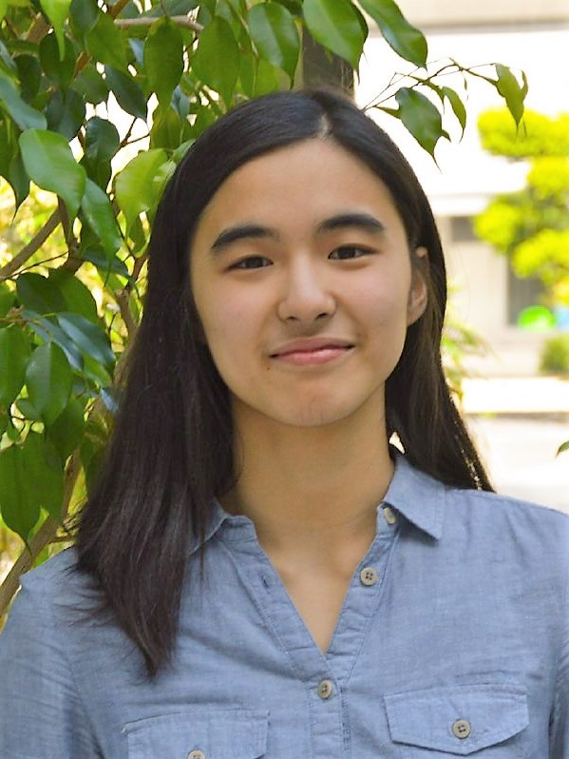
Marketing/Team Fotos/TeamPhotos_Bearbeitet/Cailing.jpg
