gniliac1/COSIMA-Laserstar/Marketing/Team Fotos/TeamPhotos_Bearbeitet/Christoph.jpg

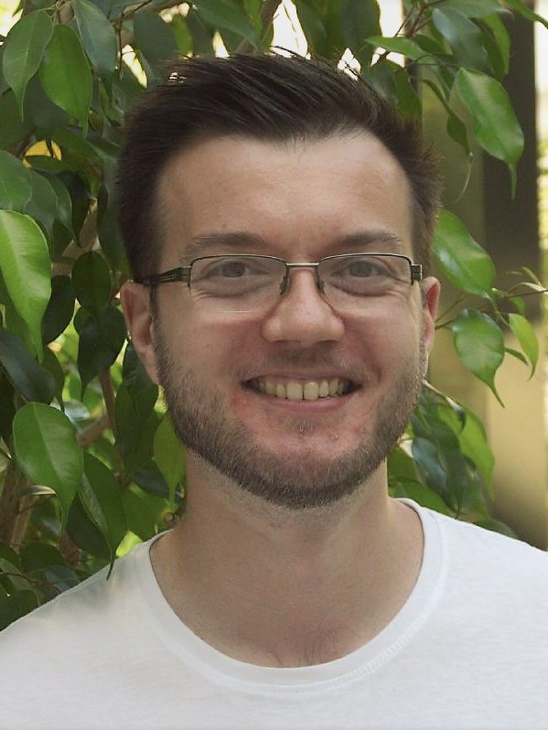
Marketing/Team Fotos/TeamPhotos_Bearbeitet/Christoph.jpg
