gniliac1/COSIMA-Laserstar/Marketing/Team Fotos/TeamPhotos_Bearbeitet/Daniel.jpg

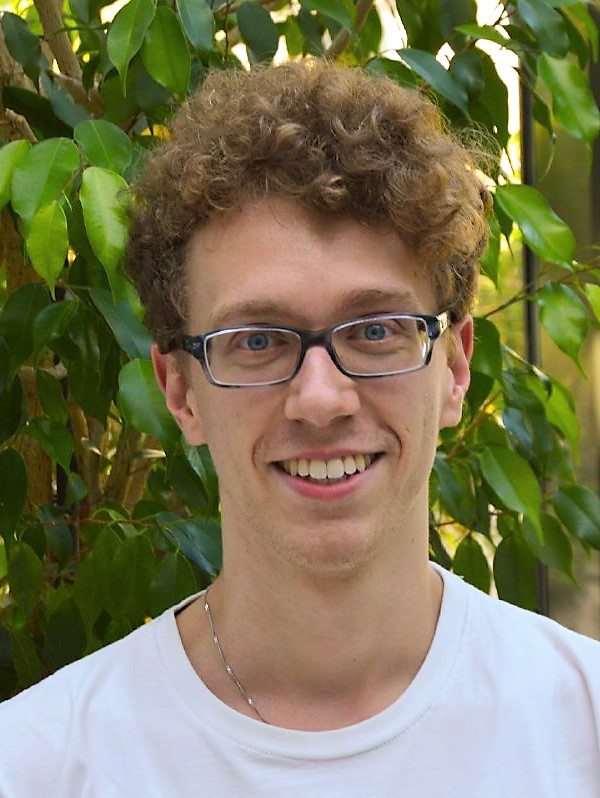
Marketing/Team Fotos/TeamPhotos_Bearbeitet/Daniel.jpg
