gniliac1/COSIMA-Laserstar/Marketing/Team Fotos/TeamPhotos_Bearbeitet/Nicole.jpg

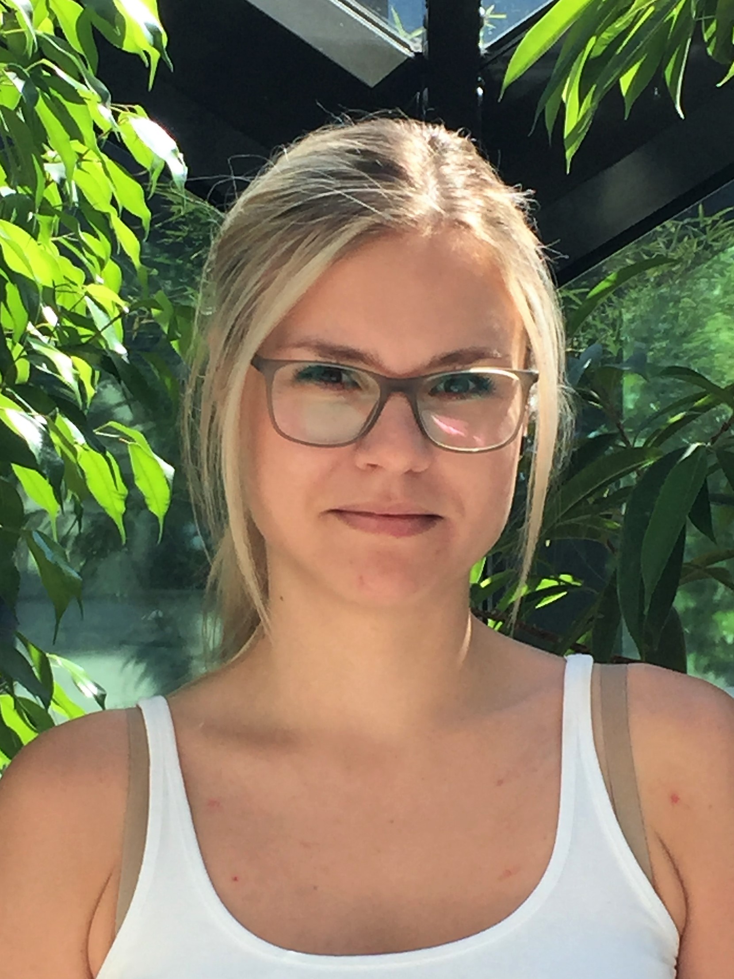
Marketing/Team Fotos/TeamPhotos_Bearbeitet/Nicole.jpg
