gniliac1/COSIMA-Laserstar/Marketing/Vector bib/2296_dark_orange/template_internal_2.jpg

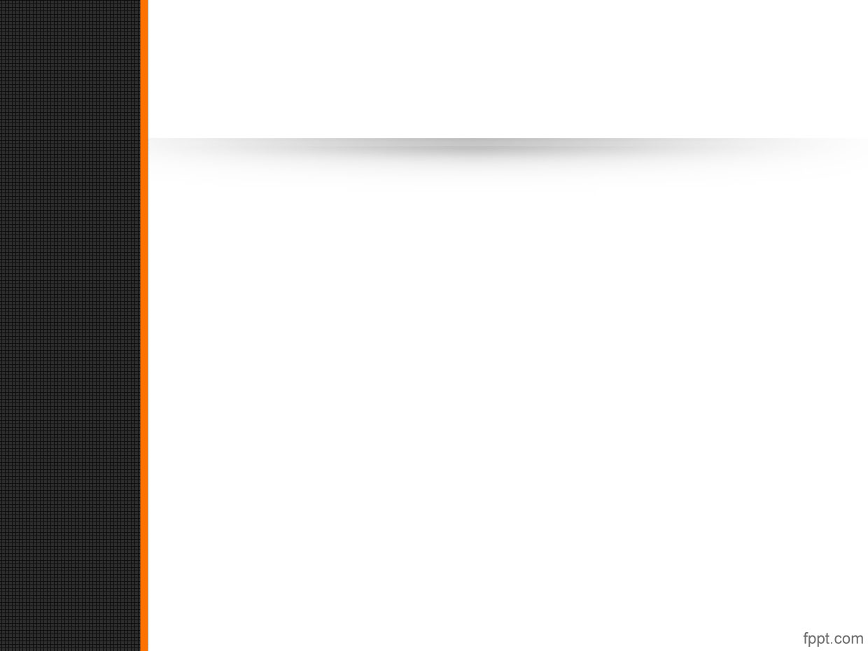
Marketing/Vector bib/2296_dark_orange/template_internal_2.jpg
