gniliac1/COSIMA-Laserstar/Marketing/Vector bib/laserlight.jpg

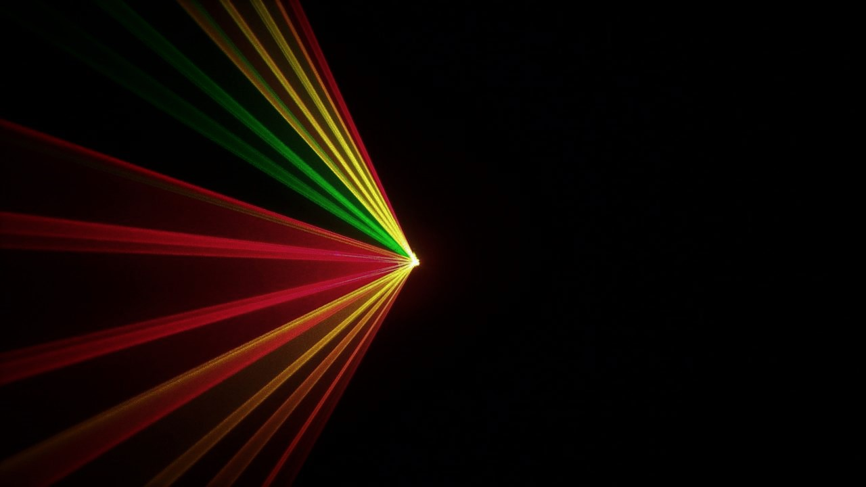
Marketing/Vector bib/laserlight.jpg
