gniliac1/COSIMA-Laserstar/Marketing/Vector bib/template_internal.jpg

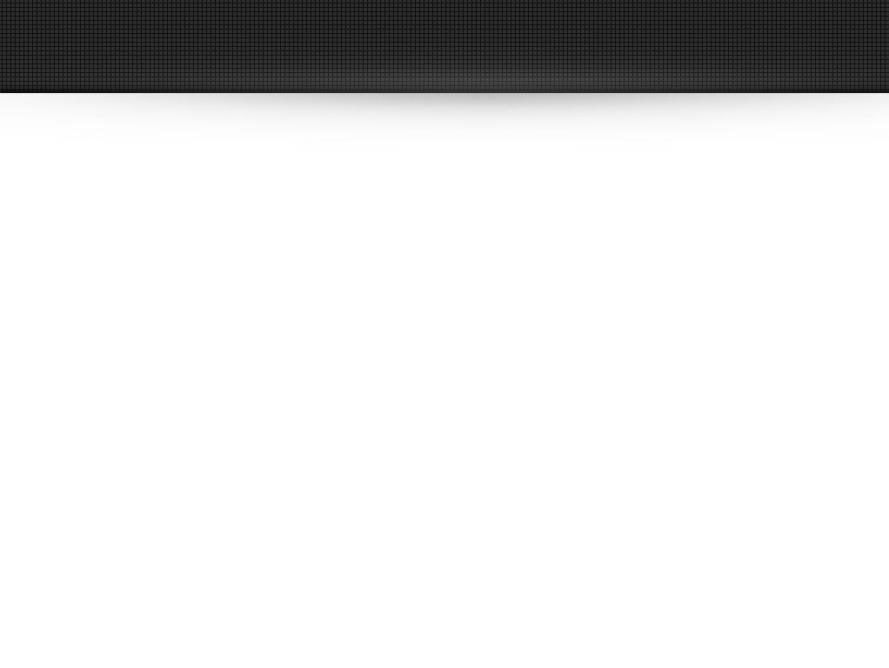
Marketing/Vector bib/template_internal.jpg
