gniliac1/COSIMA-Laserstar/Software/Abbildungen/Ablauf_main.png

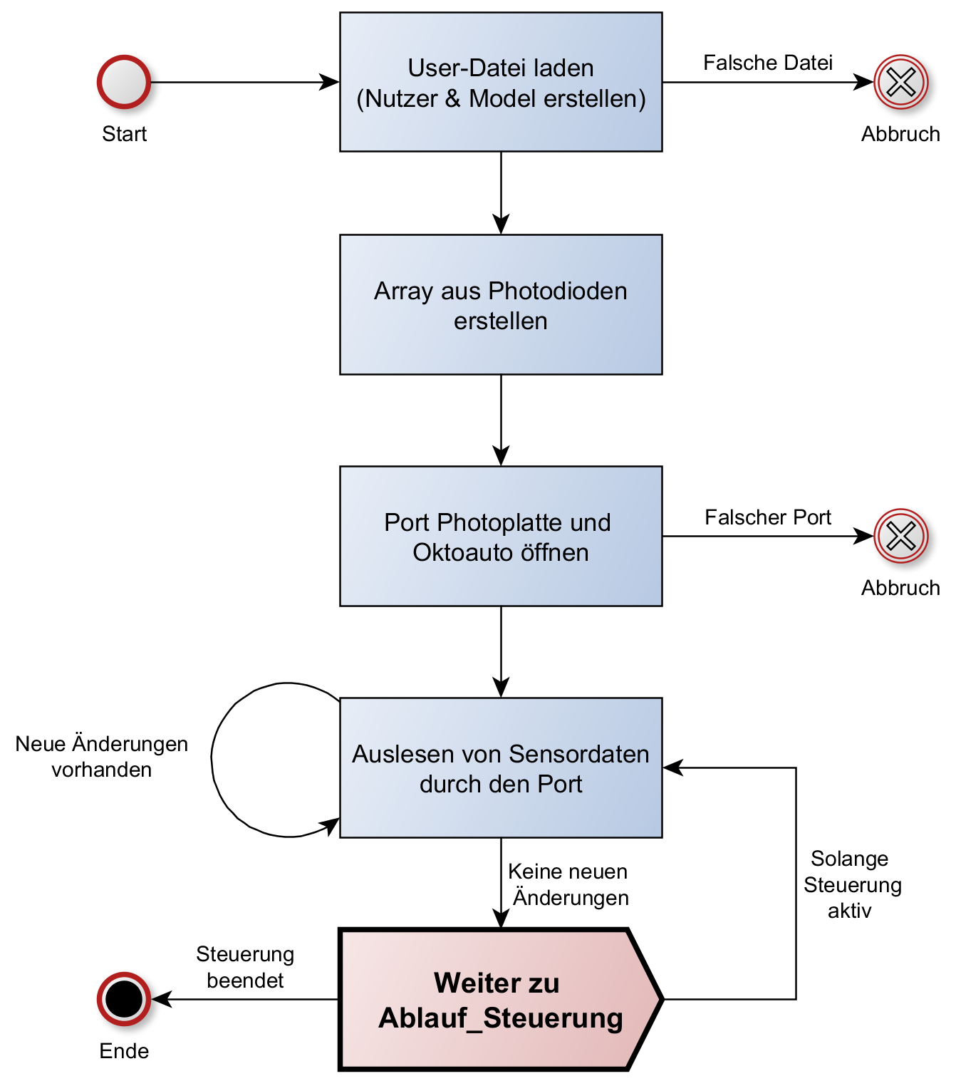
Software/Abbildungen/Ablauf_main.png
