gniliac1/COSIMA-Laserstar/Software/Abbildungen/Ablauf_Steuerung.png

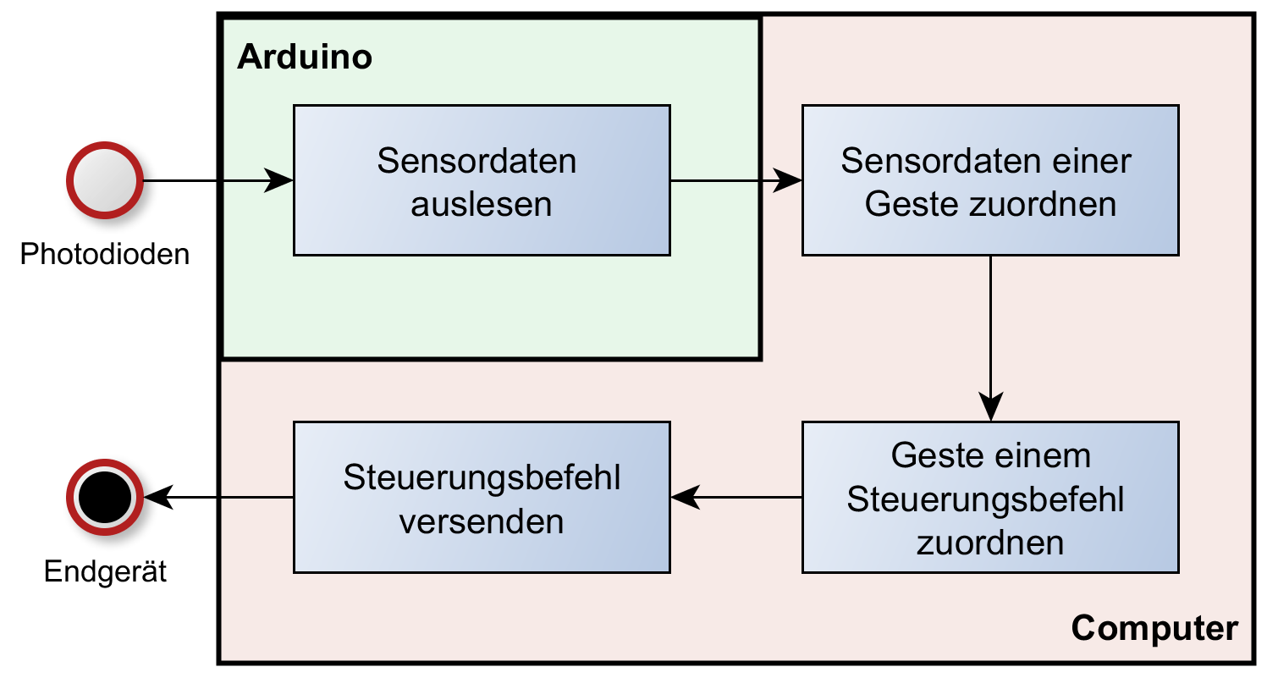
Software/Abbildungen/Ablauf_Steuerung.png
