gniliac1/COSIMA-Laserstar/Software/Abbildungen/Ablauf_Training.png

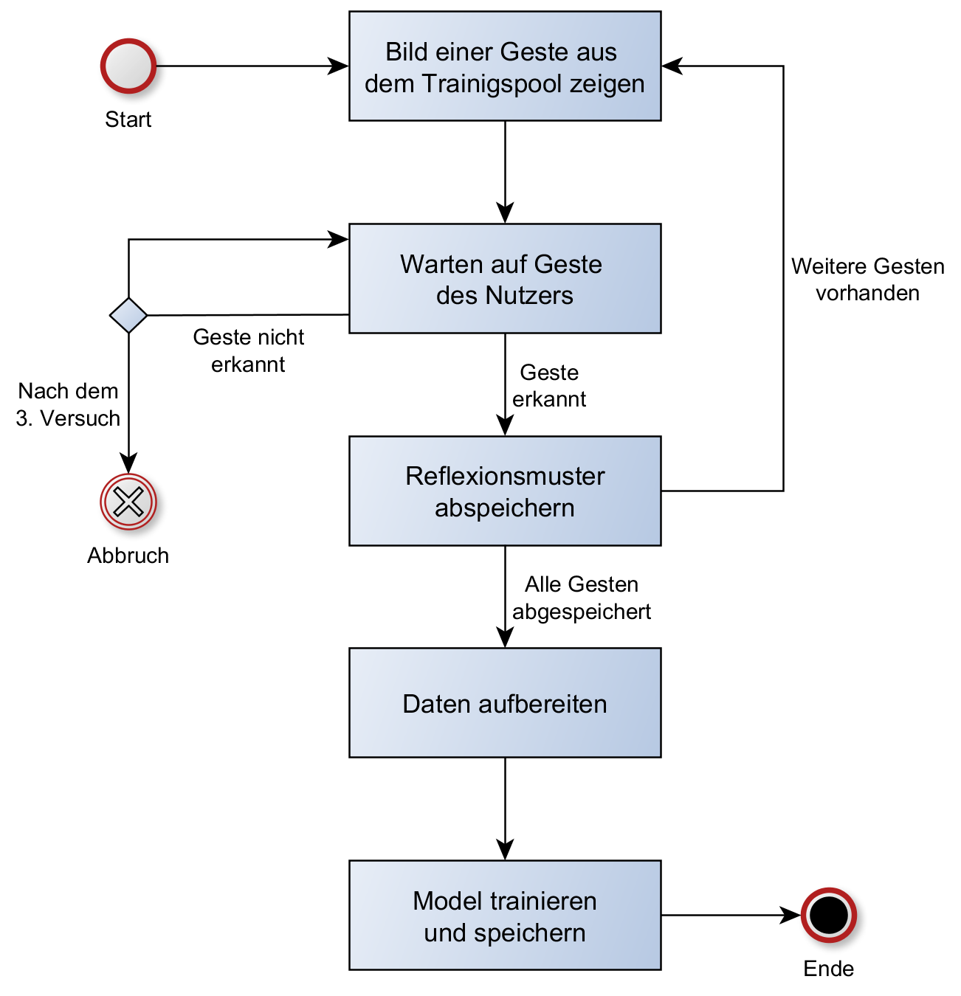
Software/Abbildungen/Ablauf_Training.png
