gniliac1/COSIMA-Laserstar/Software/Abbildungen/Flussdiagramm.png

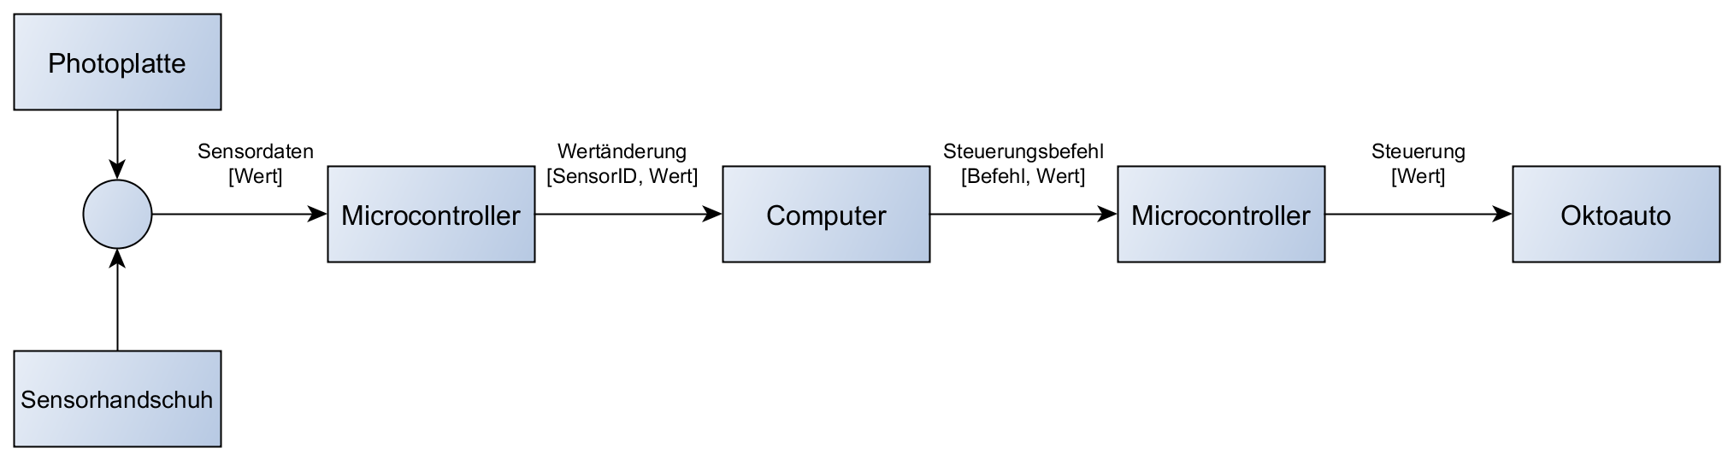
Software/Abbildungen/Flussdiagramm.png
