gniliac1/COSIMA-Laserstar/Software/Abbildungen/Klassendiagramm.png

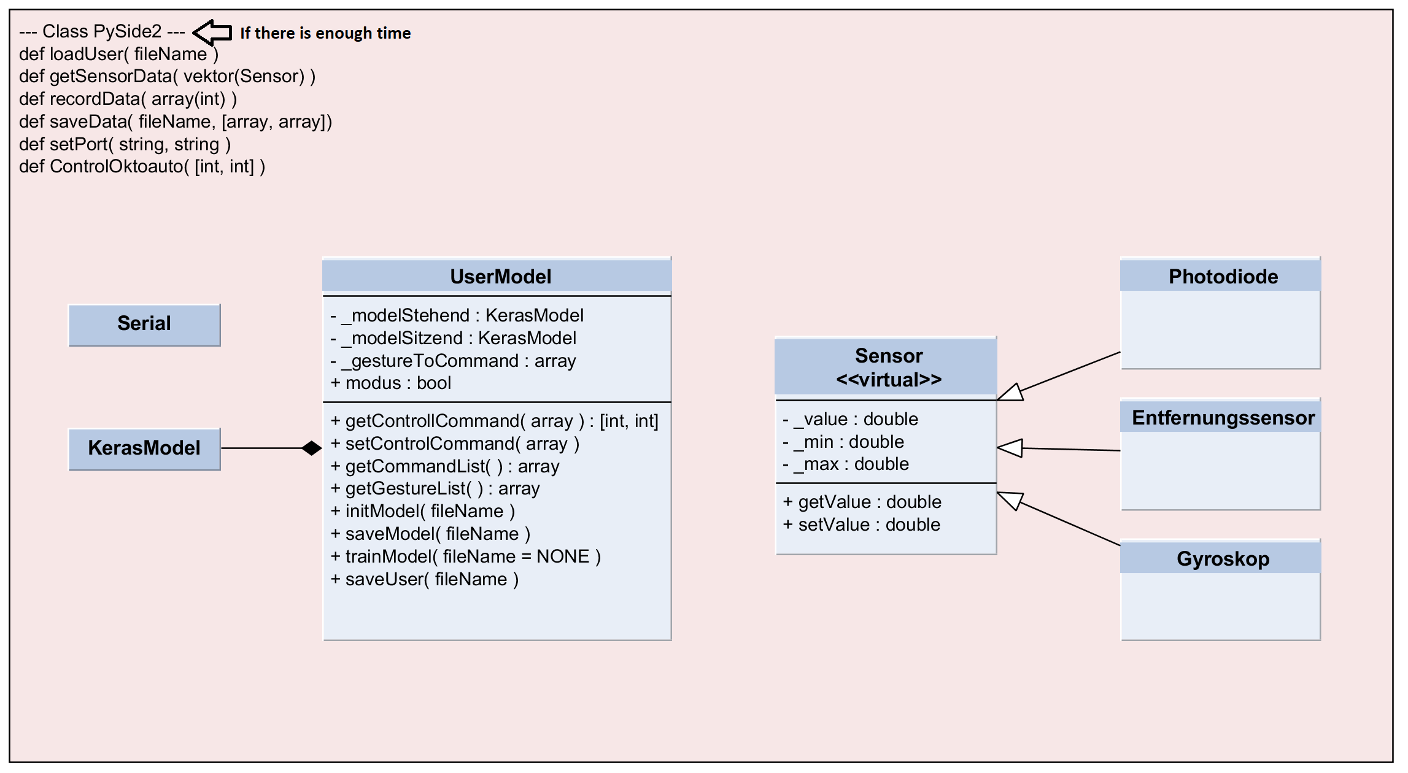
Software/Abbildungen/Klassendiagramm.png
