gniliac1/COSIMA-Laserstar/Software/Abbildungen/UseCase.png

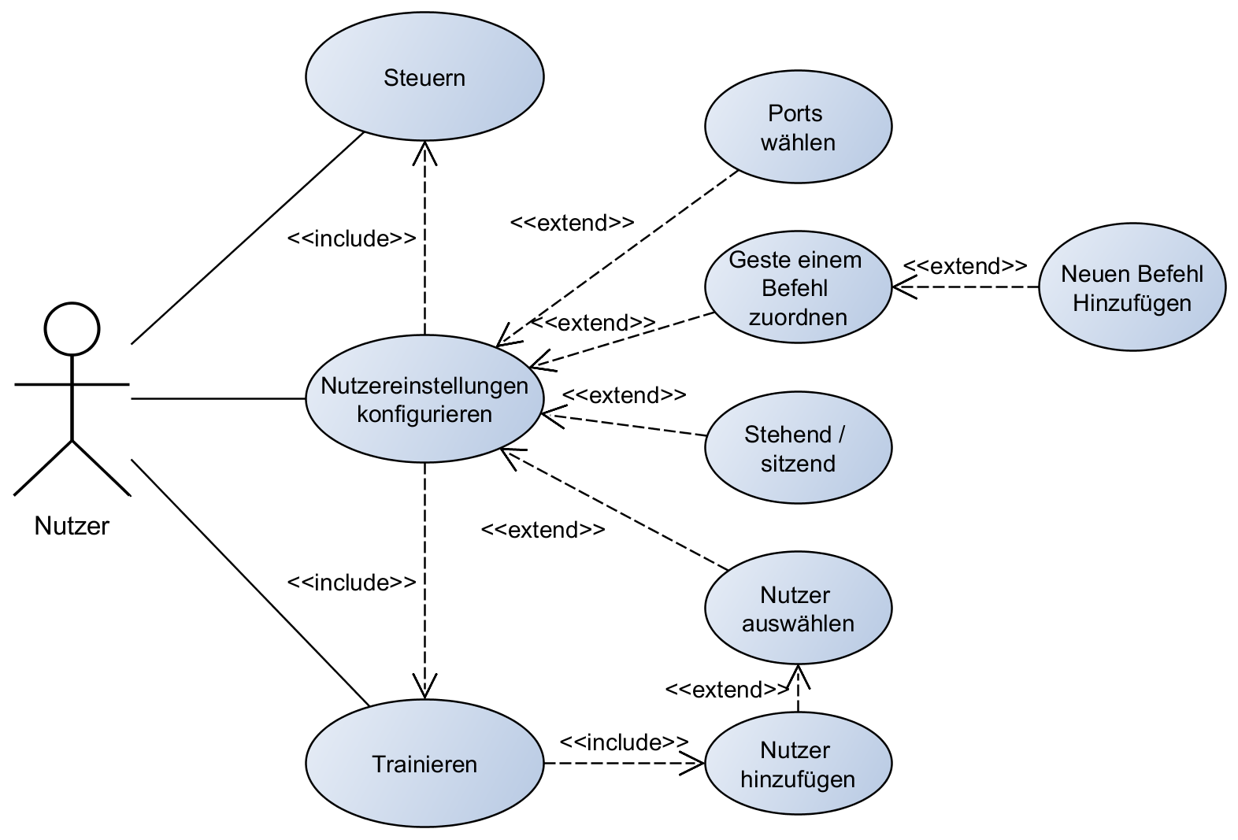
Software/Abbildungen/UseCase.png
