gniliac1/COSIMA-Laserstar/Dokumentation/Kostenschätzung COSIMA.xlsx

Sheet: Gesamt
Buget GESTIKULASER
Ausgabenposten | Personen | Preis/Pers. | Anzahl | Kosten
Reisekosten |  |  |  | 1000 €
Anreise mit der Bahn | 4 | 50 € | 2 | 400 €
alternativ: Anreise mit dem Auto | 4 | 50 € | 2 | 400 €
Unterkunft | 4 | 50 € | 3 | 600 €
Marketing |  |  |  | 150 €
T-Shirts | 4 | 25 € | 1 | 100 €
Website |  |  |  | 30 €
Informationsblätter |  |  |  | 20 €
Material |  |  |  | 500 €
Elektrotechnik |  |  |  | 350 €
Aufbau |  |  |  | 150 €
Summe |  |  |  | 2550 €

Sheet: Reisekosten
Kostenplanung Reisekosten

Sheet: Marketing
Kostenplanung Marketing

Sheet: Material
Kostenplanung Material
Einkaufsliste Elektrotechnik
Artikel | BestellNr | Anzahl | Stückpreis | Gesamt
IR Strahlquelle | Thorlabs CPS980 | 1 | 93.65 € | 93.65 €
Elektronik |  |  |  | 220.80 €
operationsverstärker | LM 358 DIP | 40 | 0.24 € | 9.60 €
photodiode | Everlight Elec PT333-3B | 40 | 0.07 € | 2.60 €
photo LED 940nm | Everlight Elec IR333C/H0/L10 | 40 | 0.06 € | 2.56 €
Widerstände | 100/120/330/10k | 100 | 0.10 € | 10.00 €
Kondensator | Divers | 100 | 0.20 € | 20.00 €
Kabel | Rot/Gleb/Schwarz | 3 | 3.00 € | 9.00 €
Breadboard |  | 3 | 3.00 € | 9.00 €
Platine | Loch/China | 3 | 10.00 € | 30.00 €
Potentiometer |  | 30 | 1.00 € | 30.00 €
IR Photodioden |  | 30 | 0.90 € | 27.00 € | https://www.thorlabs.com/thorproduct.cfm?partnumber=CPS980
Adafruit ADS1015 12-Bit ADC - 4 Channel with Programmable Gain Amplifier |  | 6 | 11.84 € | 71.04 € | https://eckstein-shop.de/Adafruit-ADS1015-12-Bit-ADC-4-Channel-with-Programmable-Gain-Amplifier
Photomatrix |  |  |  | 314.45 €
Aufbau
 |  | Anzahl | Stückkosten | Kosten
3D Filament |  | 1 | 50.00 € | 50.00 €
Ferngesteuertes Auto |  | 1 | 20.00 € | 20.00 €
Laserpointer |  | 4 | 8.00 € | 32.00 €
Linsen |  | 2 | 18.00 € | 36.00 €
 |  |  |  | 138.00 €
Summe Material |  |  |  | 452.45 €
