gniliac1/COSIMA-Laserstar/CAD/2-1mm-dc-power-socket/2.1mm_DC_Power_Socket.stp

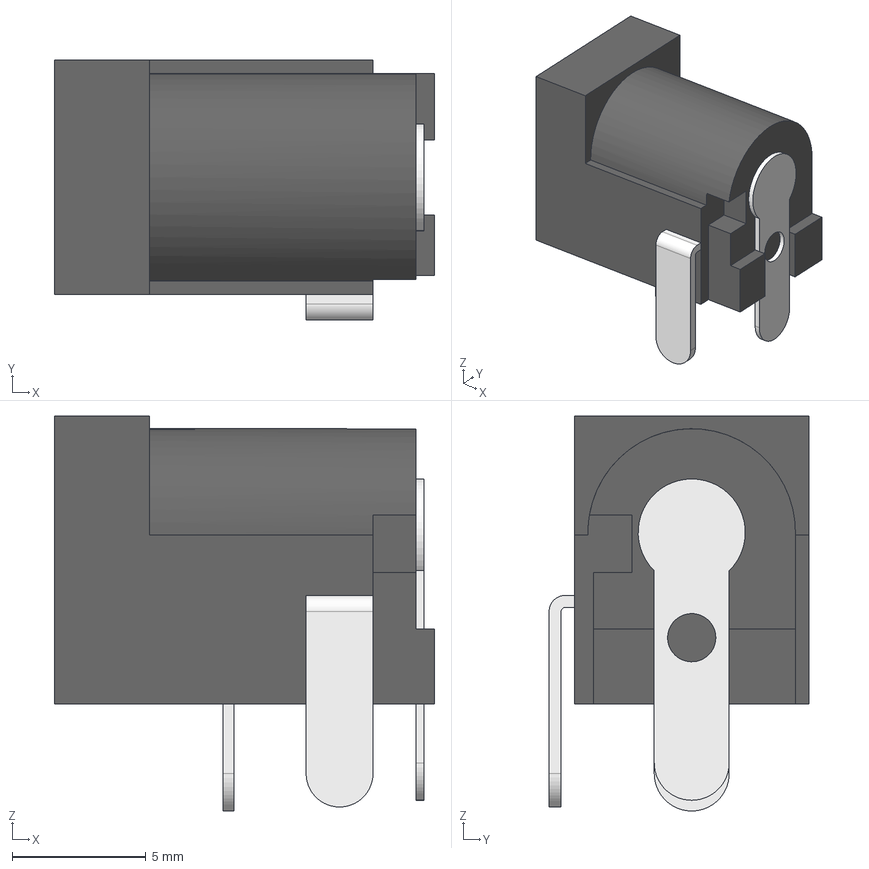
[picture p209: CAD file, 2018-10-31]
CAD/2-1mm-dc-power-socket/2.1mm_DC_Power_Socket.stp
14.2 x 9.70 x 14.8 mm
2.1mm DC Power Socket Housing
2.1mm DC Power Socket Pin
Terminal 1
Terminal 2
Terminal 3
