gniliac1/COSIMA-Laserstar/CAD/CAD stl/Oktagon_Deckel.stl

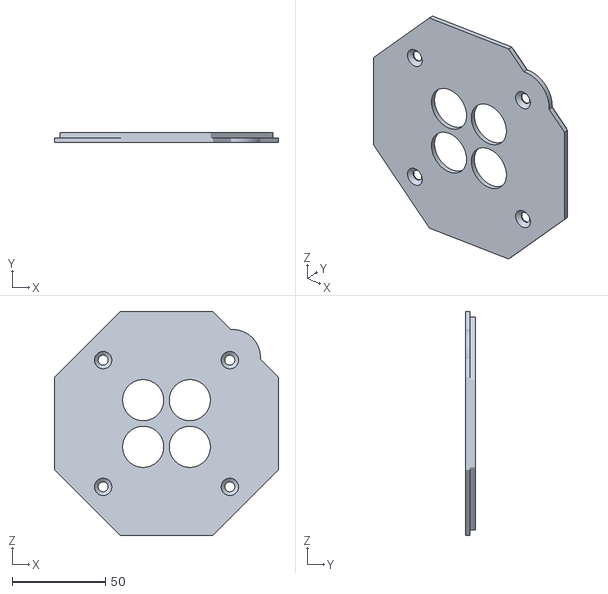
[picture p210: CAD file, 2018-11-12]
CAD/CAD stl/Oktagon_Deckel.stl
120.0 x 5.50 x 120.0
