gniliac1/COSIMA-Laserstar/CAD/female-usb-type-a-connector-pcb-thru-hole-1.snapshot.4/femaleThruHoleUSB.stp

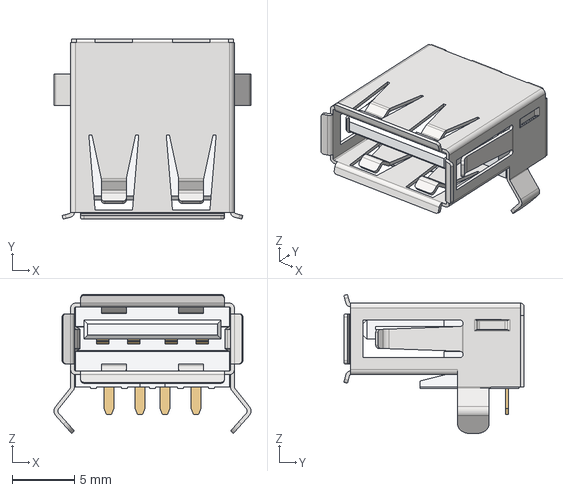
[picture p211: CAD file, 2018-10-31]
CAD/female-usb-type-a-connector-pcb-thru-hole-1.snapshot.4/femaleThruHoleUSB.stp
15.8 x 14.4 x 11.1 mm
