gniliac1/COSIMA-Laserstar/CAD/files/Cute_Octo_Graduate/files/grad_without_15.stl

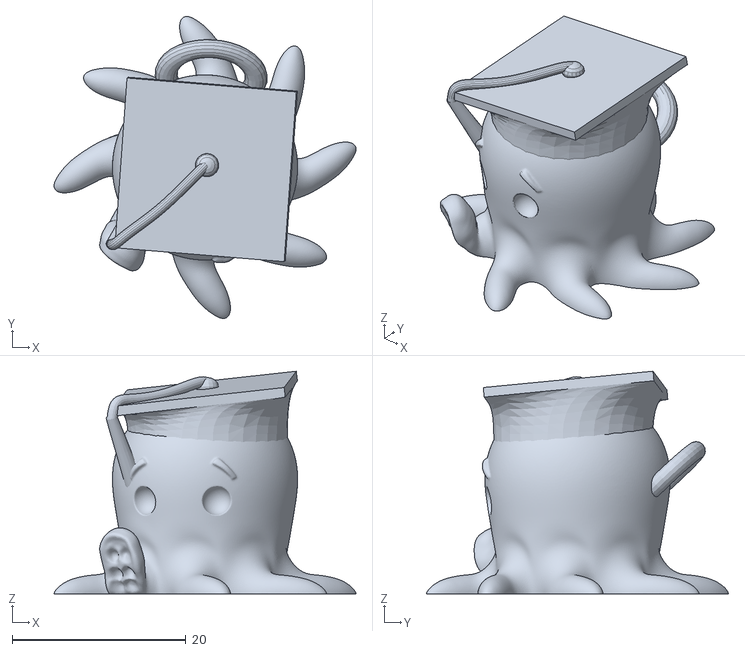
[picture p212: CAD file, 2018-08-21]
CAD/files/Cute_Octo_Graduate/files/grad_without_15.stl
34.8 x 34.8 x 25.6
