gniliac1/COSIMA-Laserstar/CAD/files/Lego_4Block.stl

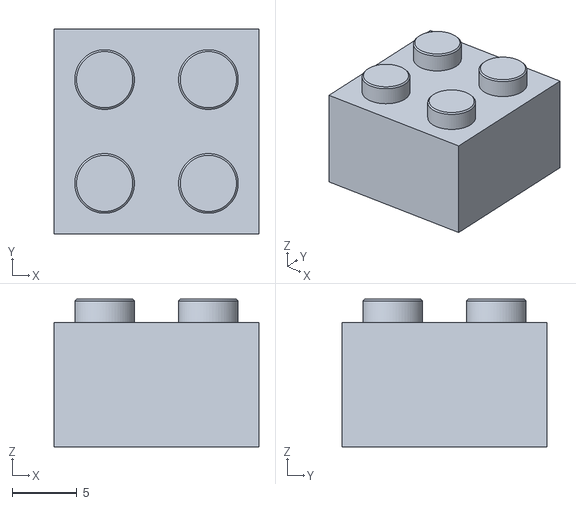
[picture p213: CAD file, 2018-08-16]
CAD/files/Lego_4Block.stl
15.8 x 15.8 x 11.4
