gniliac1/COSIMA-Laserstar/CAD/tca9548a-8-channel-i2c-multyplexer-1.snapshot.1/tca9548a.stp

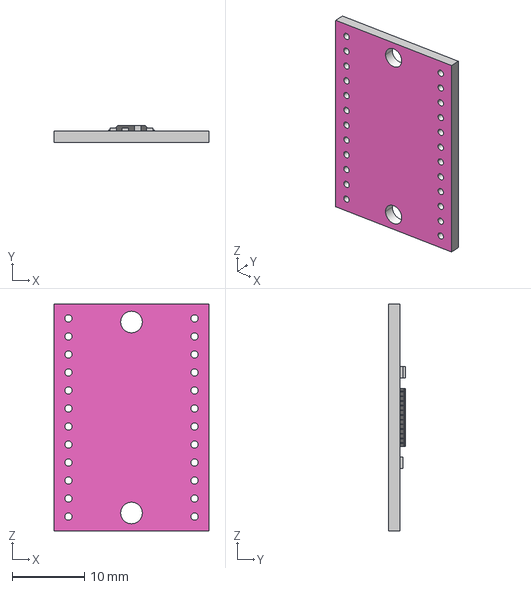
[picture p215: CAD file, 2018-10-31]
CAD/tca9548a-8-channel-i2c-multyplexer-1.snapshot.1/tca9548a.stp
21.5 x 2.40 x 31.5 mm
