gniliac1/COSIMA-Laserstar/CAD/usb-connector-5.snapshot.13/USB_surinkimas v4.step

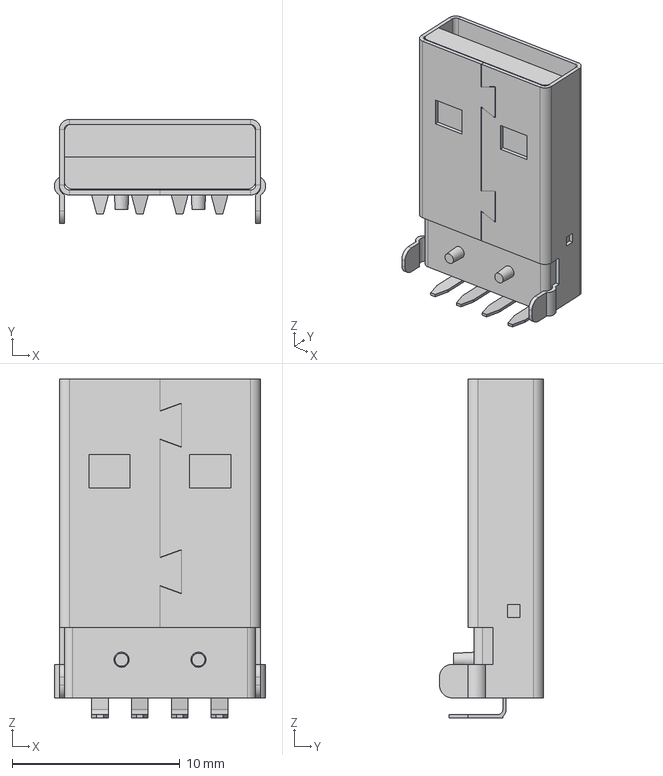
[picture p216: CAD file, 2018-10-31]
CAD/usb-connector-5.snapshot.13/USB_surinkimas v4.step
12.6 x 6.20 x 20.2 mm
usb_inside v5
USB v6
