gniliac1/COSIMA-Laserstar/CAD/CAD stl/Oktagon_Gehäuse.stl

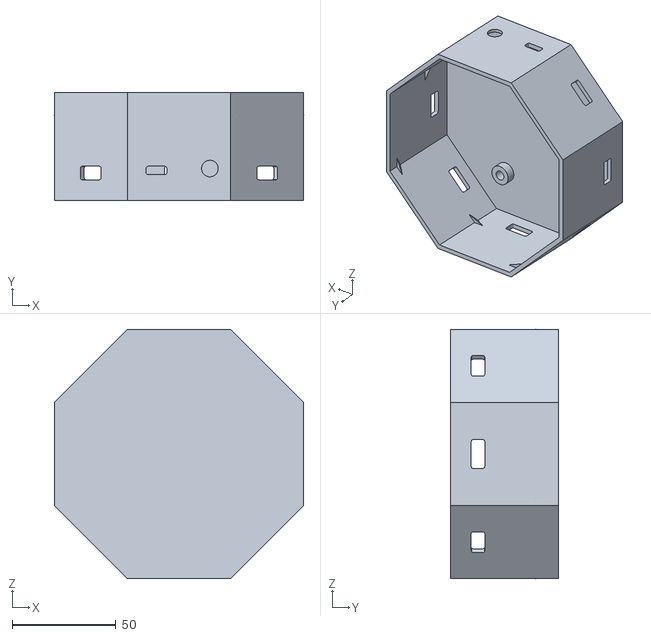
[picture p217: CAD file, 2018-11-12]
CAD/CAD stl/Oktagon_Gehäuse.stl
120.3 x 52.0 x 120.3
