gniliac1/COSIMA-Laserstar/CAD/files/Cute_Octo_Graduate/files/Hat_only.stl

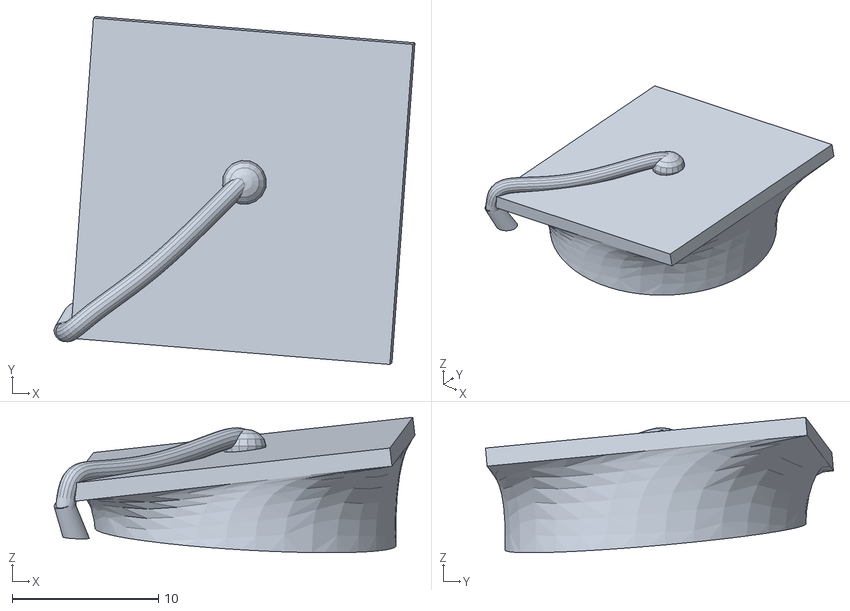
[picture p219: CAD file, 2018-08-21]
CAD/files/Cute_Octo_Graduate/files/Hat_only.stl
24.7 x 23.8 x 9.27
