gniliac1/COSIMA-Laserstar/CAD/files/Lego_8Block.stl

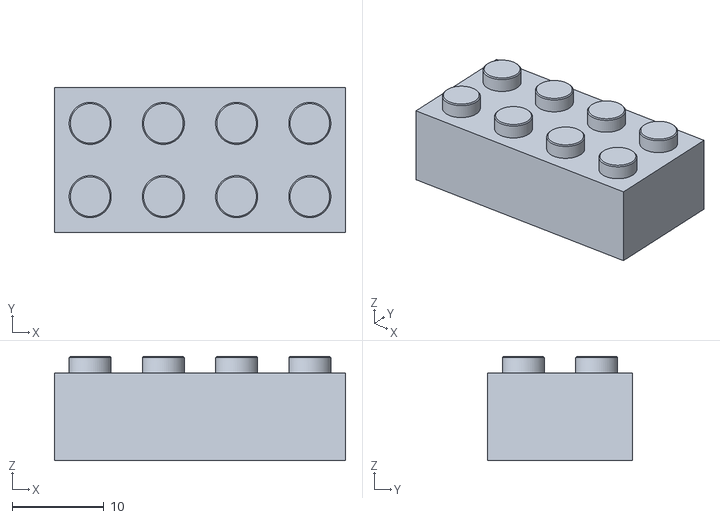
[picture p220: CAD file, 2018-08-16]
CAD/files/Lego_8Block.stl
31.8 x 15.8 x 11.4
