gniliac1/COSIMA-Laserstar/CAD/CAD stl/Detektormodul_Gehäuse.stl

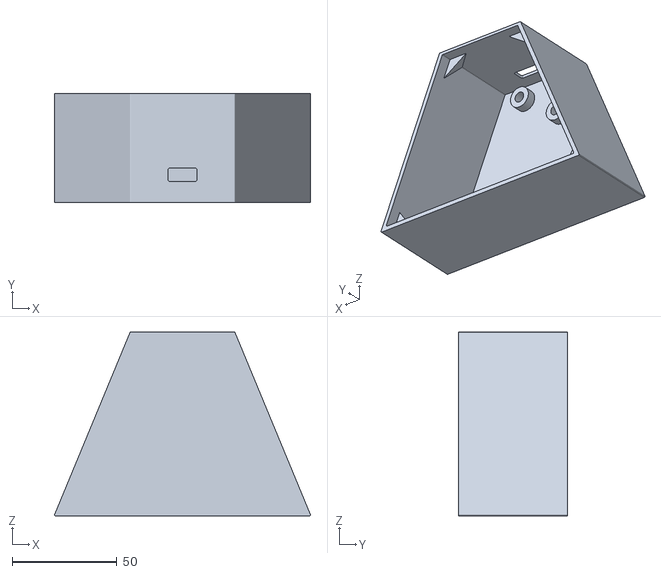
[picture p221: CAD file, 2018-11-12]
CAD/CAD stl/Detektormodul_Gehäuse.stl
122.0 x 52.0 x 87.7
