gniliac1/COSIMA-Laserstar/CAD/files/Articulated_Cuttlefish__Ball-joint_articulated_octopus_Remix__/files/tentacle_4_links.stl

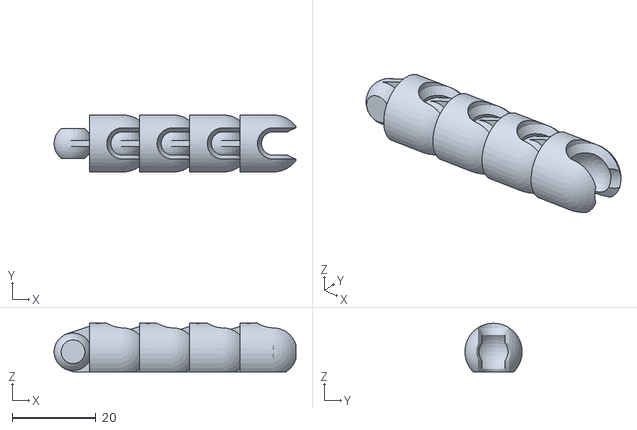
[picture p222: CAD file, 2018-08-21]
CAD/files/Articulated_Cuttlefish__Ball-joint_articulated_octopus_Remix__/files/tentacle_4_links.stl
57.9 x 13.7 x 11.6
