gniliac1/COSIMA-Laserstar/CAD/files/Cute_Octo_Graduate/files/graduation_octo_16.stl

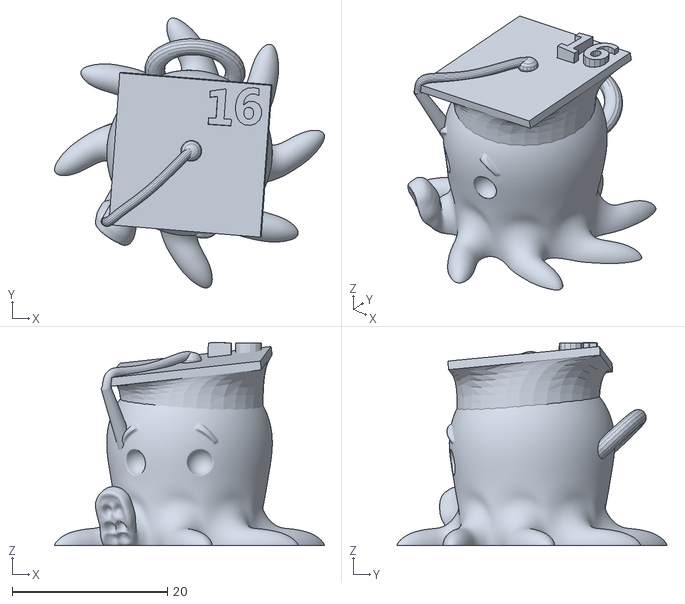
[picture p223: CAD file, 2018-08-21]
CAD/files/Cute_Octo_Graduate/files/graduation_octo_16.stl
34.8 x 34.8 x 26.2
