gniliac1/COSIMA-Laserstar/CAD/files/Lego_12Block.stl

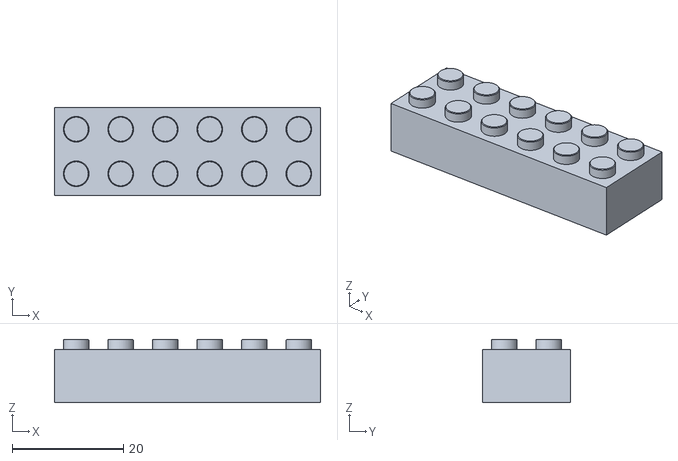
[picture p224: CAD file, 2018-08-16]
CAD/files/Lego_12Block.stl
47.8 x 15.8 x 11.4
