gniliac1/COSIMA-Laserstar/CAD/CAD stl/Detektormodul_Deckel.stl

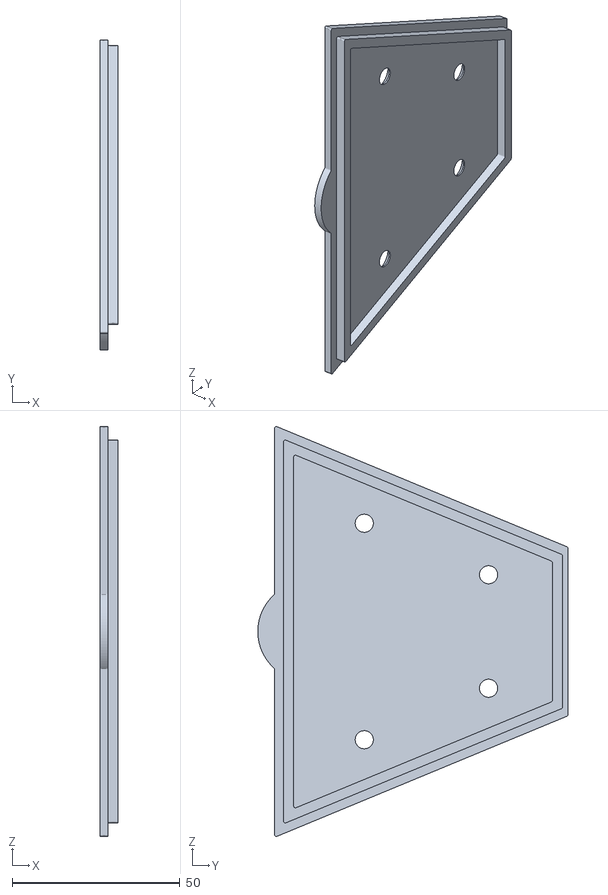
[picture p225: CAD file, 2018-11-12]
CAD/CAD stl/Detektormodul_Deckel.stl
5.50 x 92.4 x 122.0
