gniliac1/COSIMA-Laserstar/CAD/files/Lego_6Block.stl

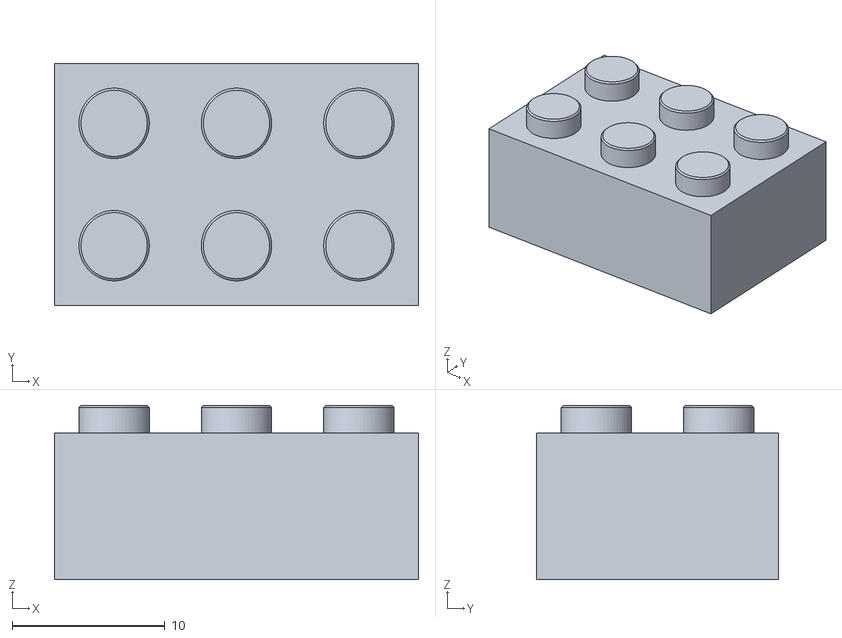
[picture p226: CAD file, 2018-08-16]
CAD/files/Lego_6Block.stl
23.8 x 15.8 x 11.4
