gniliac1/COSIMA-Laserstar/CAD/CAD stl/Stage3_Oktokommander.stl

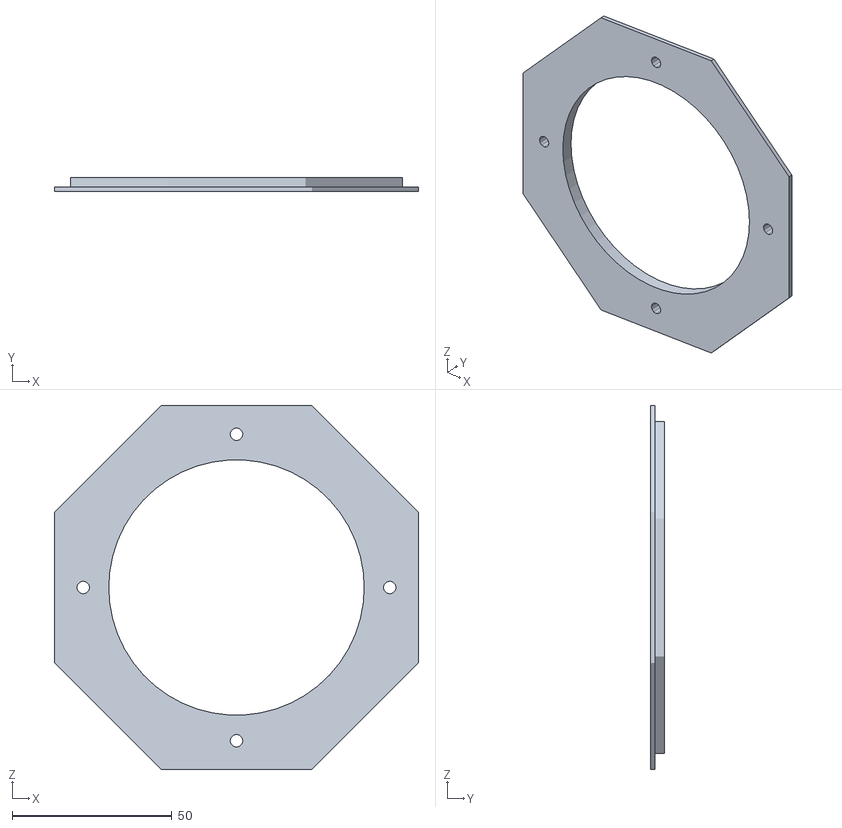
[picture p227: CAD file, 2018-11-11]
CAD/CAD stl/Stage3_Oktokommander.stl
114.0 x 4.50 x 114.0
