gniliac1/COSIMA-Laserstar/CAD/CAD stl/Stage2_Detektormodul.stl

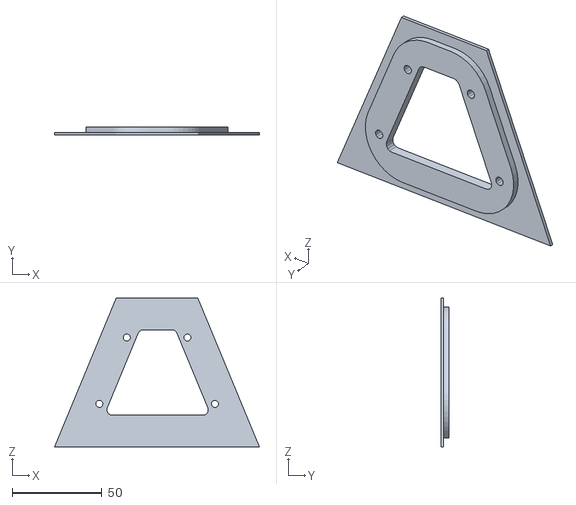
[picture p228: CAD file, 2018-11-11]
CAD/CAD stl/Stage2_Detektormodul.stl
114.3 x 4.50 x 83.0
