gniliac1/COSIMA-Laserstar/CAD/CAD stl/Stage2 Oktokommander.stl

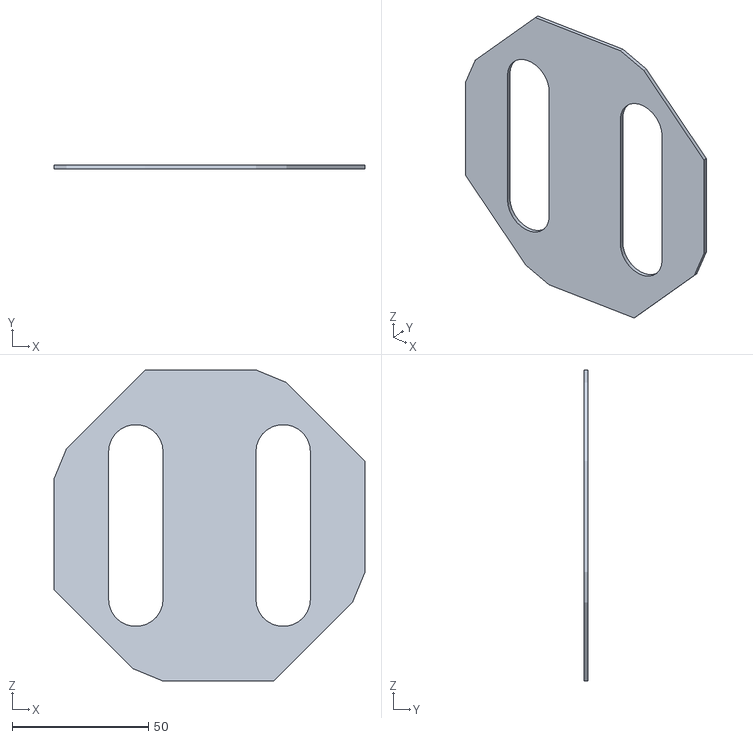
[picture p229: CAD file, 2018-11-11]
CAD/CAD stl/Stage2 Oktokommander.stl
114.0 x 1.50 x 114.0
