gniliac1/COSIMA-Laserstar/(list of files, cad)

Other CAD files:
CAD/files/Articulated_Cuttlefish__Ball-joint_articulated_octopus_Remix__/files/cuttlefish_upright.stp
CAD/2-1mm-dc-power-socket/2.1mm_DC_Power_Socket.stl
CAD/Arduino_Oktagon.iam
CAD/Computer-Dummie/Monitor.ipt
CAD/Computer-Dummie/OldVersions/Tastatur.0001.ipt
CAD/Computer-Dummie/PC-Dummie.iam
CAD/Computer-Dummie/Tastatur.ipt
CAD/DeckelParabol.iam
CAD/Detektormodul/Adafruit.ipt
CAD/Detektormodul/DetektorElektronik_Stage1.iam
CAD/Detektormodul/DetektorElektronik_Stage2.iam
CAD/Detektormodul/Detektormodul.iam
CAD/Detektormodul/Detektorplatine.ipt
CAD/Detektormodul/OldVersions/DetektorElektronik_Stage1.0009.iam
CAD/Detektormodul/OldVersions/DetektorElektronik_Stage2.0007.iam
CAD/Detektormodul/OldVersions/Detektormodul.0033.iam
CAD/Detektormodul/OldVersions/Detektorplatine.0003.ipt
CAD/Detektormodul/OldVersions/Photodiodendummie.0005.ipt
CAD/Detektormodul/OldVersions/Stage2.0011.ipt
CAD/Detektormodul/OldVersions/USB_male.0001.ipt
CAD/Detektormodul/Photodiodendummie.ipt
CAD/Detektormodul/SlavesSammelplatine.iam
CAD/Detektormodul/Stage2.ipt
CAD/Detektormodul/USB_male.ipt
CAD/Gestikulaser.iam
CAD/Hotrod/000_01.iam
CAD/Hotrod/000_02.iam
CAD/Hotrod/000_03.iam
CAD/Hotrod/001.ipt
CAD/Hotrod/003.ipt
CAD/Hotrod/004.ipt
CAD/Hotrod/005.ipt
CAD/Hotrod/006.ipt
CAD/Hotrod/007.ipt
CAD/Hotrod/008.ipt
CAD/Hotrod/009.ipt
CAD/Hotrod/010.ipt
CAD/Hotrod/013.ipt
CAD/Hotrod/015.ipt
CAD/Hotrod/016.ipt
CAD/Hotrod/017.ipt
CAD/Hotrod/018.ipt
CAD/Hotrod/019.ipt
CAD/Hotrod/020.ipt
CAD/Hotrod/0204_5.ipt
CAD/Hotrod/021.ipt
CAD/Hotrod/022.ipt
CAD/Hotrod/031.ipt
CAD/Hotrod/033.ipt
CAD/Hotrod/034.ipt
CAD/Hotrod/035.ipt
CAD/Hotrod/036.ipt
CAD/Hotrod/037.ipt
CAD/Hotrod/037_MIR.ipt
CAD/Hotrod/039.ipt
CAD/Hotrod/041.ipt
CAD/Hotrod/04P.ipt
CAD/Hotrod/2,54_0,8.ipt
CAD/Hotrod/3,0.ipt
CAD/Hotrod/Hotrod.iam
CAD/Hotrod/OldVersions/000_01.0003.iam
CAD/Hotrod/OldVersions/000_02.0001.iam
CAD/Hotrod/OldVersions/000_03.0002.iam
CAD/Hotrod/OldVersions/003.0001.ipt
CAD/Hotrod/OldVersions/004.0001.ipt
CAD/Hotrod/OldVersions/008.0001.ipt
CAD/Hotrod/OldVersions/009.0001.ipt
CAD/Hotrod/OldVersions/016.0001.ipt
CAD/Hotrod/OldVersions/017.0001.ipt
CAD/Hotrod/OldVersions/036.0001.ipt
CAD/Hotrod/OldVersions/Hotrod.0002.iam
CAD/Oktagon Zusammenbau.iam
CAD/Oktagongehäuse/Detektormodul Deckel.ipt
CAD/Oktagongehäuse/Detektormodul Gehäuse.ipt
CAD/Oktagongehäuse/Oktagon.ipt
CAD/Oktagongehäuse/Oktagon_Deckel.ipt
CAD/Oktagongehäuse/OldVersions/Detektormodul Deckel.0020.ipt
CAD/Oktagongehäuse/OldVersions/Detektormodul Gehäuse.0026.ipt
CAD/Oktagongehäuse/OldVersions/Oktagon.0029.ipt
CAD/Oktagongehäuse/OldVersions/Oktagon_Deckel.0016.ipt
CAD/Oktokommander/0805 Capacitor.ipt
CAD/Oktokommander/0805 Inductor.ipt
CAD/Oktokommander/0805 Resistor.ipt
CAD/Oktokommander/16Bit I2C ADC+PGA - ADS1115.iam
CAD/Oktokommander/16bit-i2c-adc-pga-ads1115-1.snapshot.2/0805 Capacitor.ipt
CAD/Oktokommander/16bit-i2c-adc-pga-ads1115-1.snapshot.2/0805 Inductor.ipt
CAD/Oktokommander/16bit-i2c-adc-pga-ads1115-1.snapshot.2/0805 Resistor.ipt
CAD/Oktokommander/16bit-i2c-adc-pga-ads1115-1.snapshot.2/16Bit I2C ADC+PGA - ADS1115.iam
CAD/Oktokommander/16bit-i2c-adc-pga-ads1115-1.snapshot.2/ADS1115.ipt
CAD/Oktokommander/16bit-i2c-adc-pga-ads1115-1.snapshot.2/MSOP10.ipt
CAD/Oktokommander/16bit-i2c-adc-pga-ads1115-1.snapshot.2/SolidEdge/User Library-MSOP10-1.x_t
CAD/Oktokommander/2.1mm_DC_Power_Socket.ipt
CAD/Oktokommander/ADS1115.ipt
CAD/Oktokommander/ARDUINO MICRO.iam
CAD/Oktokommander/Adafruit.ipt
CAD/Oktokommander/Baugruppe4.iam
CAD/Oktokommander/CG0603MLC-05E.ipt
CAD/Oktokommander/Kühlkörper.ipt
CAD/Oktokommander/LDD-1000LW.ipt
CAD/Oktokommander/MH2029-300Y.ipt
CAD/Oktokommander/MICRO - reg.ipt
CAD/Oktokommander/MICRO_17pin_header__.ipt
CAD/Oktokommander/MICRO_220 RESISTOR PACK.ipt
CAD/Oktokommander/MICRO_2pin_header__02.ipt
CAD/Oktokommander/MICRO_402 resistor.ipt
CAD/Oktokommander/MICRO_DIODE CD1206-S01575.ipt
CAD/Oktokommander/MICRO_led2.ipt
CAD/Oktokommander/MSOP10.ipt
CAD/Oktokommander/OktagonElektronik.iam
CAD/Oktokommander/OktagonElektronik_Stage1.iam
CAD/Oktokommander/OktagonElektronik_Stage2.iam
CAD/Oktokommander/OktagonElektronik_Stage3.iam
CAD/Oktokommander/Oktokommander.iam
CAD/Oktokommander/OldVersions/0805 Capacitor.0001.ipt
CAD/Oktokommander/OldVersions/0805 Inductor.0001.ipt
CAD/Oktokommander/OldVersions/0805 Resistor.0001.ipt
CAD/Oktokommander/OldVersions/16Bit I2C ADC+PGA - ADS1115.0003.iam
CAD/Oktokommander/OldVersions/ADS1115.0001.ipt
CAD/Oktokommander/OldVersions/ARDUINO MICRO.0003.iam
CAD/Oktokommander/OldVersions/Adafruit.0001.ipt
CAD/Oktokommander/OldVersions/Baugruppe4.0001.iam
CAD/Oktokommander/OldVersions/Kühlkörper.0002.ipt
CAD/Oktokommander/OldVersions/LDD-1000LW.0002.ipt
CAD/Oktokommander/OldVersions/MSOP10.0001.ipt
CAD/Oktokommander/OldVersions/OktagonElektronik_Stage1.0003.iam
CAD/Oktokommander/OldVersions/OktagonElektronik_Stage1.0005.iam
CAD/Oktokommander/OldVersions/OktagonElektronik_Stage2.0009.iam
CAD/Oktokommander/OldVersions/OktagonElektronik_Stage3.0008.iam
CAD/Oktokommander/OldVersions/Oktokommander.0047.iam
CAD/Oktokommander/OldVersions/Photodiodendummie.0004.ipt
CAD/Oktokommander/OldVersions/Polygonplatine.0004.ipt
CAD/Oktokommander/OldVersions/Polygonplatine.0005.ipt
CAD/Oktokommander/OldVersions/Stage2.0005.ipt
CAD/Oktokommander/OldVersions/Stage3.0007.ipt
CAD/Oktokommander/OldVersions/micro RESET BUTTON.0002.iam
CAD/Oktokommander/OldVersions/micro usb.0002.iam
CAD/Oktokommander/Parabol.ipt
CAD/Oktokommander/Photodiodendummie.ipt
CAD/Oktokommander/Polygonplatine.ipt
CAD/Oktokommander/Stage2.ipt
CAD/Oktokommander/Stage3.ipt
CAD/Oktokommander/USB_female.ipt
CAD/Oktokommander/arduino micro board.ipt
CAD/Oktokommander/arduino-micro-1.snapshot.2/ARDUINO MICRO.iam
CAD/Oktokommander/arduino-micro-1.snapshot.2/CG0603MLC-05E.ipt
CAD/Oktokommander/arduino-micro-1.snapshot.2/MH2029-300Y.ipt
CAD/Oktokommander/arduino-micro-1.snapshot.2/MICRO - reg.ipt
CAD/Oktokommander/arduino-micro-1.snapshot.2/MICRO_17pin_header__.ipt
CAD/Oktokommander/arduino-micro-1.snapshot.2/MICRO_220 RESISTOR PACK.ipt
CAD/Oktokommander/arduino-micro-1.snapshot.2/MICRO_2pin_header__02.ipt
CAD/Oktokommander/arduino-micro-1.snapshot.2/MICRO_402 resistor.ipt
CAD/Oktokommander/arduino-micro-1.snapshot.2/MICRO_DIODE CD1206-S01575.ipt
CAD/Oktokommander/arduino-micro-1.snapshot.2/MICRO_led2.ipt
CAD/Oktokommander/arduino-micro-1.snapshot.2/OldVersions/micro RESET BUTTON.0001.iam
CAD/Oktokommander/arduino-micro-1.snapshot.2/OldVersions/micro usb.0001.iam
CAD/Oktokommander/arduino-micro-1.snapshot.2/arduino micro board.ipt
CAD/Oktokommander/arduino-micro-1.snapshot.2/atmega32U4.ipt
CAD/Oktokommander/arduino-micro-1.snapshot.2/c0402.ipt
CAD/Oktokommander/arduino-micro-1.snapshot.2/micro RESET BUTTON.iam
CAD/Oktokommander/arduino-micro-1.snapshot.2/micro RESET CORE.ipt
CAD/Oktokommander/arduino-micro-1.snapshot.2/micro RESET.ipt
CAD/Oktokommander/arduino-micro-1.snapshot.2/micro mf-msmf050-2.ipt
CAD/Oktokommander/arduino-micro-1.snapshot.2/micro solid tantalum cap 22u.ipt
CAD/Oktokommander/arduino-micro-1.snapshot.2/micro ssot3.ipt
CAD/Oktokommander/arduino-micro-1.snapshot.2/micro usb contact.ipt
CAD/Oktokommander/arduino-micro-1.snapshot.2/micro usb internal.ipt
CAD/Oktokommander/arduino-micro-1.snapshot.2/micro usb shell.ipt
CAD/Oktokommander/arduino-micro-1.snapshot.2/micro usb.iam
CAD/Oktokommander/arduino-micro-1.snapshot.2/micro_crystal 3.2 x 2.5.ipt
CAD/Oktokommander/arduino-micro-1.snapshot.2/micro_lmv358.ipt
CAD/Oktokommander/atmega32U4.ipt
CAD/Oktokommander/c0402.ipt
CAD/Oktokommander/micro RESET BUTTON.iam
CAD/Oktokommander/micro RESET CORE.ipt
CAD/Oktokommander/micro RESET.ipt
CAD/Oktokommander/micro mf-msmf050-2.ipt
CAD/Oktokommander/micro solid tantalum cap 22u.ipt
CAD/Oktokommander/micro ssot3.ipt
CAD/Oktokommander/micro usb contact.ipt
CAD/Oktokommander/micro usb internal.ipt
CAD/Oktokommander/micro usb shell.ipt
CAD/Oktokommander/micro usb.iam
CAD/Oktokommander/micro_crystal 3.2 x 2.5.ipt
CAD/Oktokommander/micro_lmv358.ipt
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
