gniliac1/COSIMA-Laserstar/Dokumentation/Todo.xlsx

TODO | mögliche Rücksendung:
Hütchen für Lampignon berechnen und entwerfen | alle SMD Bauteile (kleine Widerstände, kleine OPV)
Hütchen für Lampignon mit CAD erstellen und drucken | möglicherweise zu viele Multiplexer
mit Marcel über die Bestellungen reden | nicht IR-Dioden
Box-Design mit neuen I2C Expandern überlegen
zwei Schaltungen fertig bauen
zwei Boxen mit CAD erstellen und drucken | mögliche Bestellungen
Arduino Code anpassen
Module testen | 10 neue OPV (groß)
neuronale Netze noch mal testen | mehr von ADS1015 (für mehr Dioden)
eventuell Box für Lampignon | Streifenrasterplatten in der Größe 10 cm x 10 cm (alternativ zurecht schneiden)
wenn alles fertig, Test mit Auto (Christoph fragen)
Code für Betrieb mit Handschuh fertig machen
eventuell neuronale Netze unter Verwendung des Handschuhs konstruieren
