gniliac1/COSIMA-Laserstar/Dokumentation/Abschlussbericht/Todo.txt

Cailing:
--------
- Marketing und Kosten
- Korrektur lesen

Christoph:
----------
- Prinzipskizze Oktokommander (wenn Marcel die Platine hinbekommen hat) check
- Text für Hardware check
- Korrektur lesen check

Daniel:
-------
- Layout
- Beschreibung Software
- Prinzipskizzen mit Fritzing (falls Marcel die Platine nicht hinbekommt)
- Korrektur lesen

Nicole:
-------
- Bilder von den kostruierten Elementen (Oktokommander und Detektormodul)
- Logo für Titelseite
- Korrektur lesen
