gniliac1/COSIMA-Laserstar/Dokumentation/Flyer/Flyer.pdf

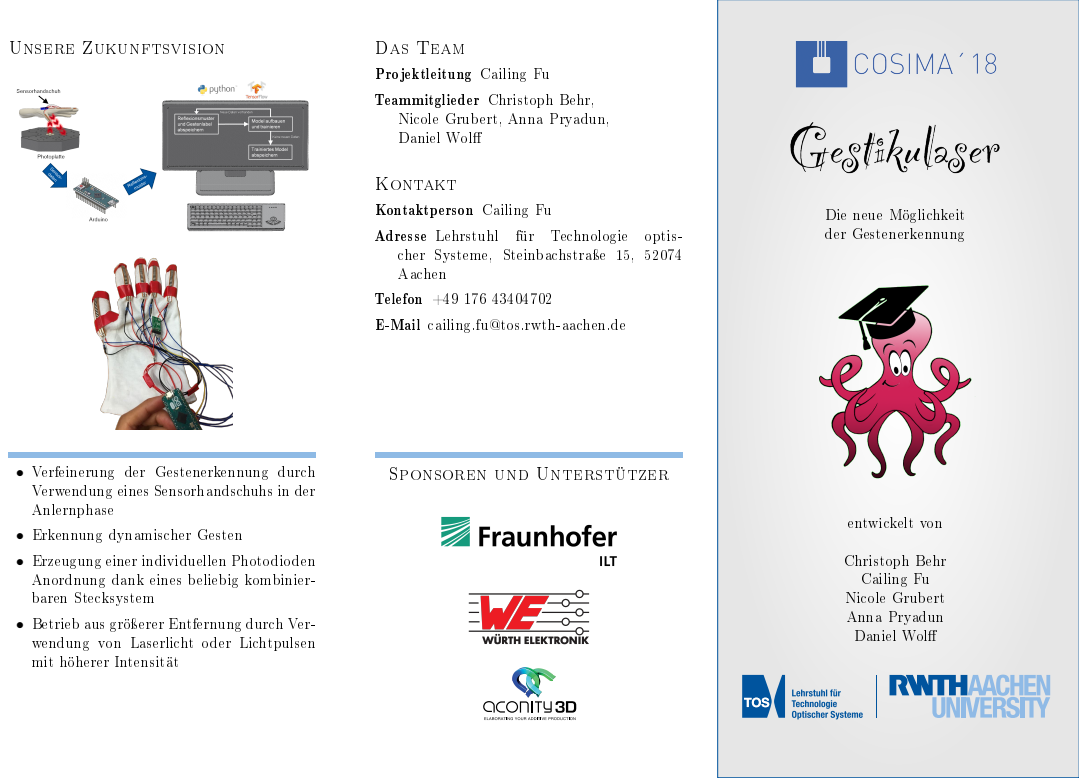
[picture p240: page 1]
Unsere Zukunftsvision; Das Team; Kontakt; entwickelt von; Christoph Behr Cailing Fu Nicole Grubert Anna Pryadun Daniel Wol

Projektleitung Cailing Fu
Teammitglieder Christoph Behr,
Nicole Grubert, Anna Pryadun,
Daniel Wol

Kontaktperson Cailing Fu
Adresse Lehrstuhl für Technologie optis-
cher Systeme, Steinbachstraÿe 15, 52074
Aachen
Telefon +49 176 43404702
E-Mail cailing.fu@tos.rwth-aachen.de

Die neue Möglichkeit
der Gestenerkennung

• Verfeinerung der Gestenerkennung durch
Verwendung eines Sensorhandschuhs in der
Anlernphase
• Erkennung dynamischer Gesten
• Erzeugung einer individuellen Photodioden
Anordnung dank eines beliebig kombinier-
baren Stecksystem
• Betrieb aus gröÿerer Entfernung durch Ver-
wendung von Laserlicht oder Lichtpulsen
mit höherer Intensität

Sponsoren und Unterstützer

Der Gestikulaser

Der Gestikulaser repräsentiert eine neue, innovative Art der Gestenerkennung. Hierbei wird die Hand des Nutzers, während er eine Geste durchführt, von Infrarot-LEDs beleuchtet und das reektierte IR-Licht mit Hilfe von Photodioden detektiert. Das aufgenommene Reek-

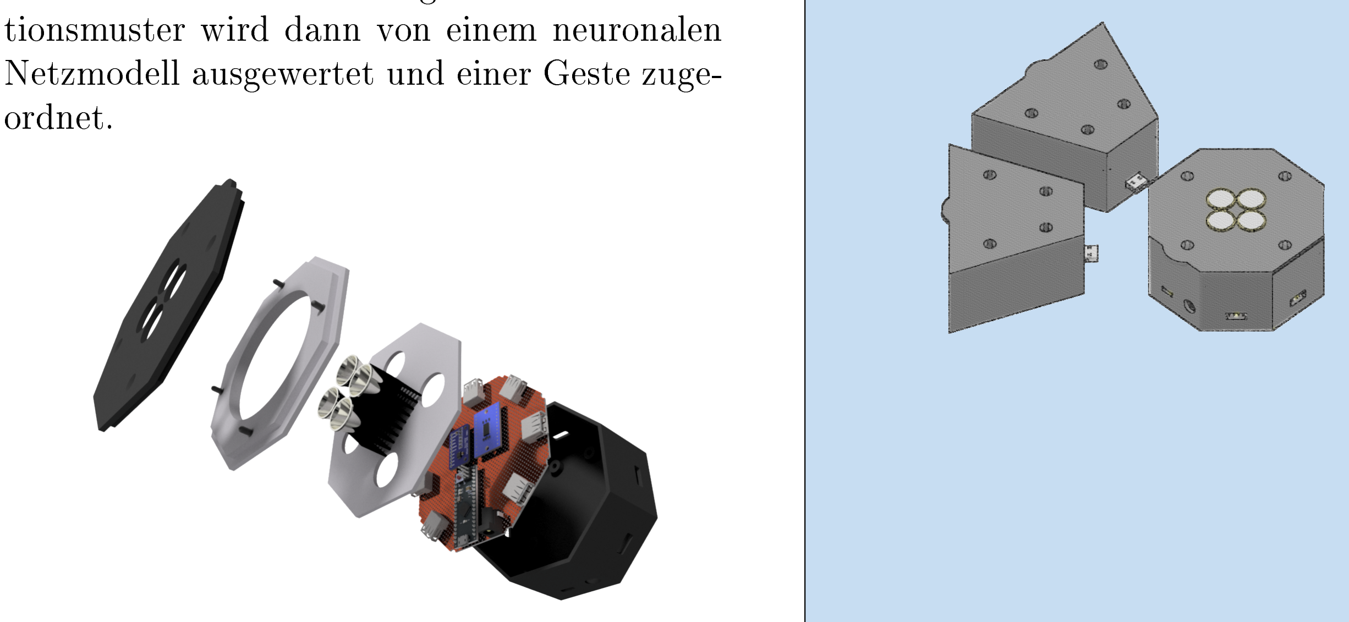
[picture p241: figure]
ordnet.

tionsmuster wird dann von einem neuronalen Netzmodell ausgewertet und einer Geste zuge-

- Robust gegenüber Umgebungslicht durch Verwendung von IR-Licht
- Tag und Nacht einsatzbereit

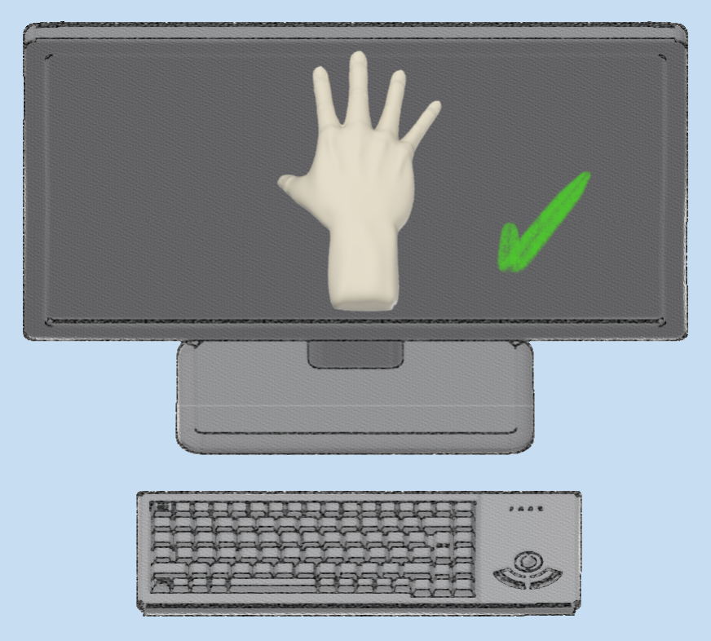
[picture p242: figure]
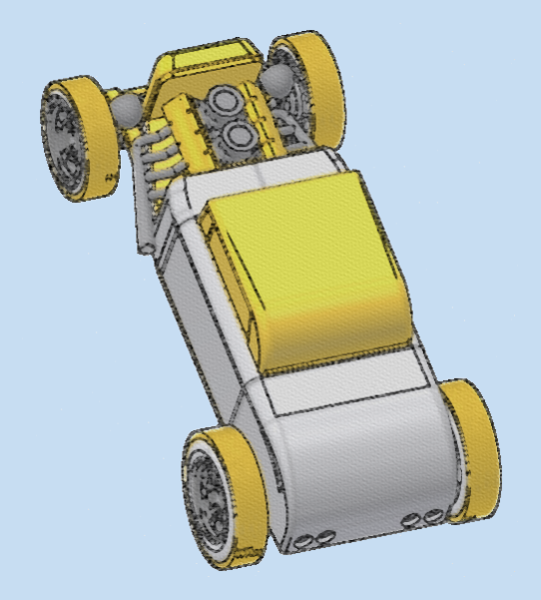
[picture p243: figure]

- Portabel und erweiterbar durch modulares Stecksystem
- Individuell auf die Geste des Nutzers anpassbar
- Geringer Energieverbrauch durch Ver-
wendung | von | sparsamen | integrierten
Stromkreisen und passiven Bauelementen
- Plattformunabhängige Software
- Steuerung von verschiedenen Endgeräten über drahtlose Schnittstellen

Funktionsweise

1) Steckmodule ermöglichen einen leichten Transport,
Aufbau und Modularität
2) Erkennen einer
Handgeste durch
Detektion von
Lichtreektionen

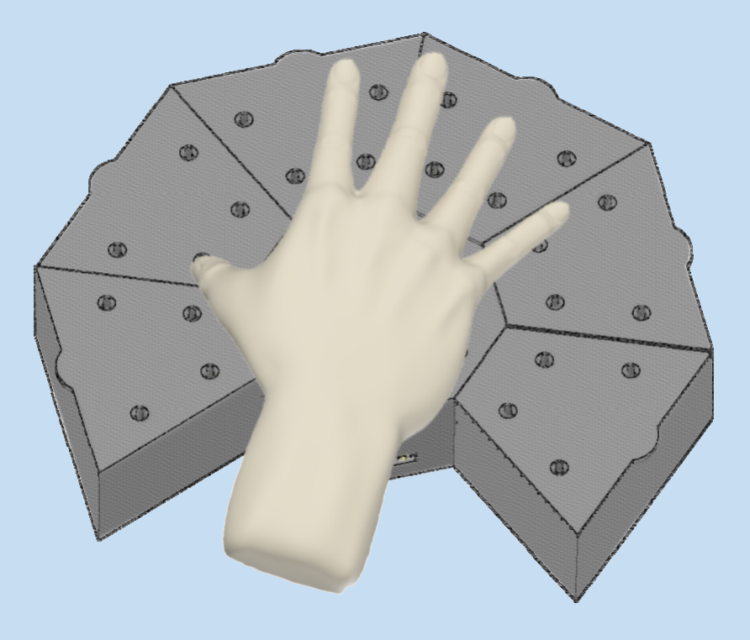
[picture p244: figure]

3) Interpretation der
Reexionsmuster
mit Hilfe eines
Machine Learning
Algorithmus
4) Steuern eines Endgeräts
