gniliac1/COSIMA-Laserstar/Dokumentation/Logos/AC3D_Logo_Print-for-white-eps-converted-to.pdf

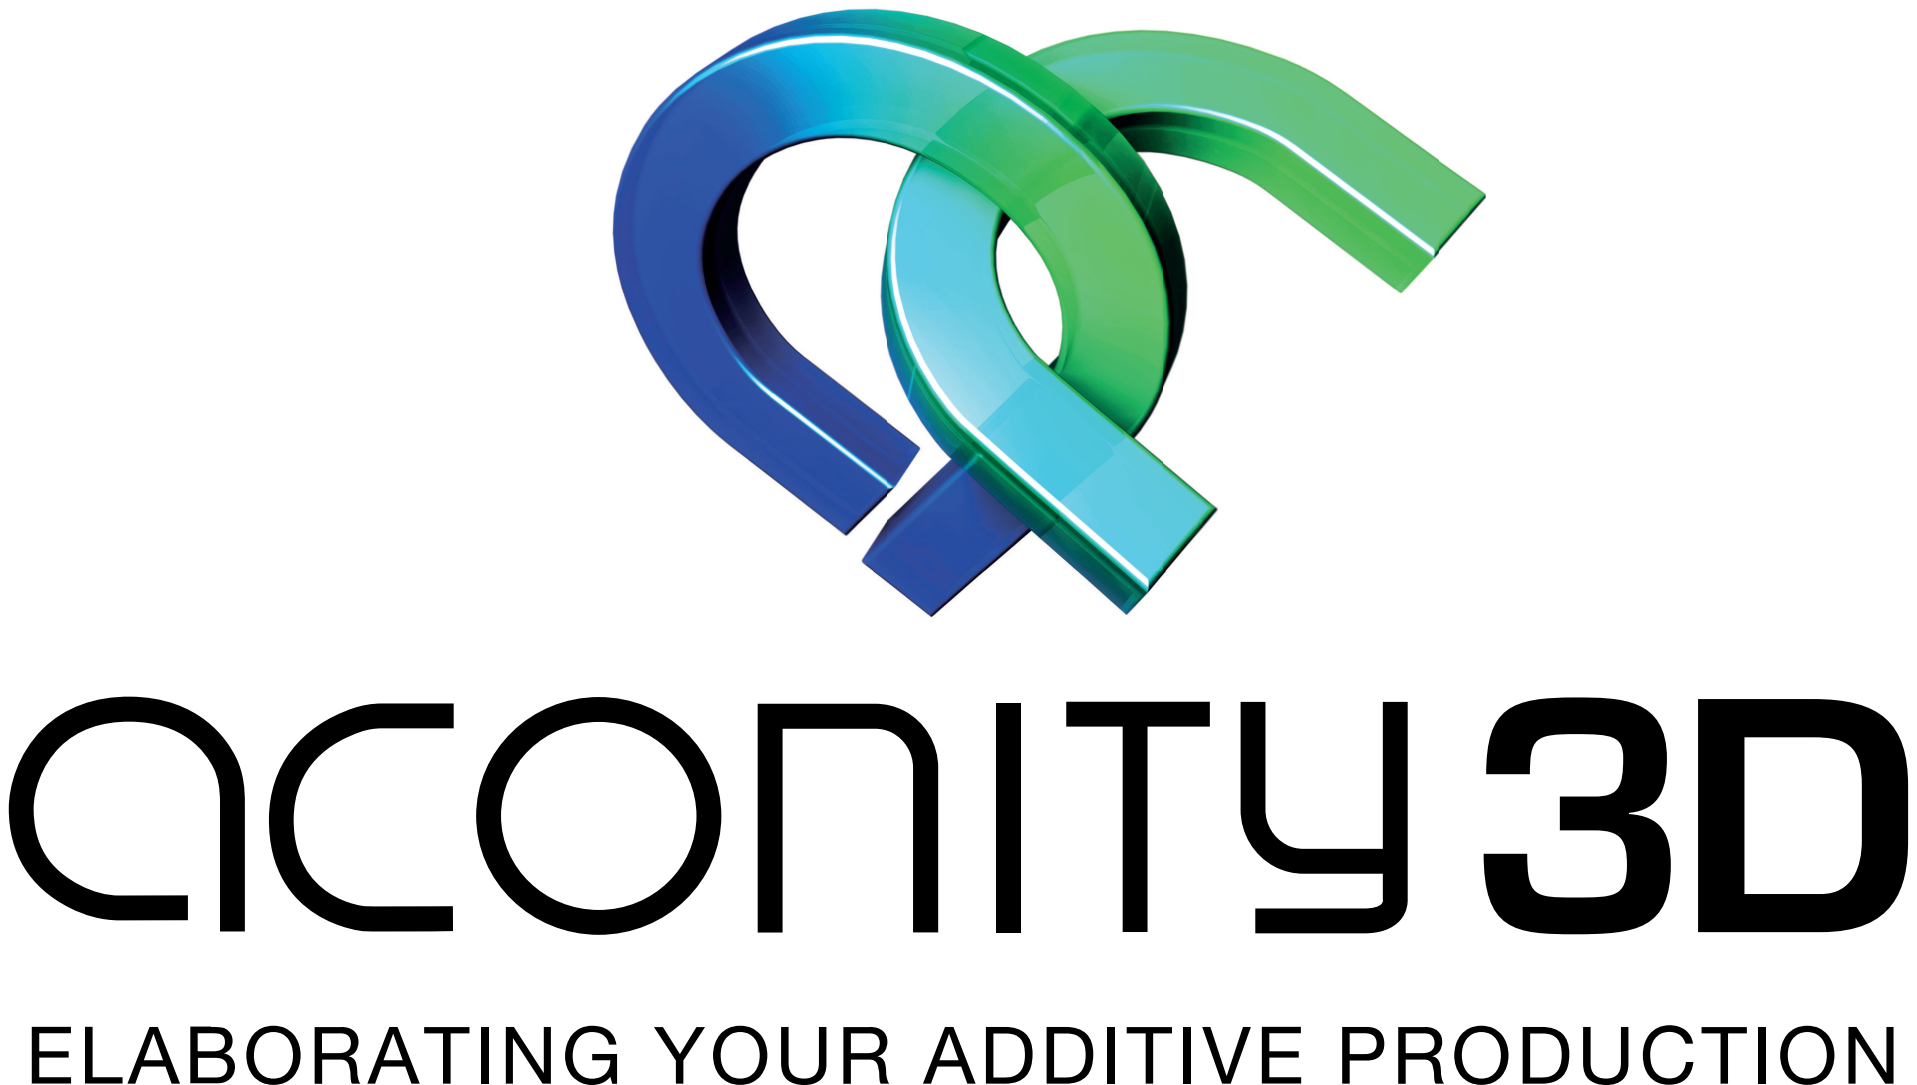
[picture p245: page 1]
