gniliac1/COSIMA-Laserstar/Dokumentation/figures/AblaufSteuerung.pdf

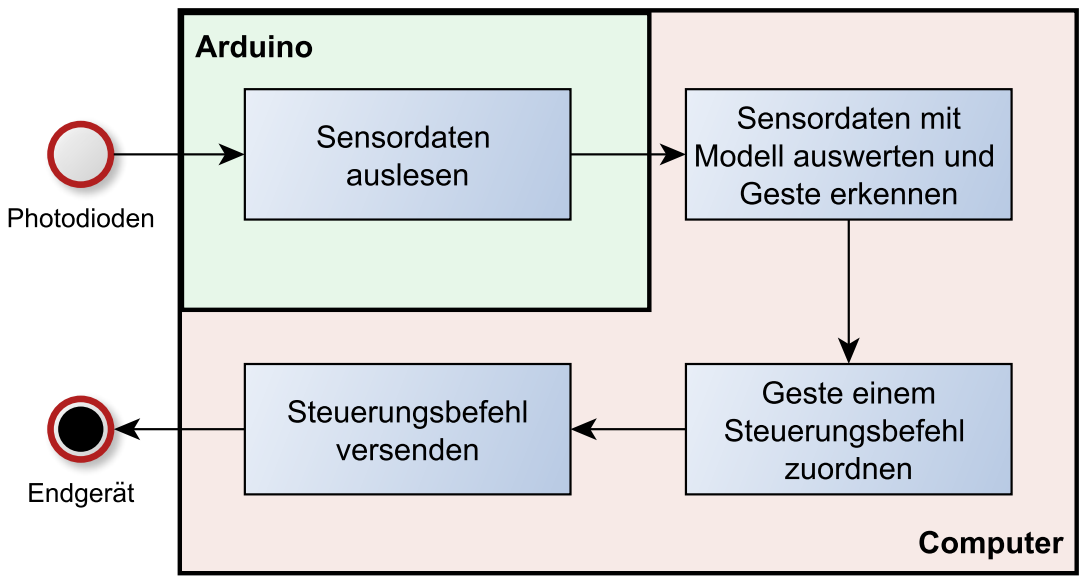
[picture p246: page 1]
