gniliac1/COSIMA-Laserstar/Dokumentation/figures/AblaufTraining.pdf

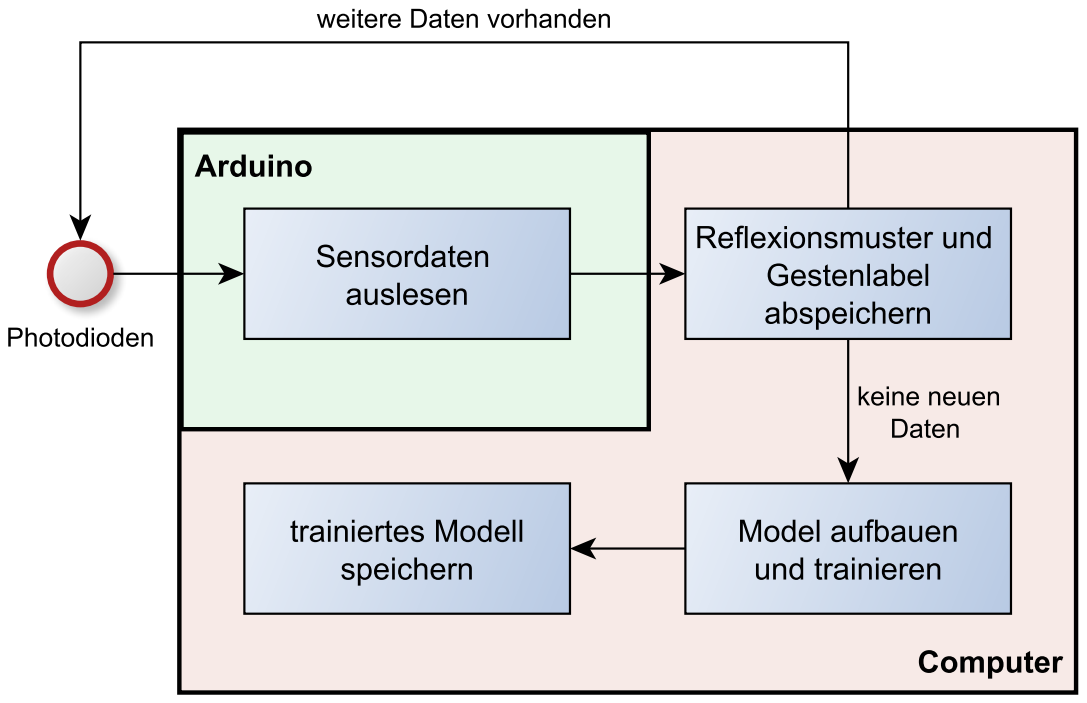
[picture p247: page 1]
