gniliac1/COSIMA-Laserstar/(list of files, drawings)

Other design files:
Dokumentation/figures/Fritzing/FritzingSchem.fzz
Dokumentation/figures/Fritzing/TransimpSchem.fzz
