gniliac1/COSIMA-Laserstar/Elektronik/SchaltplänePCB/PCB/PCB.kicad_pcb

## KiCad design Elektronik/SchaltplänePCB/PCB/PCB.kicad_pcb (2018-10-26)

Schematic: PCB.sch

Parts:
C1, C2, C3, C4: C; C_Axial_L3.8mm_D2.6mm_P7.50mm_Horizontal
D1, D2, D3, D4: LED; LED_D3.0mm_Clear
J1: USB3_A; USB3_A_Plug_Wuerth_692112030100_Horizontal
R1, R2, R3, R4: R; R_Axial_DIN0204_L3.6mm_D1.6mm_P5.08mm_Horizontal
U1, U2: LM358; DIP-8_W7.62mm_Socket

Connections:
GND: D1.2, D2.2, D3.2, D4.2, J1.4, U1.3 (+), U1.4 (V-), U1.5 (+), U2.3 (+), U2.4 (V-), U2.5 (+)
unnamed: C1.1, J1.6, R1.1, U1.7
unnamed: C1.2, D1.1, R1.2, U1.6 (-)
unnamed: C2.1, J1.2, R2.1, U1.1
unnamed: C2.2, D2.1, R2.2, U1.2 (-)
unnamed: C3.1, J1.3, R3.1, U2.1
unnamed: C3.2, D3.1, R3.2, U2.2 (-)
unnamed: C4.1, J1.5, R4.1, U2.7
unnamed: C4.2, D4.1, R4.2, U2.6 (-)
unnamed: J1.1, U1.8 (V+), U2.8 (V+)

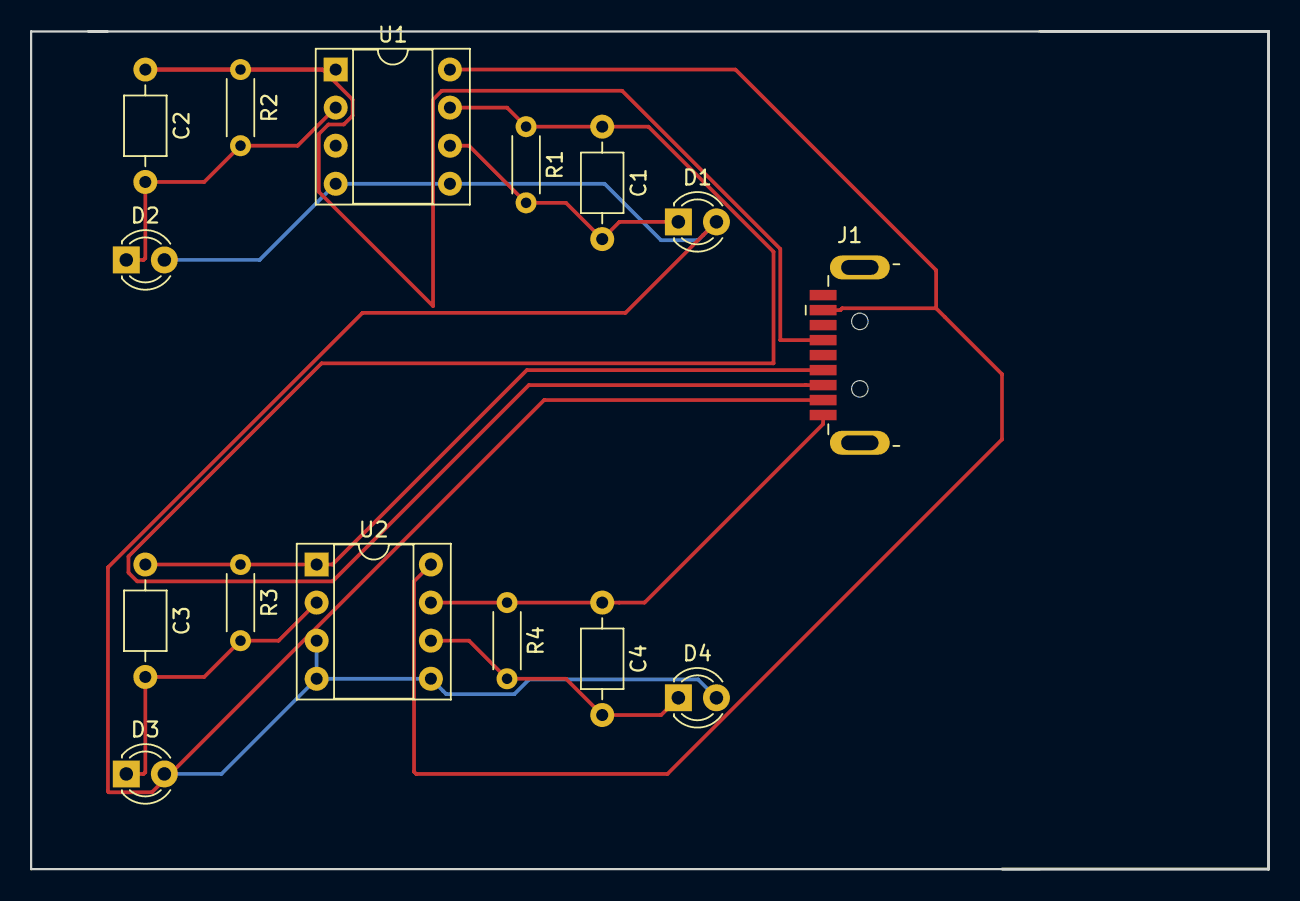
[picture p248: board PCB.kicad_pcb from above]

Board: 2 copper layers, 82.5 x 55.9 mm, 15 parts (0 on the bottom side), 10 nets.
