gniliac1/COSIMA-Laserstar/Elektronik/SchaltplänePCB/Transimpedanz/transimpendanzVerstaerker/transimpendanzVerstaerker.kicad_pcb

## KiCad design Elektronik/SchaltplänePCB/Transimpedanz/transimpendanzVerstaerker/transimpendanzVerstaerker.kicad_pcb (2018-08-16)

Schematic: transimpendanzVerstaerker.sch

Parts:
C1: 1pF; C_0805_2012Metric_Pad1.15x1.40mm_HandSolder
D1: IR204A; LED_D3.0mm_IRBlack
J1: con1; FanPinHeader_1x03_P2.54mm_Vertical
R1: 1MOhm; R_0805_2012Metric_Pad1.15x1.40mm_HandSolder
U1: LM358; SOIC-8_3.9x4.9mm_P1.27mm

Connections:
unnamed: C1.1, J1.2, R1.1, U1.1
unnamed: C1.2, D1.1 (K), R1.2, U1.2 (-)
unnamed: D1.2 (A), J1.1, U1.3 (+), U1.4 (V-)
unnamed: J1.3, U1.8 (V+)

Notes on the sheet:
5V Out GND

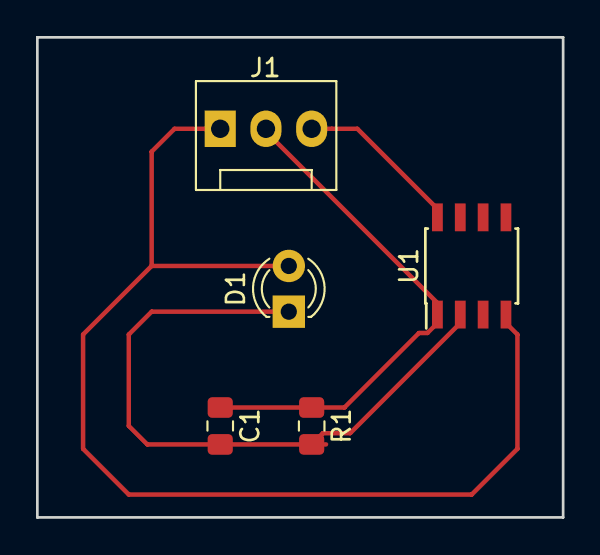
[picture p249: board transimpendanzVerstaerker.kicad_pcb from above]

Board: 2 copper layers, 29.2 x 26.7 mm, 5 parts (0 on the bottom side), 4 nets.
