gniliac1/COSIMA-Laserstar/Elektronik/Adafruit_TCA9548A_1-to-8_I2C_Multiplexer_Breakout/Adafruit_TCA9548A_1-to-8_I2C_Multiplexer_Breakout.ino

#include <Adafruit_ADS1015.h>
#include <SoftwareSerial.h>
#include <Wire.h>

#define TCAADDR 0x70

/* Assign a unique ID to this sensor at the same time */
Adafruit_ADS1015 mux00(0x4A);
Adafruit_ADS1015 mux10(0x4A);
Adafruit_ADS1015 mux20(0x4A);
Adafruit_ADS1015 mux30(0x4A);
Adafruit_ADS1015 mux40(0x4A);
Adafruit_ADS1015 mux50(0x4A);
Adafruit_ADS1015 mux60(0x4A);
Adafruit_ADS1015 mux70(0x4A);


void tcaselect(uint8_t i) {
  if (i > 7) return;
 
  Wire.beginTransmission(TCAADDR);
  Wire.write(1 << i);
  Wire.endTransmission();  
}


void setup(void) 
{
  Serial.begin(9600);
  Serial.println("Multiplexer Breakout Test"); Serial.println("");
  
  /* Initialise the 1st sensor */
  tcaselect(0);
  mux00.begin();
  mux00.setGain(GAIN_EIGHT);

  tcaselect(1);
  mux10.begin();
  mux10.setGain(GAIN_EIGHT);

  tcaselect(2);
  mux10.begin();
  mux10.setGain(GAIN_EIGHT);
  
  tcaselect(3);
  mux10.begin();
  mux10.setGain(GAIN_EIGHT);
  
  tcaselect(4);
  mux10.begin();
  mux10.setGain(GAIN_EIGHT);

  tcaselect(5);
  mux10.begin();
  mux10.setGain(GAIN_EIGHT);

  tcaselect(6);
  mux10.begin();
  mux10.setGain(GAIN_EIGHT);

  tcaselect(7);
  mux10.begin();
  mux10.setGain(GAIN_EIGHT);
  
  Serial.println("Initializing done");
}



void loop(void) 
{
  
  tcaselect(0); // Oktokommander
  int16_t adc00 = mux00.readADC_SingleEnded(0);
  int16_t adc01 = mux00.readADC_SingleEnded(1);
  int16_t adc02 = mux00.readADC_SingleEnded(2);
  int16_t adc03 = mux00.readADC_SingleEnded(3);

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
  Serial.print("Modul 8 Sensor 0 - "); Serial.println(adc70);
  Serial.print("Modul 8 Sensor 1 - "); Serial.println(adc71);
  Serial.print("Modul 8 Sensor 2 - "); Serial.println(adc72);
  Serial.print("Modul 8 Sensor 3 - "); Serial.println(adc73);
  Serial.println("");
  delay(2000);
}
