gniliac1/COSIMA-Laserstar/Software/Code/recordDataGlove.py

# -*- coding: utf-8 -*-
"""
Created on Wed Sep 12 19:30:23 2018

@author: Daniel Wolff
"""

import gestiFuncs as funcs
import sensor
import serial
from time import sleep

# Öffnen der Ports für die Photoplatte und den Sensorhandschuh
# Die COMx Ports müssen abhängig von dem verwendeten PC neu ermittelt werden
print("Opening Serial Port COM4 ...")
photoPort = serial.Serial('COM4', 9600, timeout = .1)
print("... done")
print("Opening Serial Port COM6 ...")
glovePort = serial.Serial('COM6', 9600, timeout = .1)
print("... done")

# Ports schließen, für den Fall, dass das Programm abstürtzt
photoPort.close()
glovePort.close()

# und dann neu öffnen, um damit arbeiten zu können
photoPort.open()
glovePort.open()

# erstelle Objekt für Photoplatte
photoSensors = sensor.PhotoPlatte(nSensors = 16)

# erstelle Objekt für Sensorhandschuh
sensorGlove = sensor.SensorHandschuh()

# erstelle Datei zum Speichern der Datensätze
dataFile = open("data/test.csv","a")

print("Entering Program Loop")

try:
	# eigentliche Programm-Schleife
	while True:
		
		# clear old data
		photoPort.reset_input_buffer()
		glovePort.reset_input_buffer()
		
		####################################
		## lese Daten von der Photoplatte ##
		####################################
		
		# Auslesen der Sensordaten der Photoplatte, solange es noch Änderungen gibt
		# newDataPhoto[0] = Sensornummer, newDataPhoto[1] = Wert
		for counter in range( photoSensors.nSensors ):
			# read two integers from serial port
			newDataPhoto = funcs.readIntgersFromSerialPort(photoPort,2)
			# convert data from string to integer
			newDataPhoto = list(map(int, newDataPhoto))
			print(newDataPhoto)
			# update the value in the data structure
			photoSensors.setSensorData(newDataPhoto)
		
		####################################
		## lese Daten vom Sensorhandschuh ##
		####################################
		
		# schicke Anfrage 
		glovePort.write('a'.encode('utf-8'))
			
		# Auslesen der Sensordaten der Photoplatte, solange es noch Änderungen gibt
		# newDataGlove[0] = Sensornummer, newDataGlove[1:3/5] = Wert
		# newDataGlove[0] == 0 -> compass, 3 Werte
		# newDataGlove[0] == 1 -> accelerometer, 3 Werte
		# newDataGlove[0] == 2 -> gyroscope, 3 Werte
		# newDataGlove[0] == 3 -> bending sensor, 5 Werte
		for counter in range( sensorGlove.nSensors ):
			# read integers from serial port
			if counter == sensorGlove.nSensors-1:
				newDataGlove = funcs.readIntgersFromSerialPort(glovePort,6)
			else:
				newDataGlove = funcs.readIntgersFromSerialPort(glovePort,4)
			# convert data from string to integer
			newDataGlove = list(map(int, newDataGlove))
			print(newDataGlove)
			# update the value in the data structure
			sensorGlove.setSensorData(newDataGlove)
		
		#############################
		## schreibe Daten in Datei ##
		#############################
		
		# write sensor array to the specified file
		photoSensors.writeSensorData(dataFile)
		# write the values corresponding to the current gesture
		sensorGlove.writeSensorData(dataFile)
		
		# zum testen, etwas warten
		print("\n\n")
		
except KeyboardInterrupt:

	dataFile.close()
	print("Closing Ports")
	photoPort.close()
	glovePort.close()
	print("Done")
