gniliac1/COSIMA-Laserstar/Elektronik/serialCommunicationPython/serialTest.py

# -*- coding: utf-8 -*-
"""
Created on Fri Aug 10 11:17:44 2018

@author: chris
"""

import serial
bt = serial.Serial('COM5', 9600, timeout =.1) #COMx is used COM-Port x must be checked on PC
bt.open()

while bt:
    data = bt.readline()[:-2]
    if data:
        print (data)
    if (data=='exit'):        
        bt.close()
