gniliac1/COSIMA-Laserstar/(commit log)

2018-05-16 Repository eröffnet!
    [COSIMA_Zeitplanung.xlsx]
2018-06-21 Präsentation überarbeitet
    Ich habe hier und da mal ein paar Kommentare unter den Folien gemacht. Schaut euch die Präsentation noch mal an und sagt mir, was ihr davon haltet :)
2018-07-17 Added Schematic
    Schaltplan für den I2C-Expander (nur zwei IR-LEDS eingefügt)
2018-07-19 Bilder für die Präsi
2018-07-19 Präsentation überarbeitet
    - Habe unser Konzept mit der Photoplatte hinzugefügt.
    Verbesserungsvorschläge erwünscht
    - Der Text für "Unser Produkt" und "Anwendungsmöglichkeiten" wurde noch
    nicht überarbeitet
2018-07-26 präsentation bearbeitet
    [Diagramm in Microsoft PowerPoint.xlsx, Kostenschätzung COSIMA.xlsx]
2018-07-26 Addon
    Added Instagram folder and uploaded circuit pictures
2018-07-26 Kostenschätzung überarbeitet
    [Einkaufsliste_Elektronik.xlsx, Kostenschätzung COSIMA.xlsx]
2018-07-26 Folien als pdf, Sponsorentabelle
    [Kostenschätzung COSIMA.xlsx, Sponsorenliste.xlsx]
2018-07-26 noch irgendwas geändert
    [COSIMA_Zeitplanung.xlsx, Kostenschätzung COSIMA.xlsx]
2018-08-01 sponsorenliste überarbeitet
    [Sponsorenliste.xlsx]
2018-08-03 Anwendungsmöglichkeiten und Produktbeschreibung geändert
2018-08-05 machine learning how to install and to use
    [TestDatabase.csv]
2018-08-05 Dokumentiertes Beispiel für Benutzung von TensorFlow hinzugefügt
    Aufruf aus der Konsole / Terminal mittels:
    python tf_tutorial.py
2018-08-05 Reading data from .csv file
    [TestDatabase.csv]
2018-08-05 Überlegungen zum Ablauf des Machine Learnings
2018-08-05 Added new files
    -arduino code for rc car (unfinished slightly working)
    -hugo pictuer for instagram
2018-08-05 export database with 10% test and 90% train data
    [ExportedDatabaseTest.csv, ExportedDatabaseTrain.csv]
2018-08-06 Sponsoren
    Email an:
    RS Components
    Reichelt
    fanuc
    [Sponsorenliste.xlsx]
2018-08-06 marketing updated
    [ExportedDatabaseTest.csv, ExportedDatabaseTrain.csv, Sponsorenliste.xlsx, TestDatabase.csv]
2018-08-06 update Sponsorenliste
    Neue potentielle Sponsoren hinzugefügt
    [Sponsorenliste.xlsx]
2018-08-06 Biegesensor
    Der aus dem Powerglove!!! den will ich haben!!!
2018-08-07 created folder CAD
    Added cad file for octagon
    Added pictures and measurements for the rc car
    [oktagonOben.0002.ipt, oktagonOben.ipt, oktagonUnten.ipt]
2018-08-08 Update
    Meinen Namen auf der ersten Folie hinzugefügt
2018-08-08 Test
    Test
    [Sponsorenliste.xlsx]
2018-08-08 Update Sponsorenliste
    neue Sponsoren
    neue Emailadressen
    [Sponsorenliste.xlsx]
2018-08-08 Elektrofachhändler als Sponsoren
    Media Markt & Saturn Aachen
    [Sponsorenliste.xlsx]
2018-08-08 Update
    Sponsoren angerufen
    [Sponsorenliste.xlsx]
2018-08-08 projektbeschreibung angefangen
    noch nicht fertig, wird weiter fortgesetzt
2018-08-09 Projektbeschreibung fortgeführt
    es fehlt der Abschnitt zum Machine Learning
2018-08-09 Sixt als Sponsor ?
    [Sponsorenliste.xlsx]
2018-08-09 update sponsorliste
    [Sponsorenliste.xlsx]
2018-08-09 Export .ipt to .step
    [oktagonOben.stp, oktagonUnten.stp]
2018-08-12 Read Sensor/ write to bluetooth
2018-08-12 Abbildungen für die Software erstellt
    + Ordner "Machine Learning" in "Software" umbenannt
    + Projektbeschreibung etwas überarbeitet
    + Flussdiagramm, Ablaufdiagramme und Use Case vollständig
    TODO:
    + Klassendiagramm muss noch erstellt werden
    [ExportedDatabaseTest.csv, ExportedDatabaseTrain.csv, TestDatabase.csv]
2018-08-13 Implemented i2c, ADS1015
    Implemented:
    -i2c wiring
    -Ardafriut library for easy communication with the ads1015 protboard (Needs testing!)
    -Bluetooth communication to python still available
2018-08-15 update sponsoring
    Absagen u. neue Sponsoren
    [Sponsorenliste.xlsx]
2018-08-15 Update Elektronik
    -Deleted unused files
    -Added PCB Files for OPAmp
    -Updated Python script for
    serial communication
    [transimpendanzVerstaerker.kicad_pcb, transimpendanzVerstaerker.sch]
2018-08-15 Mehr Diagramme und Code angefangen
2018-08-16 updated and finished pcb designe for opamo
    [transimpendanzVerstaerker.kicad_pcb]
2018-08-16 finished test pcb layout
    [transimpendanzVerstaerker.kicad_pcb]
2018-08-16 removed titles
    [transimpendanzVerstaerker.kicad_pcb]
2018-08-18 Notlösungs Board (WIP)
    [sensorBoard.kicad_pcb, sensorBoard.sch]
2018-08-20 Schaltplan fertig
    [sensorBoard.sch]
2018-08-23 Added ESP32 PWM not working yet
    [esp32BlueSer.ino, serialWrite.py]
2018-08-25 i2c Sensor
    -Rough tested
2018-08-25 rearragend folders
    deleted obsolete code for sensor reading
    [sensorBoard.kicad_pcb, sensorBoard.sch, transimpendanzVerstaerker.kicad_pcb, transimpendanzVerstaerker.sch]
2018-08-31 Code for sensorGlove
2018-09-03 Read all sensorvalues
2018-09-03 Solved first TODO
    TODO: Testen ob öffnen und schießen besser ist
    Siehe meine Kommentare ;)
    [main.py]
2018-09-06 updated sensorGlove
2018-09-14 improved accuracy of NN
    [ExportedDatabase.csv, ExportedDatabaseTest.csv, ExportedDatabaseTrain.csv]
2018-09-17 communication between arduino and python
2018-09-19 Kostenanpassung
    Fehler in der Summe der Kosten
2018-09-20 added gain for better detection of photo current changes
2018-09-20 renamed directory according to convention of arduino ide
2018-09-20 added specification sheet for i2c multiplexer
2018-09-20 added code to write data to an external file
    - insert linebreaks after input values and after target values
    - do some exception handlings
    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
    [photoData.csv]
2018-09-21 improved reflection detection code
    [photoData.csv, photoData_flach.csv, photoData_links.csv]
2018-09-21 added data for training the neuronal net
    [photoData_flach.csv, photoData_links.csv, photoData_rechts.csv]
2018-09-24 adapted script for recording data using the glove
    [test.csv]
2018-09-24 CAD Lampignon
    stl und ipt
    [Lampignon_20x10.ipt, Lampignon_20x10.stl, Lampignon_20x15.ipt, Lampignon_20x15.stl, Lampignon_25x10.ipt, Lampignon_25x10.stl, Lampignon_25x20.ipt, Lampignon_25x20.stl]
2018-09-24 adapted ml
    [photoData_flach.csv, photoData_links.csv, photoData_rechts.csv]
2018-09-25 added data folder and moved data files
    [photoData.csv, photoData_flach.csv, photoData_links.csv, photoData_rechts.csv, test.csv]
2018-09-25 changes from today including a first version of a working NN
    [test.csv]
2018-09-25 added addtional data
    [flach_neu.csv, links_neu.csv, rechts_neu.csv]
2018-09-26 added data sheets and code for new multiplexers as well as a todo for the time of Cailing's holidays
    [Todo.xlsx]
2018-09-26 ordered todo list by importance
    [Todo.xlsx]
2018-09-27 added datasheets for leds
2018-09-30 Ordner für Dokumentation hinzugefügt
    [Kostenschätzung COSIMA.xlsx, Todo.xlsx]
2018-09-30 Ideen zur Konstruktion der Module hinzugefügt
2018-10-01 Oktagon
    Arduino Gehäuse
    [Arduino_Oktagon.iam, Oktagon.0001.ipt, Oktagon.ipt, Oktagon_Deckel.0002.ipt, Oktagon_Deckel.ipt]
2018-10-15 Größerer Oktagon
    Änderung
    [Arduino_Oktagon.0002.iam, Arduino_Oktagon.iam, Oktagon.0001.ipt, Oktagon.0002.ipt, Oktagon.ipt, Oktagon_Deckel.0002.ipt, Oktagon_Deckel.0004.ipt, Oktagon_Deckel.ipt]
2018-10-15 CAD Änderungen
    [Arduino_Oktagon.0002.iam, Arduino_Oktagon.0004.iam, Arduino_Oktagon.iam, Modul Deckel.0001.ipt, Modul Deckel.ipt, Modul Gehäuse.0001.ipt, Modul Gehäuse.ipt, Modul.0001.iam]
2018-10-20 Platine
    Platine
    [PCB.kicad_pcb, PCB.sch, _saved_PCB.sch]
2018-10-26 Kapitel eingebunden und erste Überlegungen zur Gliederung
2018-10-26 kleine Änderungen an der Titelseite
2018-10-26 Änderungen von Cailing an der main Datei wiederhergestellt
2018-10-28 Fritzing Scheme
    finde ich recht unübersichtlich.... kriege es aber mangels platz nicht wirklich besser hin :(...
    [FritzingSchem.fzz]
2018-10-28 neue bilder
    [FritzingSchem.fzz]
2018-10-30 CAD
    Konstruktion
    [Arduino_Oktagon.0004.iam, Arduino_Oktagon.0008.iam, Arduino_Oktagon.iam, DeckelParabol.0001.iam, DeckelParabol.iam, Kühlkörper.ipt, Modul Deckel.0001.ipt, Modul Deckel.0003.ipt]
2018-10-30 E-Parts
    CAD-Dateien eingefügt
    [16Bit I2C ADC+PGA - ADS1115.iam, ARDUINO MICRO.iam, Adafruit.ipt, Arduino_Oktagon.0008.iam, Arduino_Oktagon.0011.iam, Arduino_Oktagon.iam, Modul Gehäuse.0003.ipt, Modul Gehäuse.0004.ipt]
2018-10-31 CAD
    Oktokommander
    [0805 Capacitor.ipt, 0805 Inductor.ipt, 0805 Resistor.ipt, 16Bit I2C ADC+PGA - ADS1115.0001.iam, 16Bit I2C ADC+PGA - ADS1115.0002.iam, 16Bit I2C ADC+PGA - ADS1115.iam, 16Bit I2C ADC+PGA - ADS1115.stp, 2.1mm_DC_Power_Socket.ipt]
2018-11-01 CAD Bilder
2018-11-01 Oktokommander und Detektormodul
    CAD
    [DetektorElektronik_Stage1.0002.iam, DetektorElektronik_Stage1.iam, Detektormodul Deckel.0011.ipt, Detektormodul Deckel.0012.ipt, Detektormodul Deckel.ipt, Detektormodul Gehäuse.0015.ipt, Detektormodul Gehäuse.ipt, Detektormodul.0017.iam]
2018-11-01 added chapter "Stand der Technik"
2018-11-02 Projektbericht Konstruktion
    Beschreibung der wichtigsten Besonderheiten der Konstruktion, den Aufbau und das Hinzufügen von weiteren Bildern
2018-11-03 Neue Logos und ein Video
    ILT und aconity Logo in besserer Qualität
    Video vom Zusammenbau des Gestikulasers
    [0805 Capacitor.0001.ipt, 0805 Capacitor.ipt, 0805 Inductor.0001.ipt, 0805 Inductor.ipt, 0805 Resistor.0001.ipt, 0805 Resistor.ipt, 16Bit I2C ADC+PGA - ADS1115.0002.iam, 16Bit I2C ADC+PGA - ADS1115.0003.iam]
2018-11-03 bilder umbenannt und in report aufgenommen
2018-11-06 Logos und T-Shirts
    [Gestikulaser.0002.ipn, Gestikulaser.0003.ipn, Gestikulaser.ipn]
2018-11-06 Bilder Zeichnungen
    [DetektorElektronik_Stage1.0003.iam, DetektorElektronik_Stage1.0006.iam, DetektorElektronik_Stage1.iam, Detektormodul Deckel.0013.ipt, Detektormodul Deckel.0014.ipt, Detektormodul Deckel.ipt, Detektormodul Gehäuse.0016.ipt, Detektormodul Gehäuse.0017.ipt]
2018-11-07 Bilder überarbeitet
    [FritzingSchem.fzz, TransimpSchem.fzz]
2018-11-08 neue CAD Dateien und steps und ....
    [000_01.0003.iam, 000_01.iam, 000_02.0001.iam, 000_02.iam, 000_03.0002.iam, 000_03.iam, 001.ipt, 003.0001.ipt]
2018-11-09 Bilder für Flyer
    [Detektormodul Deckel.0016.ipt, Detektormodul Deckel.ipt, Detektormodul Gehäuse.0019.ipt, Detektormodul Gehäuse.0020.ipt, Detektormodul Gehäuse.ipt, Detektormodul.0025.iam, Detektormodul.0026.iam, Detektormodul.iam]
2018-11-10 Neue CAD Bilder
    [DetektorElektronik_Stage2.0003.iam, DetektorElektronik_Stage2.iam, Detektormodul.0026.iam, Detektormodul.0029.iam, Detektormodul.iam, Gestikulaser.0015.iam, Gestikulaser.0017.iam, Gestikulaser.iam]
2018-11-10 nicoles namen in die zweite zeile verschoben
2018-11-10 CAD und Bildmaterial geändert
    Neue Wandstärke Detektormodul, Bohrung Oktokommander angepasst.
    Bilder: Sensorhandschuh, Detektormodul und Oktokommander (Wasserfarben und raytraced aus zwei Positionen)
    [DetektorElektronik_Stage1.0008.iam, DetektorElektronik_Stage1.iam, DetektorElektronik_Stage2.0003.iam, DetektorElektronik_Stage2.0004.iam, DetektorElektronik_Stage2.iam, Detektormodul Deckel.0016.ipt, Detektormodul Deckel.0018.ipt, Detektormodul Deckel.ipt]
2018-11-10 stl Druckdateien
    7x Stage 2
    1x Stage 3
    1x Stage 2 Oktokommander
    [Stage2 Oktokommander.stl, Stage2.stl, Stage3.stl]
2018-11-11 Dateien druckoptimiert
    [Lampignon_20x10.stl, Lampignon_20x15.stl, Lampignon_25x10.stl, Lampignon_25x20.stl, Oktagon.stl, OktagonElektronik_Stage2.0007.iam, OktagonElektronik_Stage2.0008.iam, OktagonElektronik_Stage2.iam]
2018-11-11 Anpassung Konstruktion
    Detektorgehäuse und Deckel angepasst
    [DetektorElektronik_Stage1.0006.iam, DetektorElektronik_Stage1.0008.iam, DetektorElektronik_Stage1.0009.iam, DetektorElektronik_Stage1.iam, DetektorElektronik_Stage2.0004.iam, DetektorElektronik_Stage2.0006.iam, DetektorElektronik_Stage2.iam, Detektormodul Deckel.0018.ipt]
2018-11-12 Bilder Arduino, Anpassung Druck
    [DetektorElektronik_Stage2.0006.iam, DetektorElektronik_Stage2.0007.iam, DetektorElektronik_Stage2.iam, Detektormodul Deckel.0015.ipt, Detektormodul Deckel.0019.ipt, Detektormodul Deckel.0020.ipt, Detektormodul Deckel.ipt, Detektormodul Gehäuse.0023.ipt]
2018-11-12 Bilder bearbeitet und neue hinzugefügt
2018-11-12 poster und Flyer überarbeitet
2018-11-12 Transparenter Sensorhandschuh
2018-11-13 Test für die Stecker
    Das Andere unter "Oktokommander" habe ich nicht verstanden
